hbmartin/tesla-iphone-holder/revisions/v3-draft/output/reference/console_bare.jpg

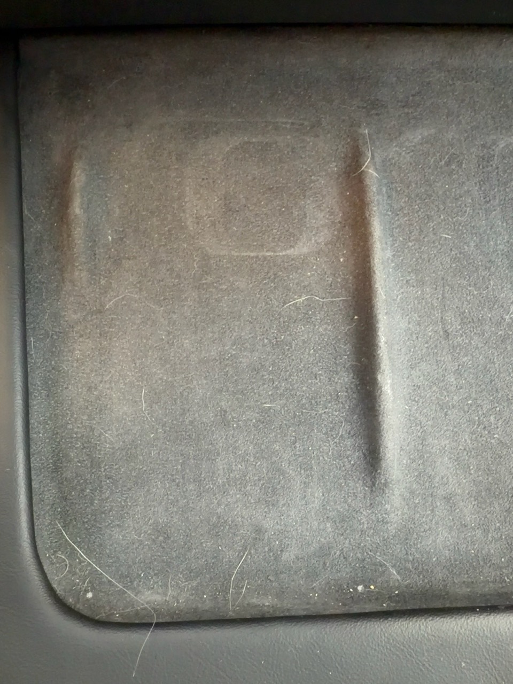
revisions/v3-draft/output/reference/console_bare.jpg
