hbmartin/tesla-iphone-holder/revisions/v3-draft/output/reference/fit_v2.jpg

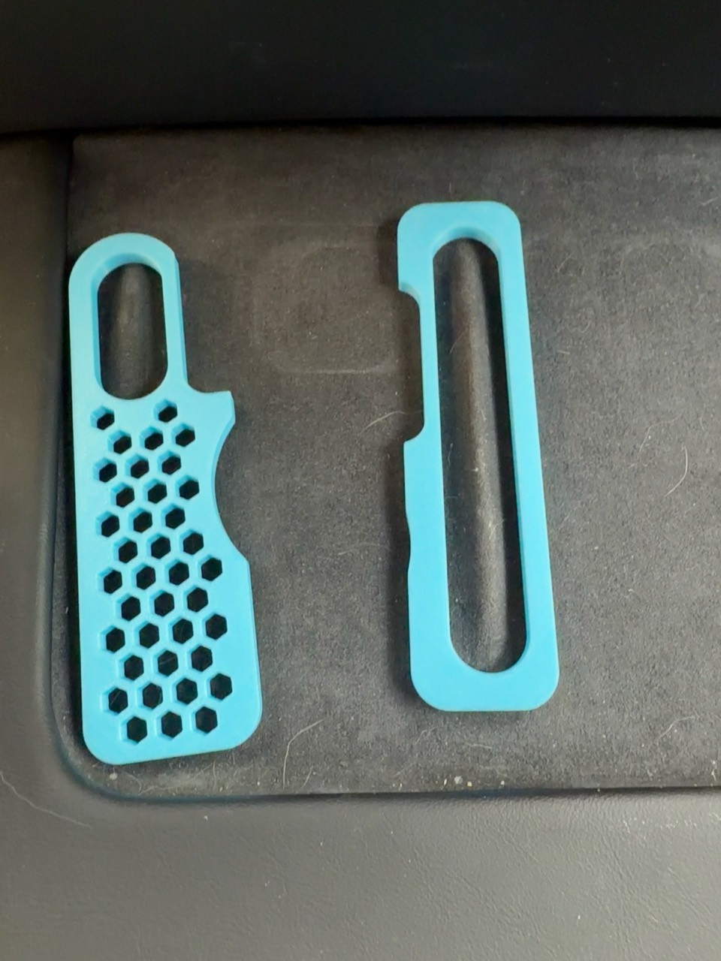
revisions/v3-draft/output/reference/fit_v2.jpg
