hbmartin/tesla-iphone-holder/output/pdf/contour_trace_grid_letter.pdf

# CONTOUR TRACING GRID

Profile ID: __________ Actual station / height: __________________________ Direction: __________ Repeat: ______ Date: __________ Pin spacing: _____

US Letter | Print at Actual size / 100% | 1 mm squares; heavier lines every 5 and 10 mm

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
0 | 0
10 | 10
20 | 20
30 | 30
40 | 40
50 | 50
60 | 60
70 | 70
80 | 80
90 | 90
100 | 100
110 | 110
120 | 120
130 | 130
140 | 140
150 | 150
160 | 160
170 | 170
180 | 180
190 | 190
200 | 200
210 | 210
100 mm - measure between the end ticks | Check this bar with a ruler.
| Also check 100 mm vertically.
Draw the console pad baseline and direction on your trace. Grid numbers are paper coordinates.
