hbmartin/tesla-iphone-holder/output/v9/outward_face_down/README.txt

V9 — OUTWARD FACE DOWN
Prepared at the user's request on 2026-11-05.

Both inserts are rigidly rotated so the face pointing outward from the console
faces the build plate. Its main tapered plane is leveled onto the plate.
The X rotation is 178.8285409 degrees: a flip plus compensation for the 1.1714591
degree taper. This is a rotation, not a mirror or geometry modification.
The console-facing underside and wider nub openings face upward during printing.

Use Holder_V9_A1_PLA_OUTWARD_FACE_DOWN.gcode.3mf for the sliced plate, or
Holder_V9_A1_PLA_OUTWARD_FACE_DOWN_SLICED.3mf for the Studio-saved project.
The STLs in THIS directory are already oriented for printing. The original V9
installed-coordinate CAD/STLs and previous plate remain in the parent directory.

Bambu A1 / 0.4 mm nozzle / Generic PLA / textured PEI / 0.20 mm layers /
three walls / 20% gyroid / no brim / automatic normal snug supports from bed.
Support threshold 45 degrees, top separation 0.20 mm, XY separation 0.35 mm.
The nub walls widen upward in this orientation. Automatic supports remain for
recessed phone-contact regions and console edge transitions as required.
The small recessed contact regions cannot all lie on the same plane; the main
outward taper plane rests directly on the bed, with over 3000 square mm of
contact area per part. Original part dimensions remain unchanged.

Validation checks the rigid transform, source hashes, downward outward-plane
normal, bed contact, volume, actual sliced layers, supports, thin original lower
edges, embedded settings and the Studio-saved geometry/G-code.
Verified Studio estimate: 54 min 33 sec; 19.63 g PLA.
Geometry, orientation, model layers, supports and Studio export checks passed.
Disable timelapse when sending to the printer. No job has been dispatched.
Physical fit and the retained lens-contact diagnostic remain unverified.
