hbmartin/tesla-iphone-holder/curve gauge photos/IMG_0162.jpeg

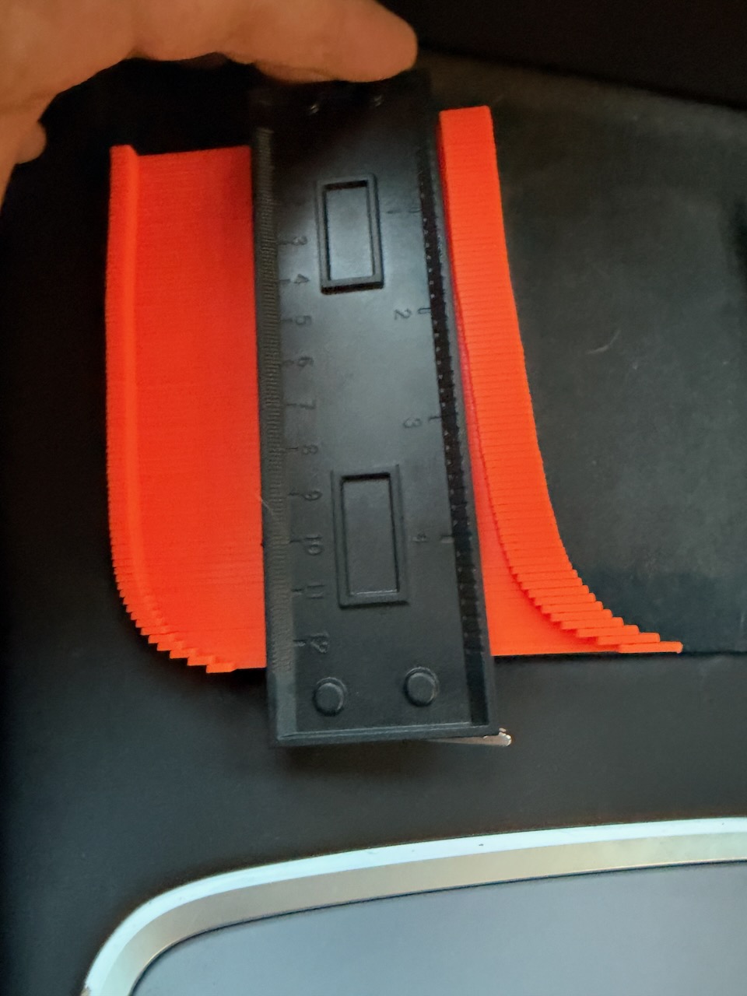
curve gauge photos/IMG_0162.jpeg
