hbmartin/tesla-iphone-holder/curve gauge photos/IMG_0163.jpeg

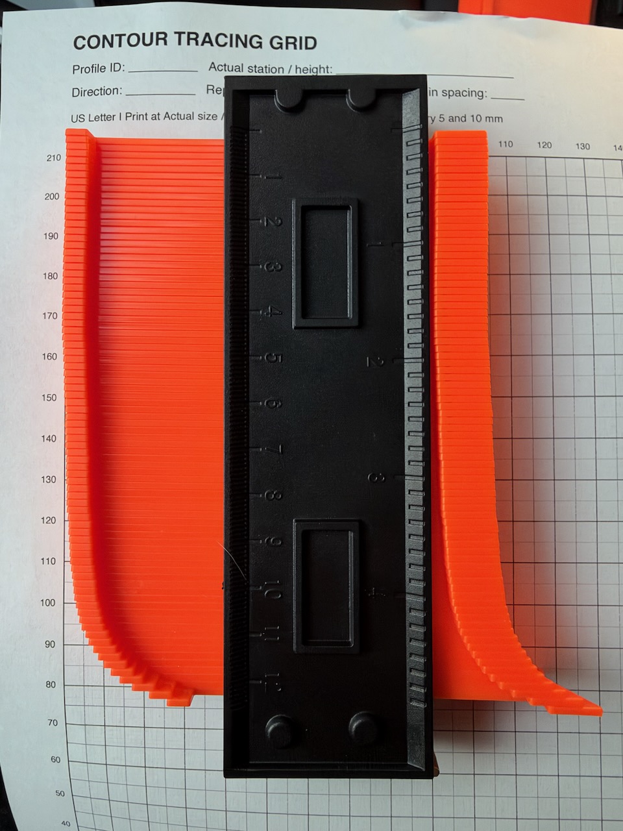
curve gauge photos/IMG_0163.jpeg
