hbmartin/tesla-iphone-holder/curve gauge photos/IMG_0164.jpeg

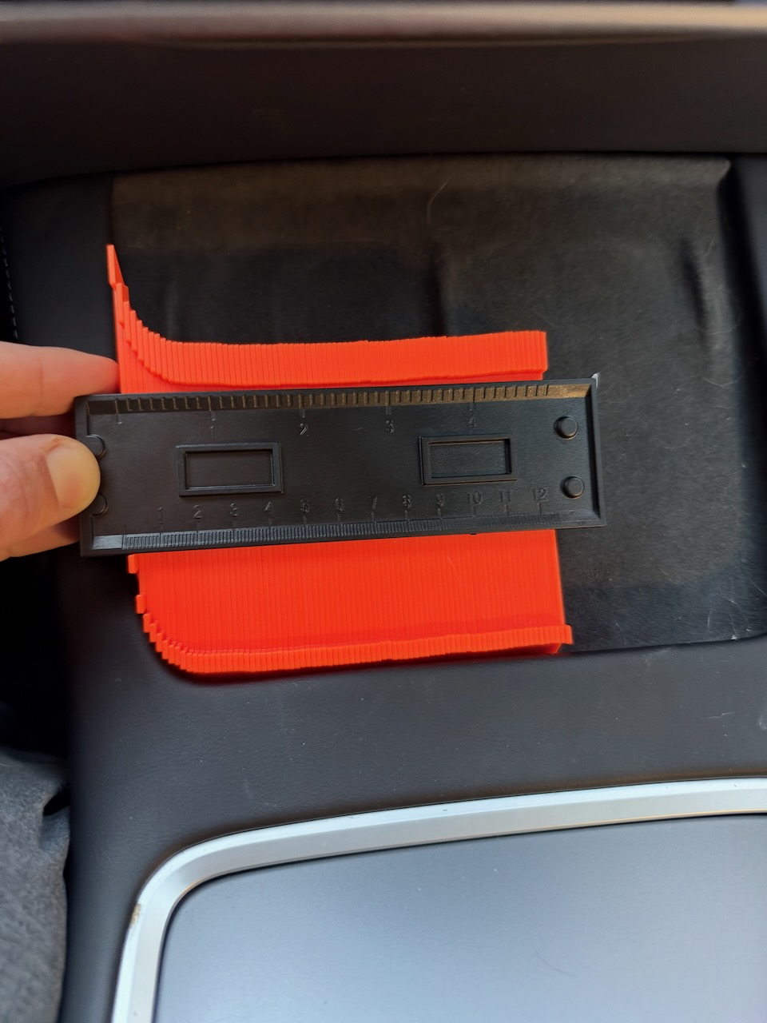
curve gauge photos/IMG_0164.jpeg
