hbmartin/tesla-iphone-holder/curve gauge photos/IMG_0165.jpeg

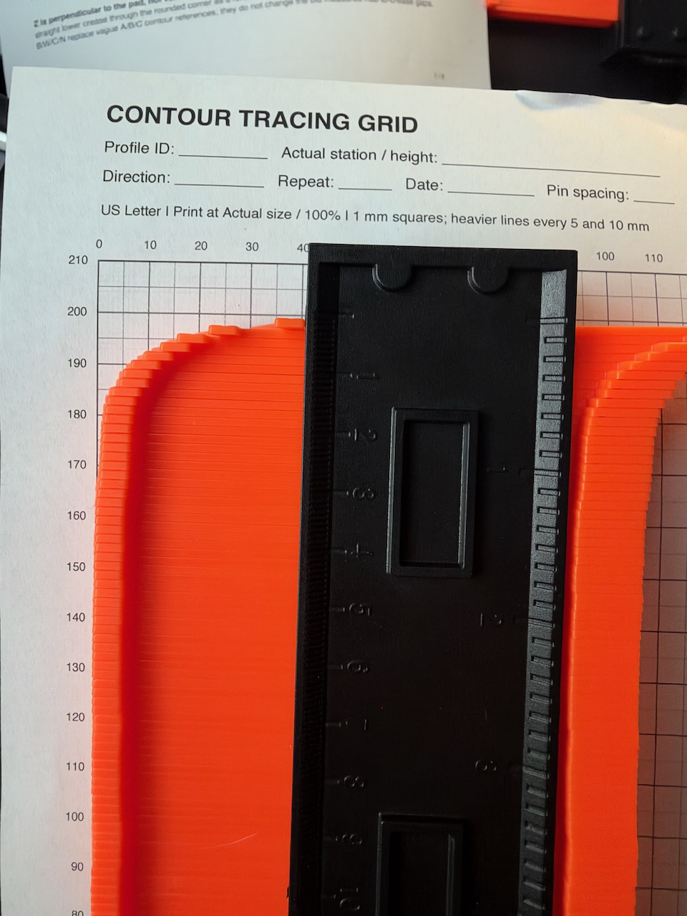
curve gauge photos/IMG_0165.jpeg
