hbmartin/tesla-iphone-holder/curve gauge photos/IMG_0167.jpeg

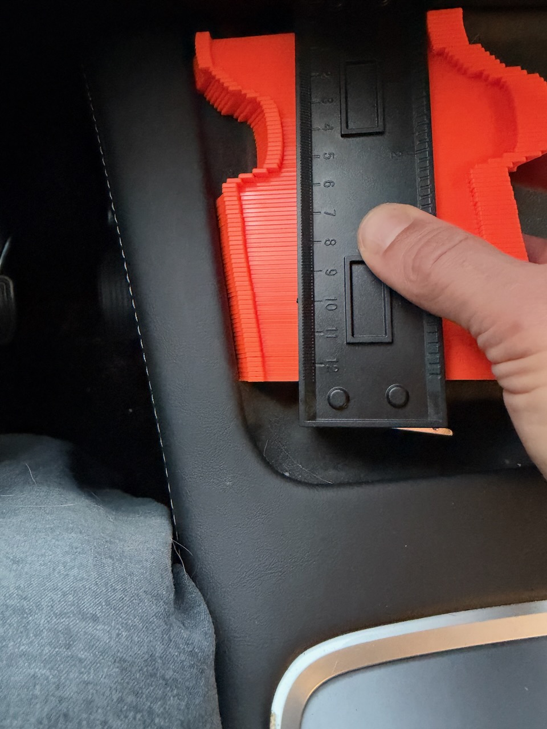
curve gauge photos/IMG_0167.jpeg
