hbmartin/tesla-iphone-holder/curve gauge photos/IMG_0168.jpeg

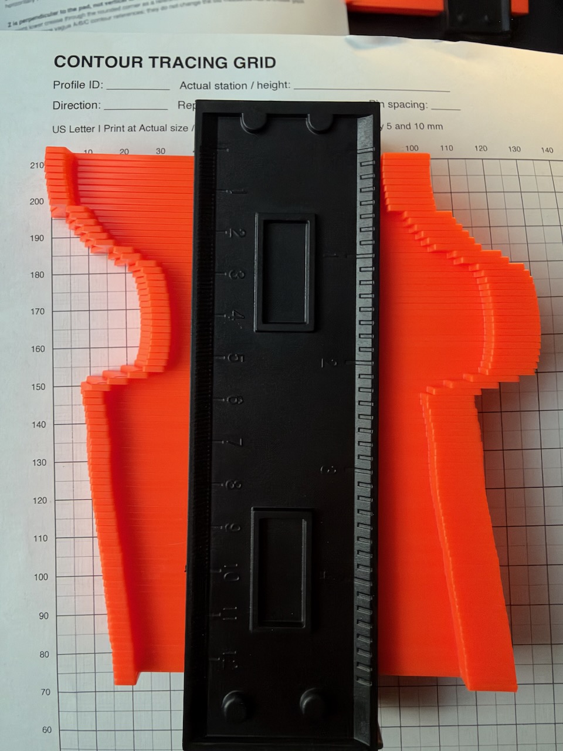
curve gauge photos/IMG_0168.jpeg
