hbmartin/tesla-iphone-holder/curve gauge photos/IMG_0169.jpeg

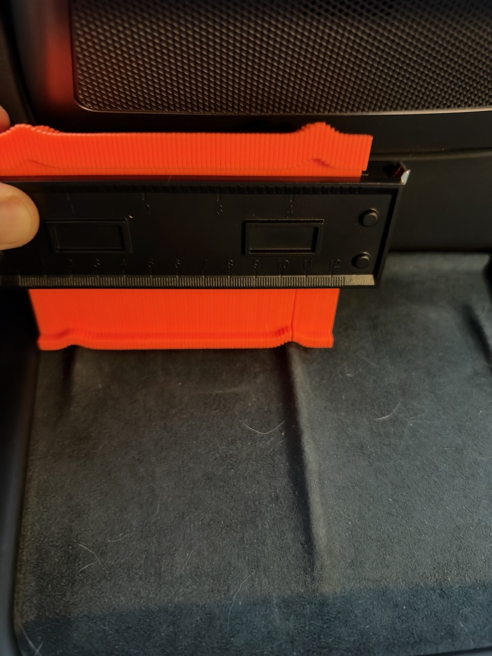
curve gauge photos/IMG_0169.jpeg
