hbmartin/tesla-iphone-holder/curve gauge photos/IMG_0170.jpeg

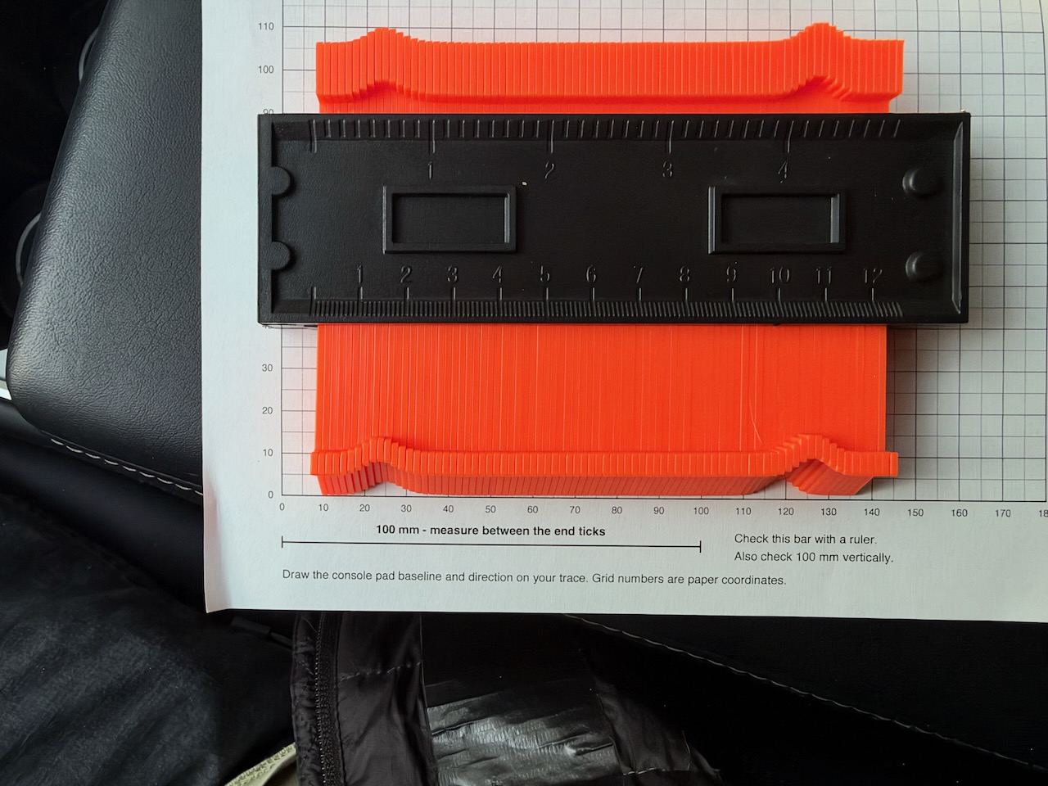
curve gauge photos/IMG_0170.jpeg
