hbmartin/tesla-iphone-holder/curve gauge photos/IMG_0171.jpeg

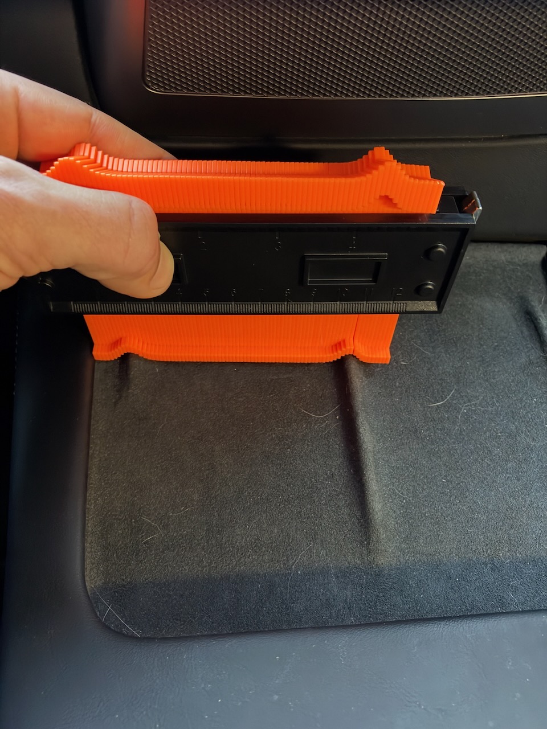
curve gauge photos/IMG_0171.jpeg
