hbmartin/tesla-iphone-holder/curve gauge photos/IMG_0172.jpeg

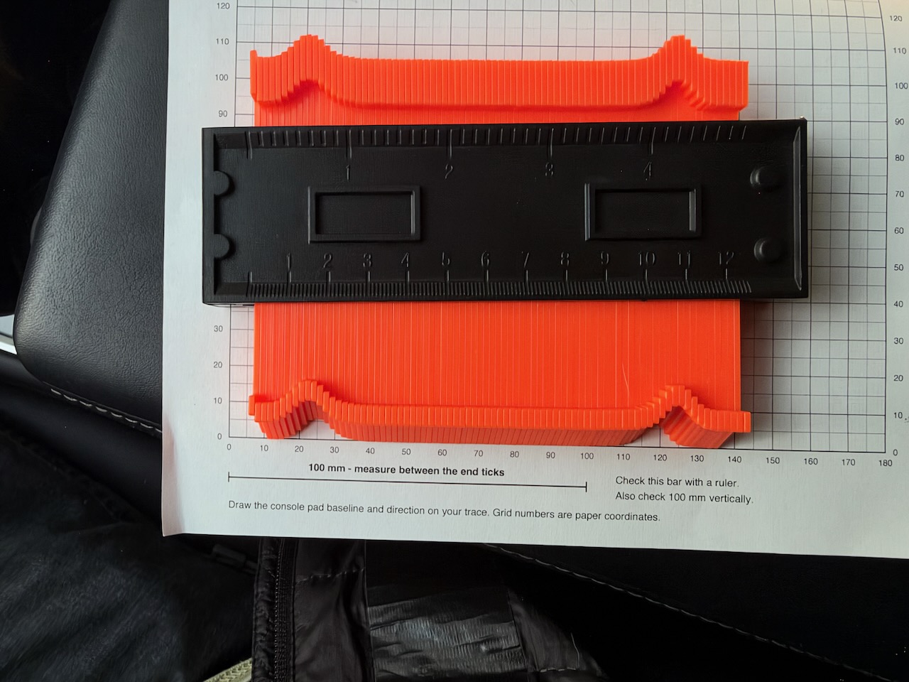
curve gauge photos/IMG_0172.jpeg
