hbmartin/tesla-iphone-holder/curve gauge photos/IMG_0173.jpeg

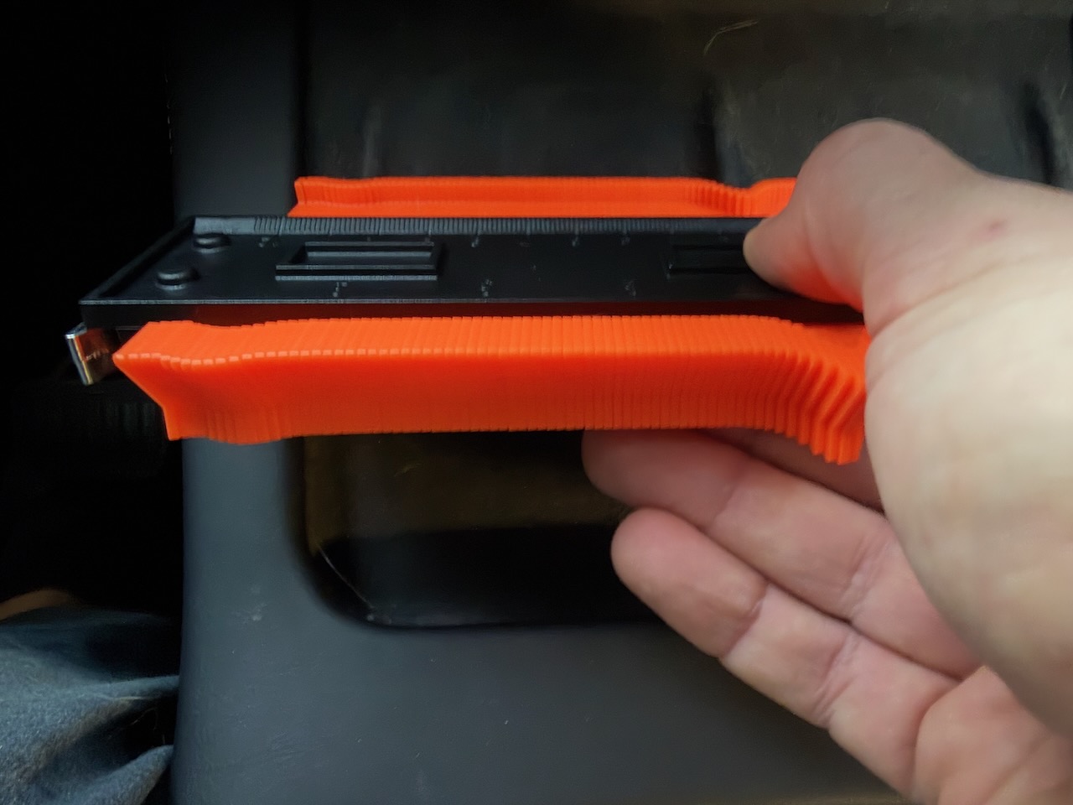
curve gauge photos/IMG_0173.jpeg
