hbmartin/tesla-iphone-holder/curve gauge photos/IMG_0174.jpeg

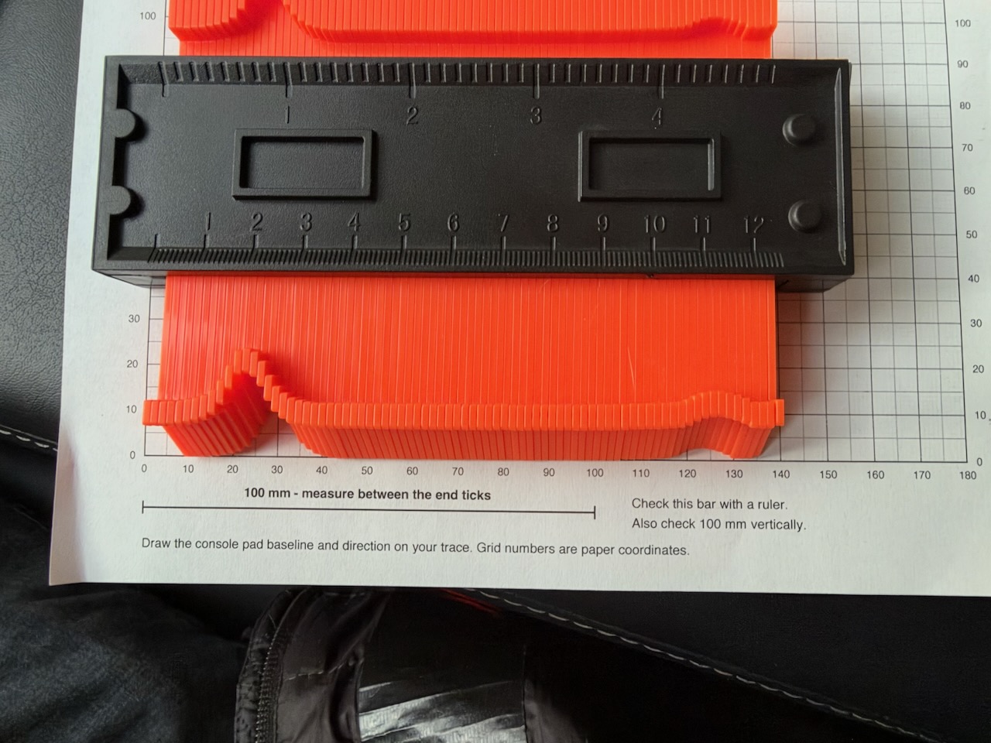
curve gauge photos/IMG_0174.jpeg
