hbmartin/tesla-iphone-holder/curve gauge photos/IMG_0175.jpeg

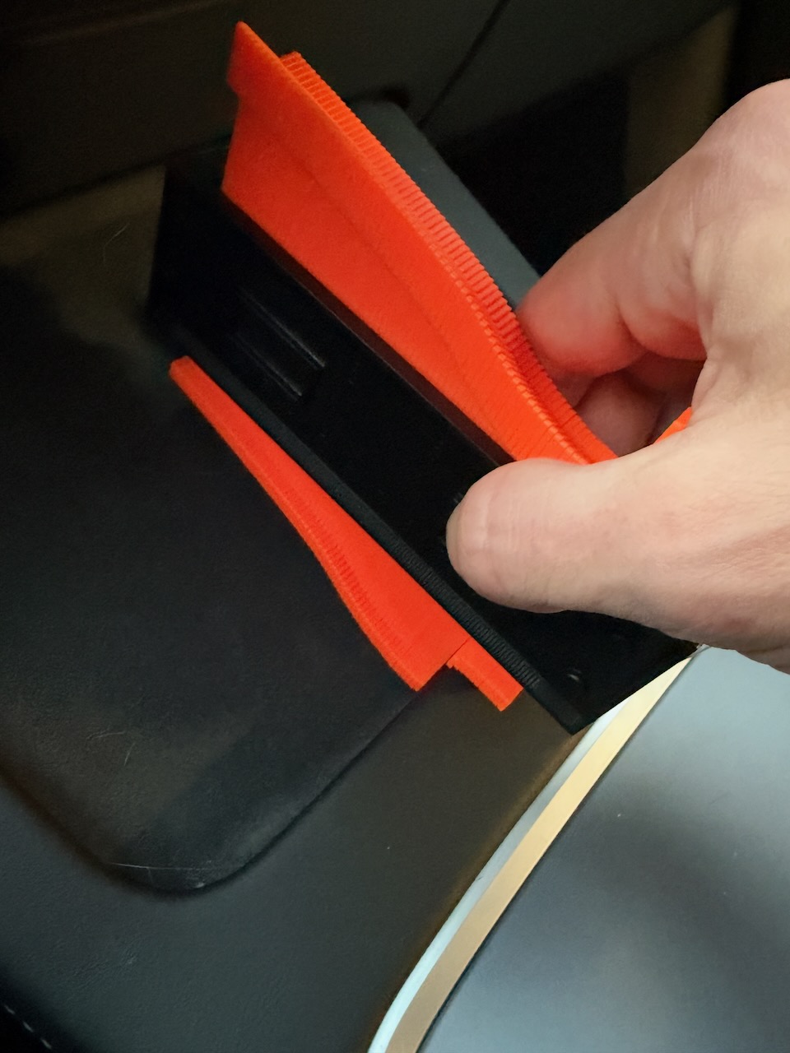
curve gauge photos/IMG_0175.jpeg
