hbmartin/tesla-iphone-holder/curve gauge photos/IMG_0176.jpeg

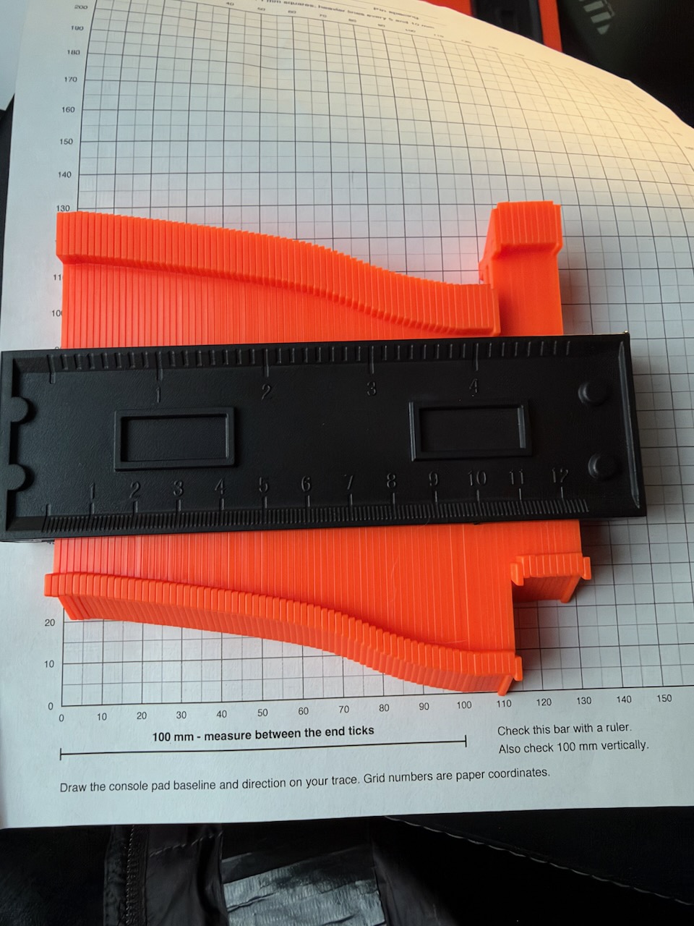
curve gauge photos/IMG_0176.jpeg
