hbmartin/tesla-iphone-holder/curve gauge photos/IMG_0177.jpeg

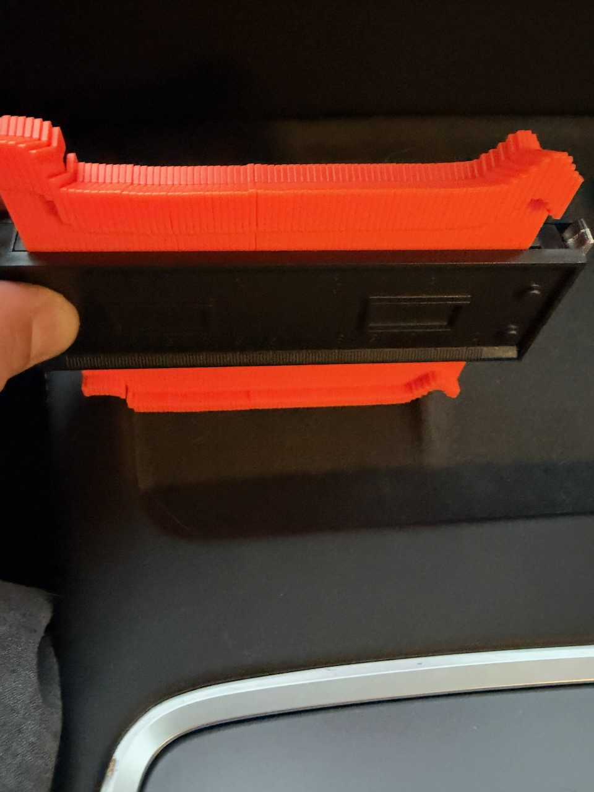
curve gauge photos/IMG_0177.jpeg
