hbmartin/tesla-iphone-holder/curve gauge photos/IMG_0178.jpeg

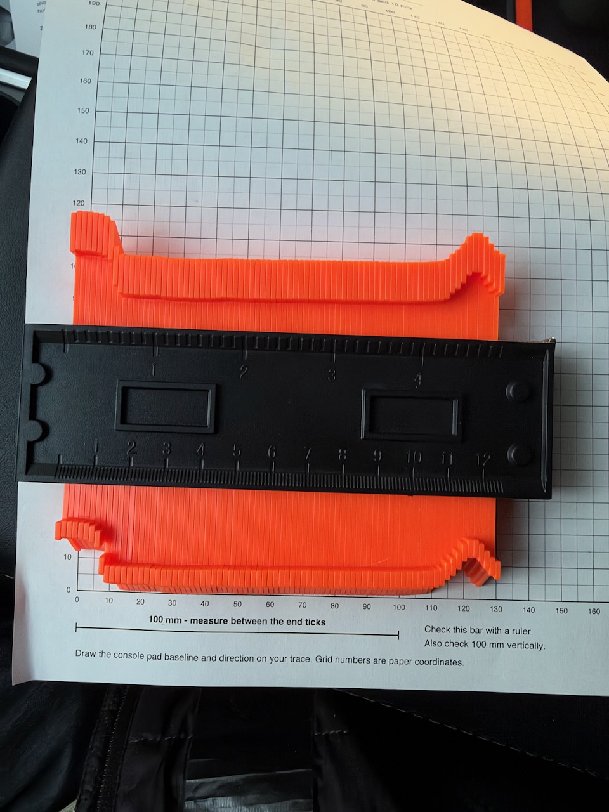
curve gauge photos/IMG_0178.jpeg
