hbmartin/tesla-iphone-holder/curve gauge photos/IMG_0179.jpeg

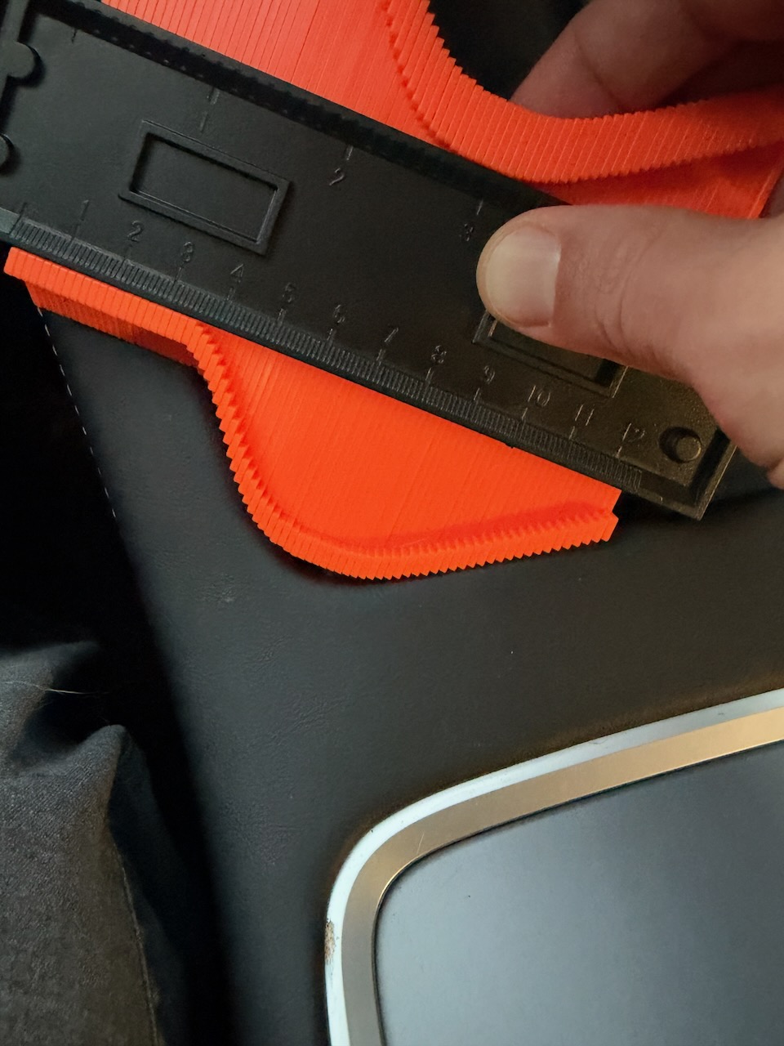
curve gauge photos/IMG_0179.jpeg
