hbmartin/tesla-iphone-holder/curve gauge photos/IMG_0180.jpeg

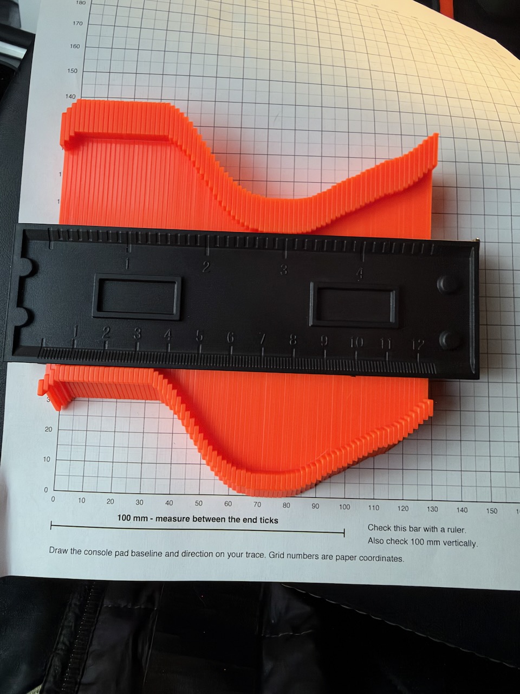
curve gauge photos/IMG_0180.jpeg
