hbmartin/tesla-iphone-holder/IMG_0084.jpeg

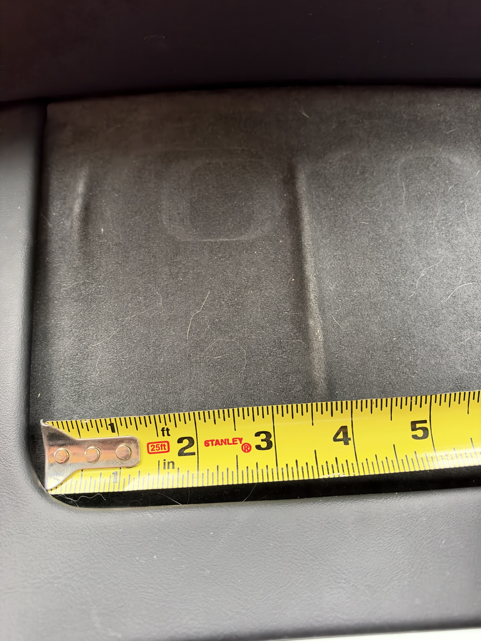
IMG_0084.jpeg
