hbmartin/tesla-iphone-holder/IMG_0085.jpeg

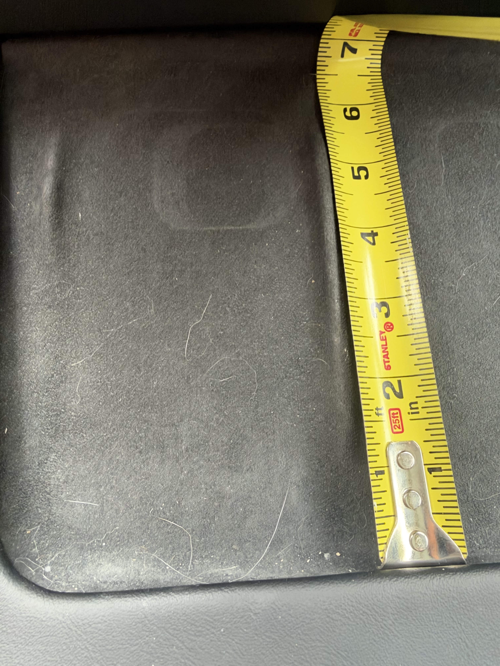
IMG_0085.jpeg
