hbmartin/tesla-iphone-holder/IMG_0086.jpeg

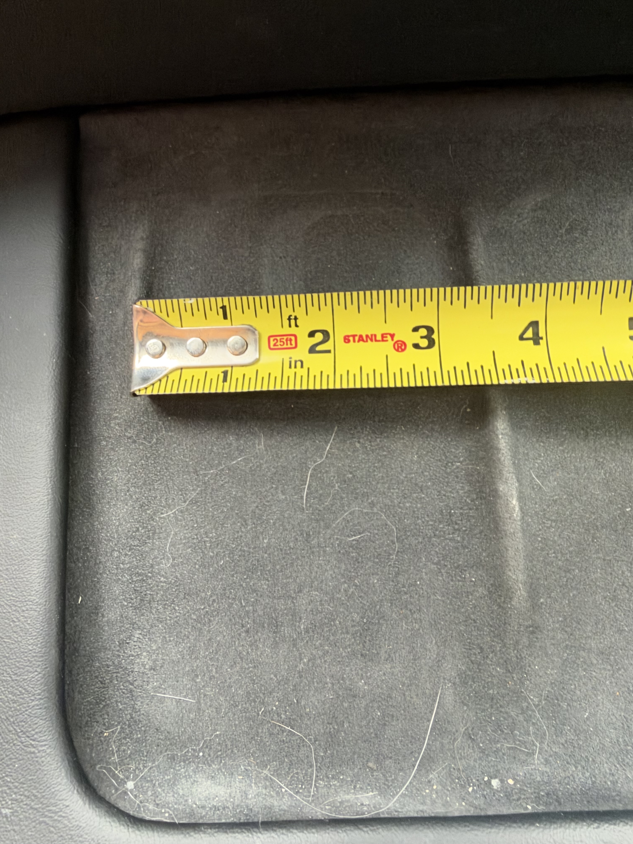
IMG_0086.jpeg
