hbmartin/tesla-iphone-holder/IMG_0196.jpeg

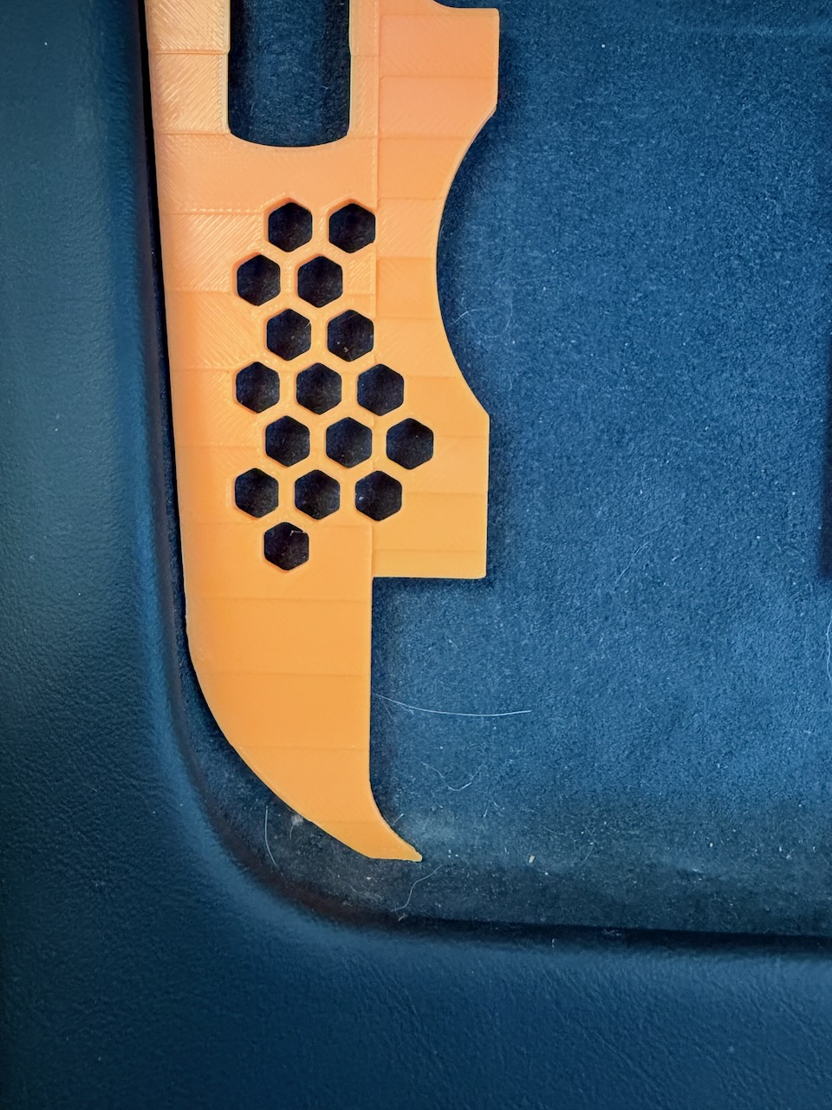
IMG_0196.jpeg
