hbmartin/tesla-iphone-holder/IMG_0197.jpeg

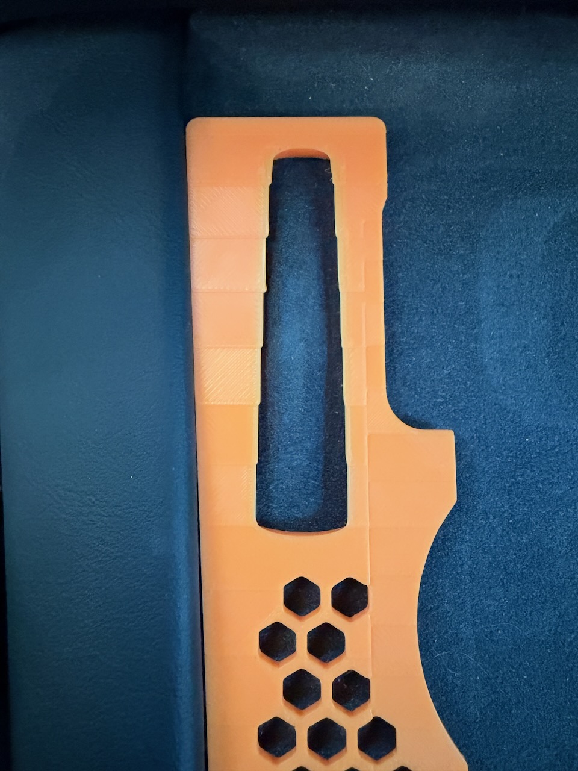
IMG_0197.jpeg
