hbmartin/tesla-iphone-holder/IMG_0198.jpeg

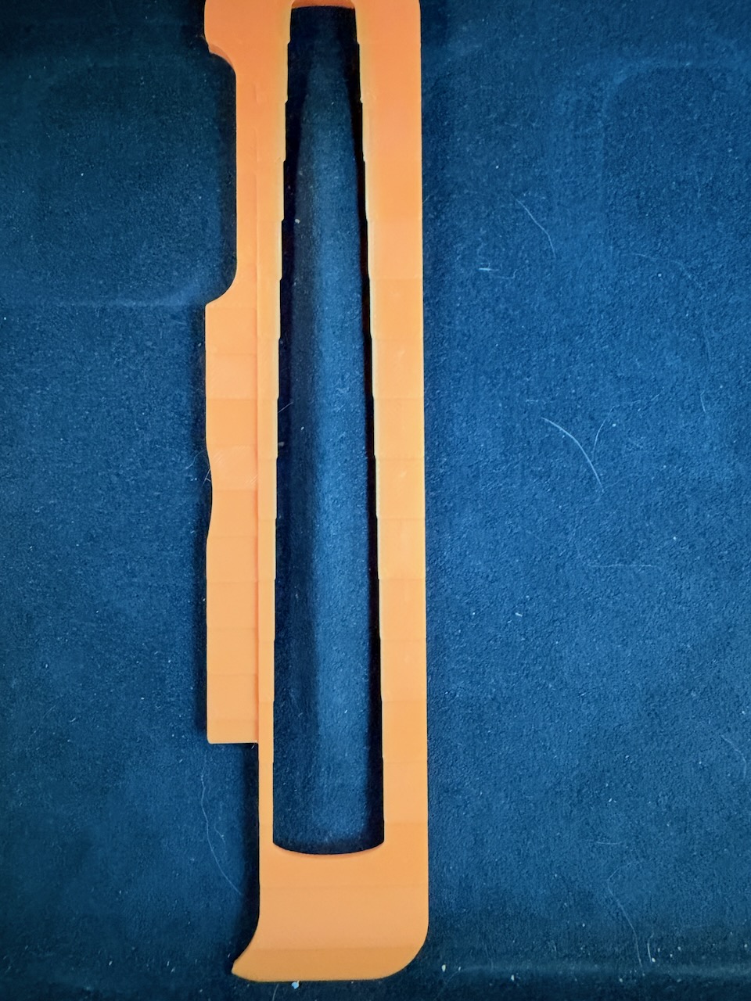
IMG_0198.jpeg
