hbmartin/tesla-iphone-holder/IMG_0201.jpeg

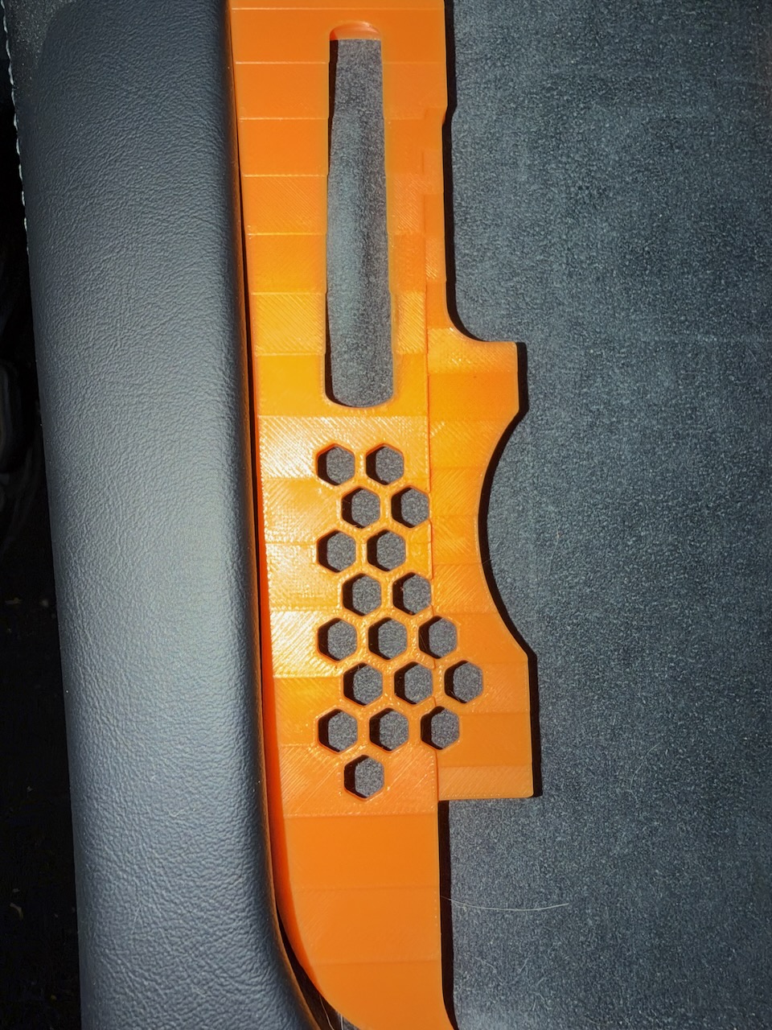
IMG_0201.jpeg
