hbmartin/tesla-iphone-holder/IMG_0202.jpeg

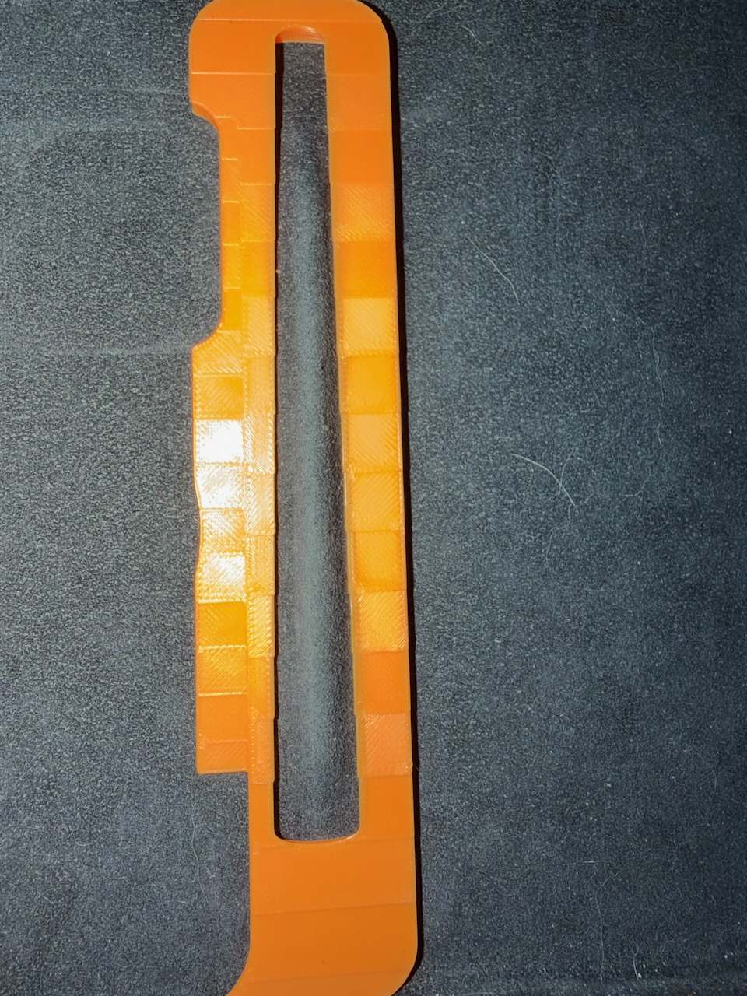
IMG_0202.jpeg
