hbmartin/tesla-iphone-holder/IMG_0203.jpeg

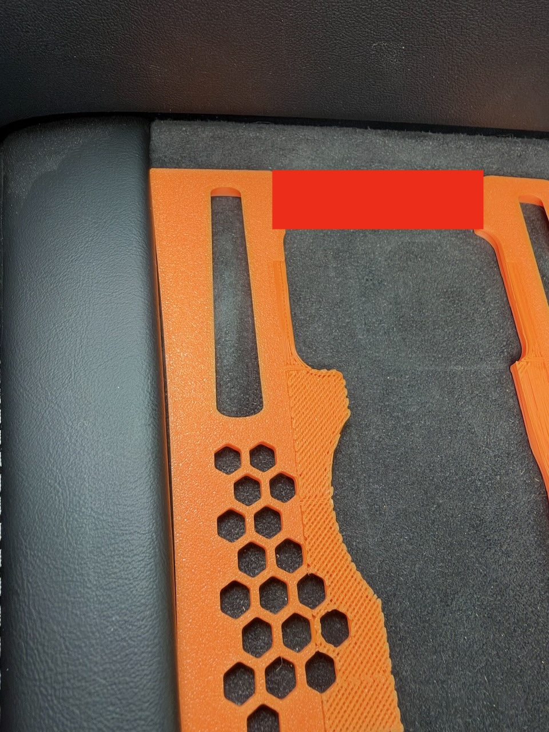
IMG_0203.jpeg
