hbmartin/tesla-iphone-holder/IMG_0204.jpeg

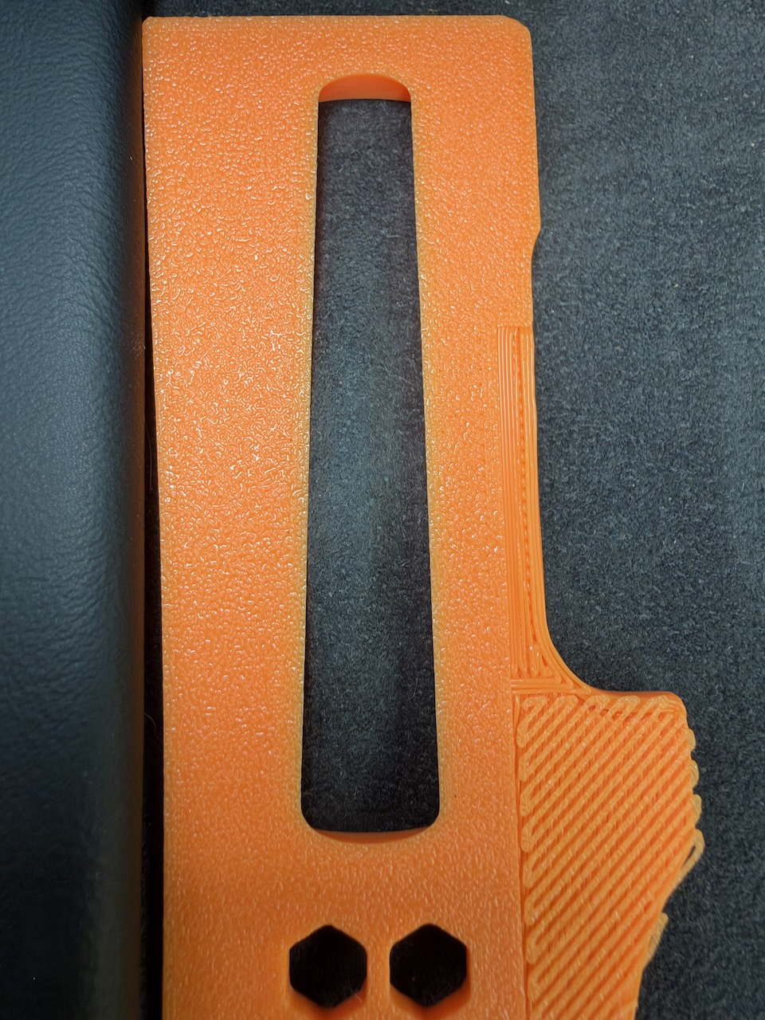
IMG_0204.jpeg
