hbmartin/tesla-iphone-holder/new gauge photos/IMG_0182.jpeg

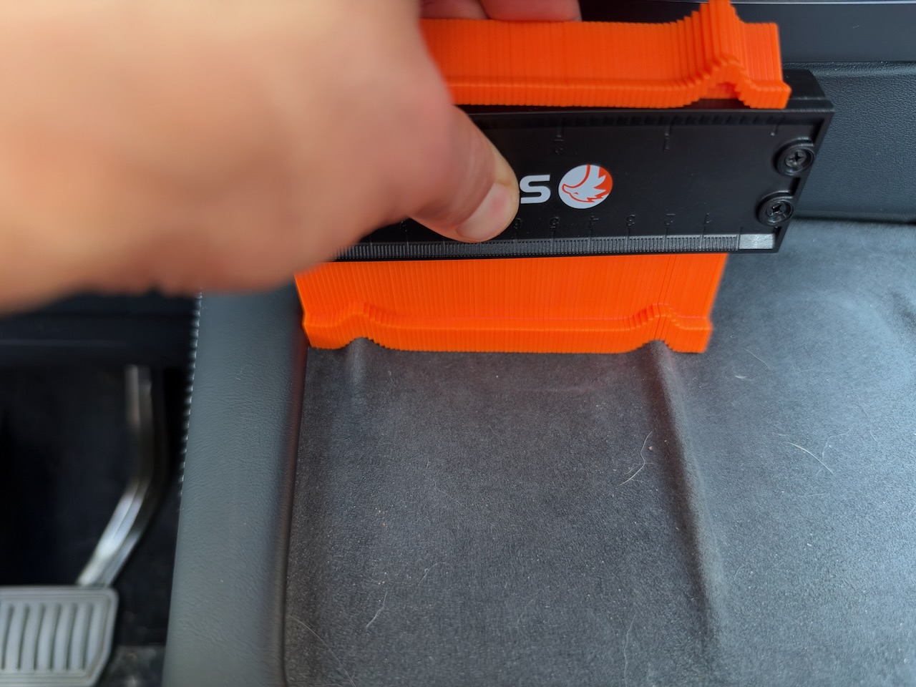
new gauge photos/IMG_0182.jpeg
