hbmartin/tesla-iphone-holder/new gauge photos/IMG_0183.jpeg

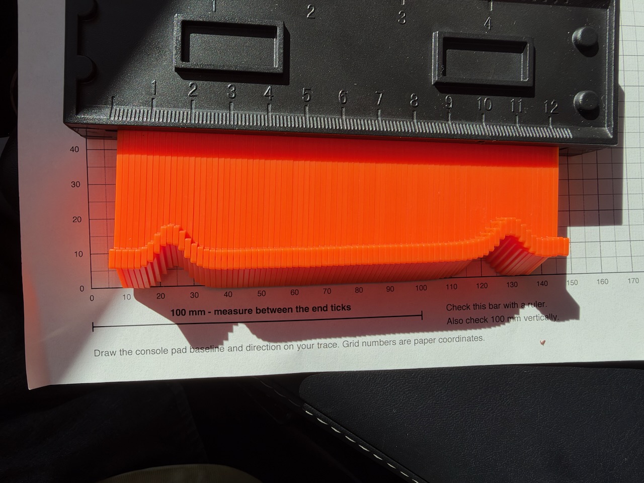
new gauge photos/IMG_0183.jpeg
