hbmartin/tesla-iphone-holder/new gauge photos/IMG_0184.jpeg

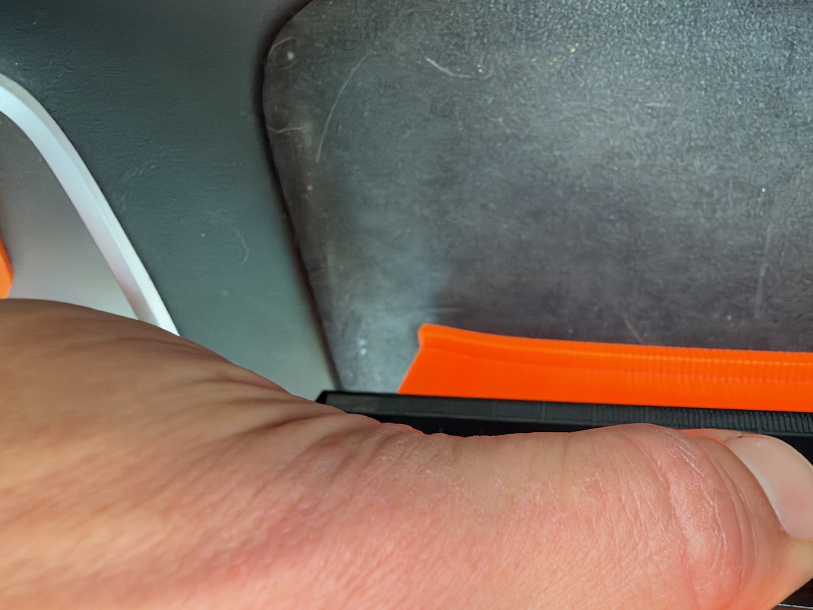
new gauge photos/IMG_0184.jpeg
