hbmartin/tesla-iphone-holder/new gauge photos/IMG_0185.jpeg

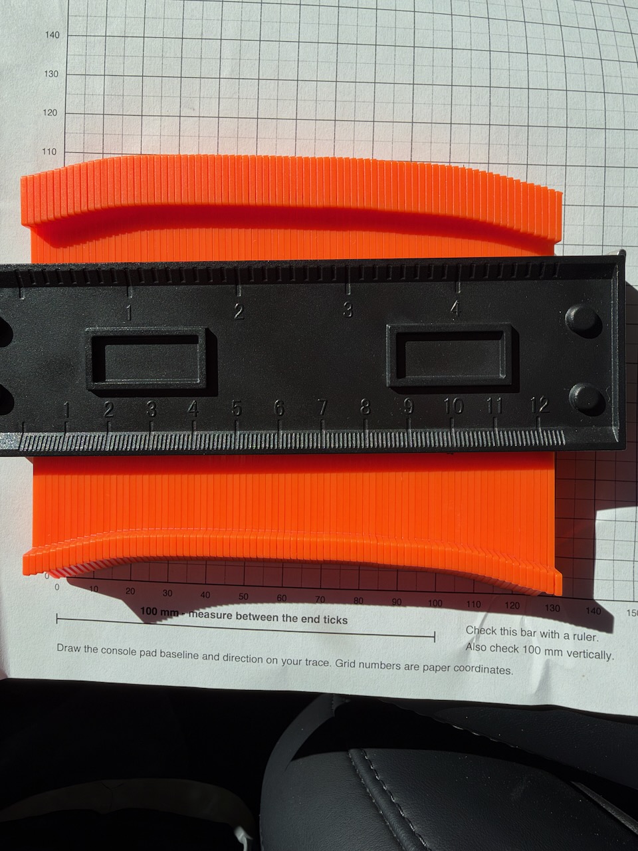
new gauge photos/IMG_0185.jpeg
