hbmartin/tesla-iphone-holder/new gauge photos/IMG_0186.jpeg

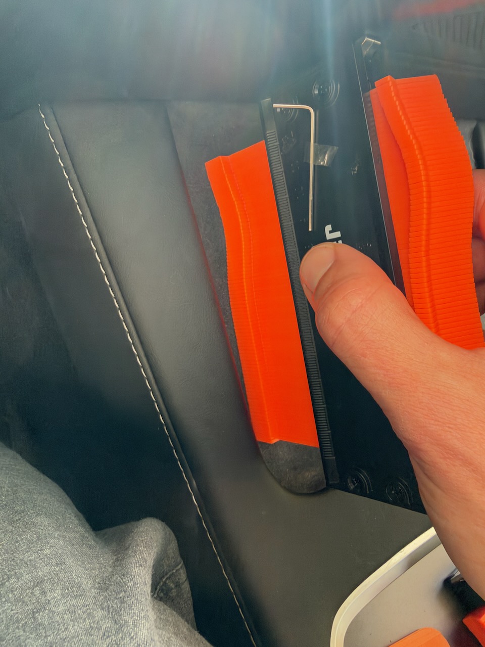
new gauge photos/IMG_0186.jpeg
