hbmartin/tesla-iphone-holder/new gauge photos/IMG_0187.jpeg

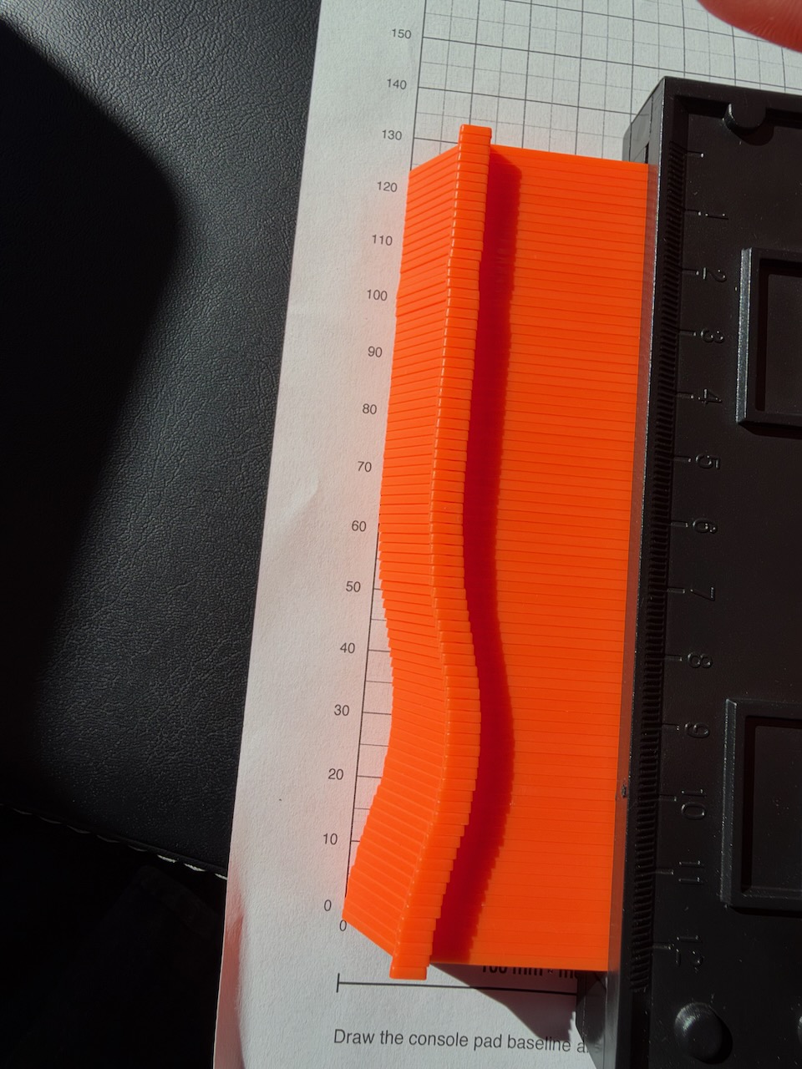
new gauge photos/IMG_0187.jpeg
