hbmartin/tesla-iphone-holder/new gauge photos/IMG_0188.jpeg

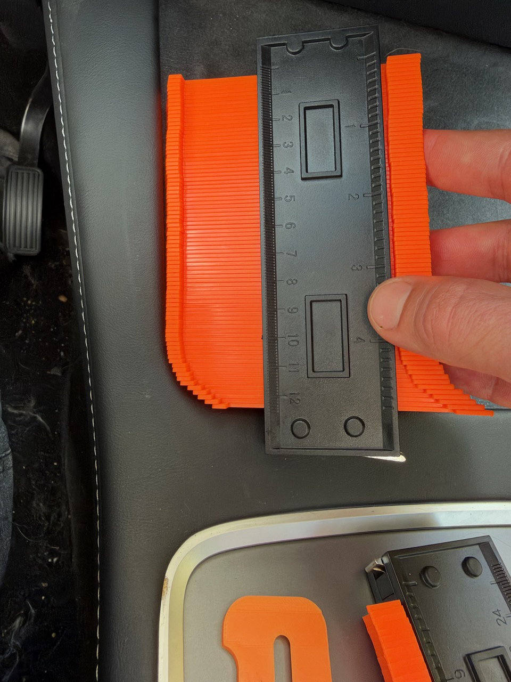
new gauge photos/IMG_0188.jpeg
