hbmartin/tesla-iphone-holder/new gauge photos/IMG_0189.jpeg

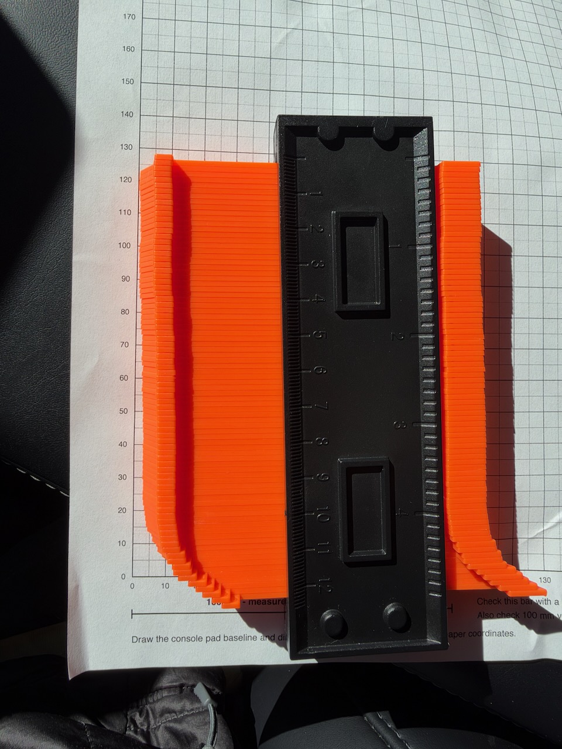
new gauge photos/IMG_0189.jpeg
