hbmartin/tesla-iphone-holder/new gauge photos/IMG_0190.jpeg

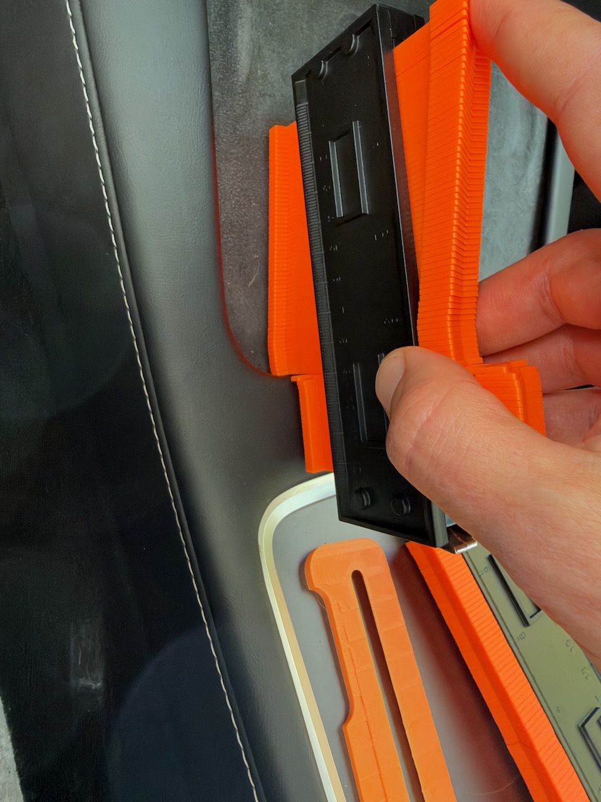
new gauge photos/IMG_0190.jpeg
