hbmartin/tesla-iphone-holder/new gauge photos/IMG_0191.jpeg

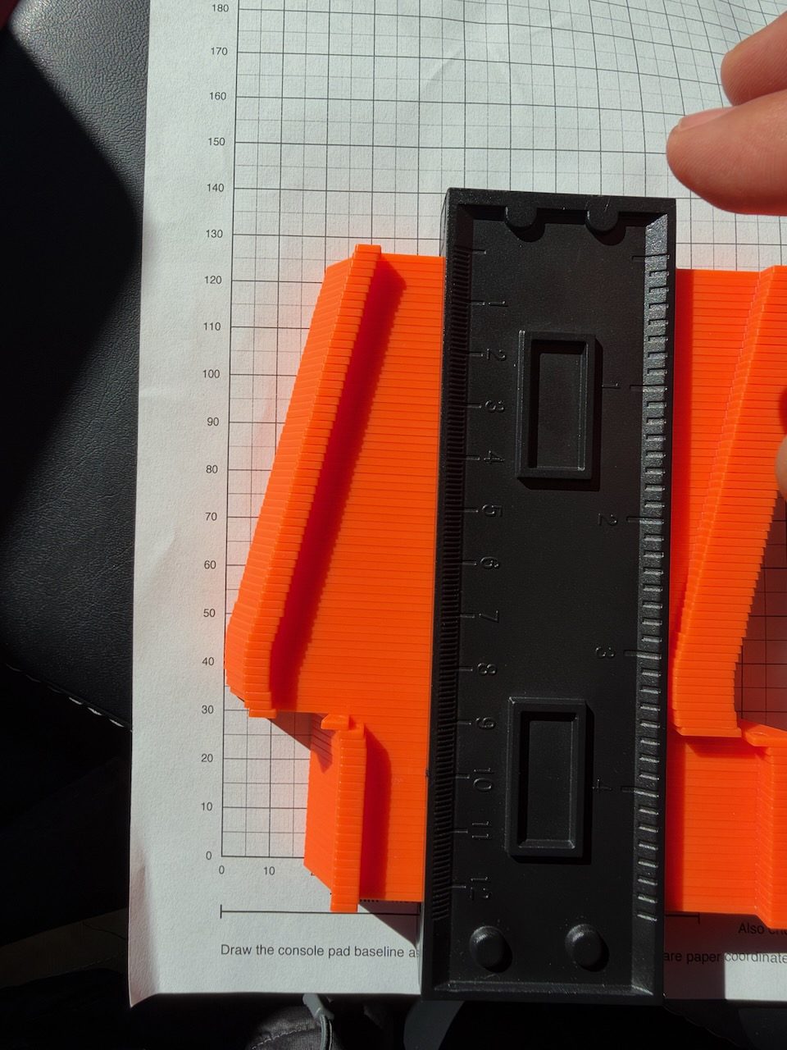
new gauge photos/IMG_0191.jpeg
