hbmartin/tesla-iphone-holder/new gauge photos/IMG_0192.jpeg

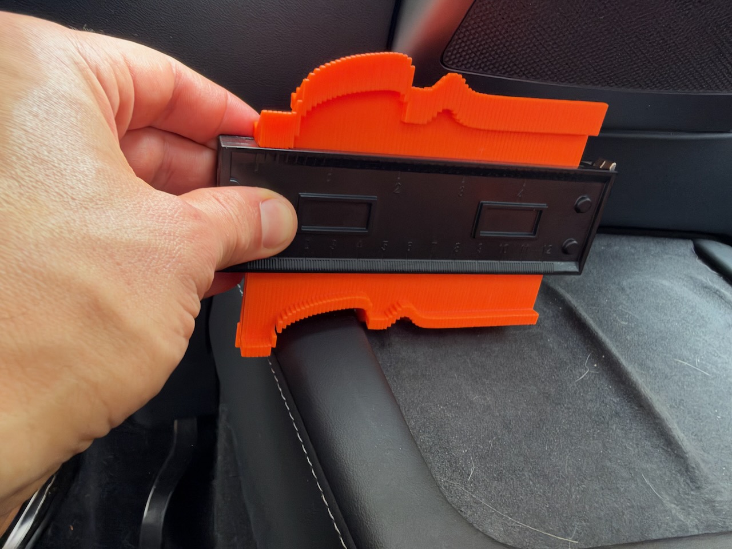
new gauge photos/IMG_0192.jpeg
