hbmartin/tesla-iphone-holder/new gauge photos/IMG_0193.jpeg

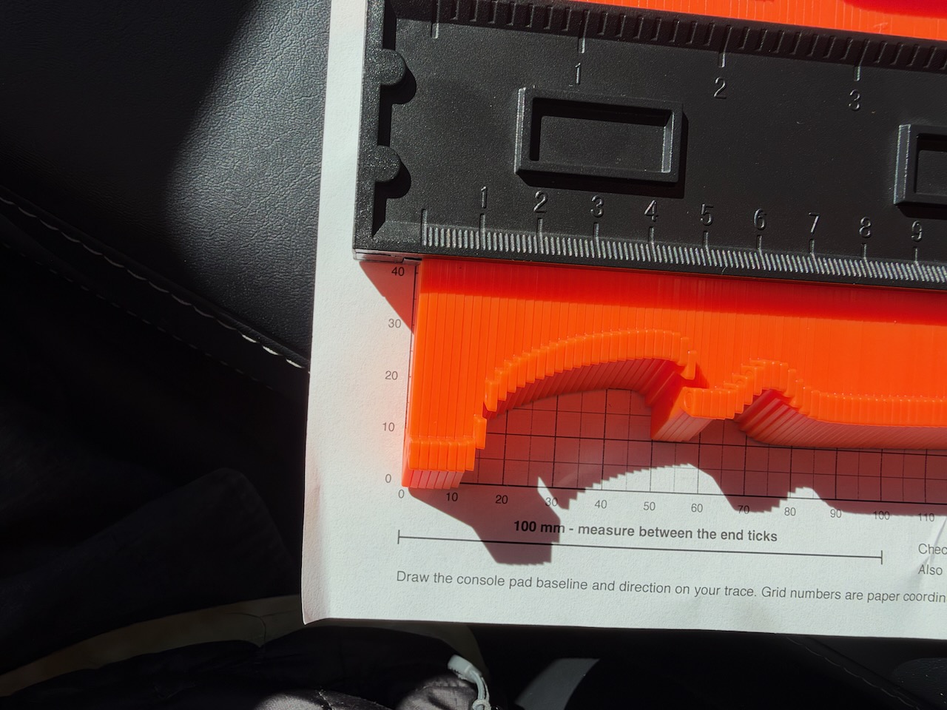
new gauge photos/IMG_0193.jpeg
