hbmartin/tesla-iphone-holder/new gauge photos/IMG_0194.jpeg

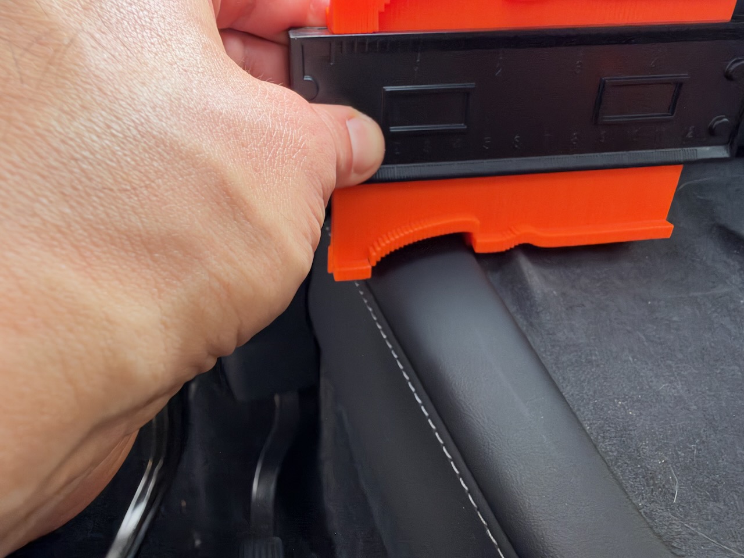
new gauge photos/IMG_0194.jpeg
