hbmartin/tesla-iphone-holder/new gauge photos/IMG_0195.jpeg

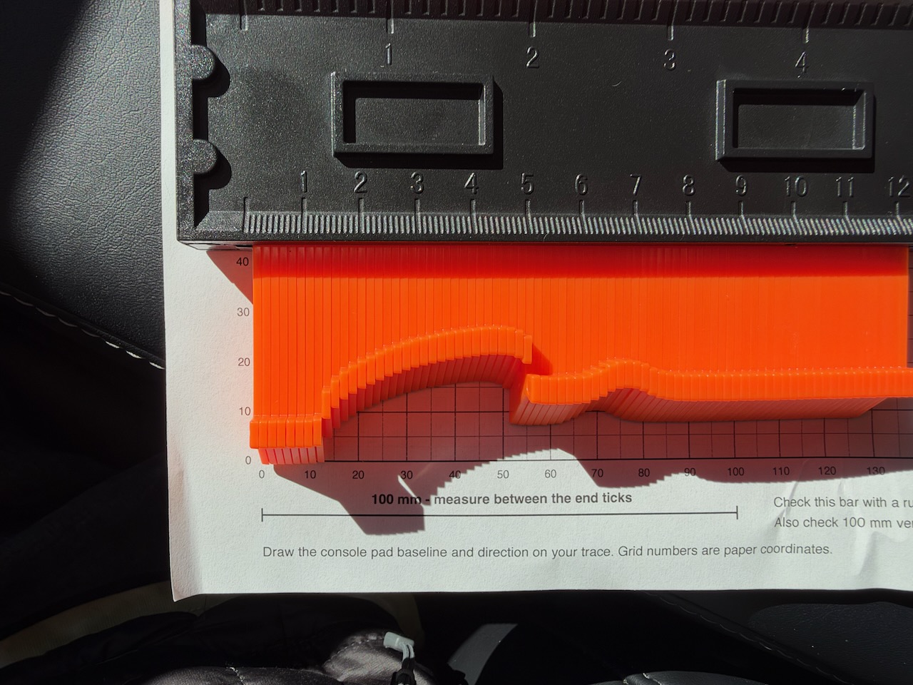
new gauge photos/IMG_0195.jpeg
