hbmartin/tesla-iphone-holder/output/curve-review/P1_profile.png

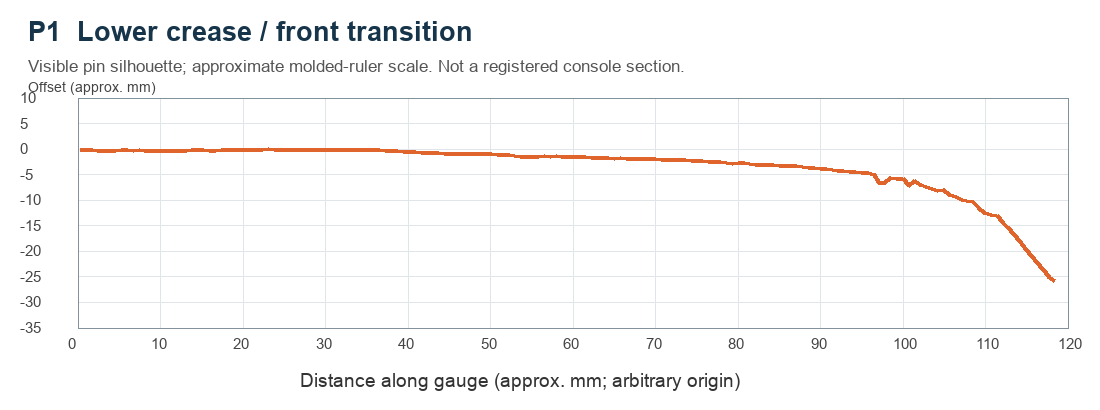
output/curve-review/P1_profile.png
