hbmartin/tesla-iphone-holder/output/curve-review/P2_profile.png

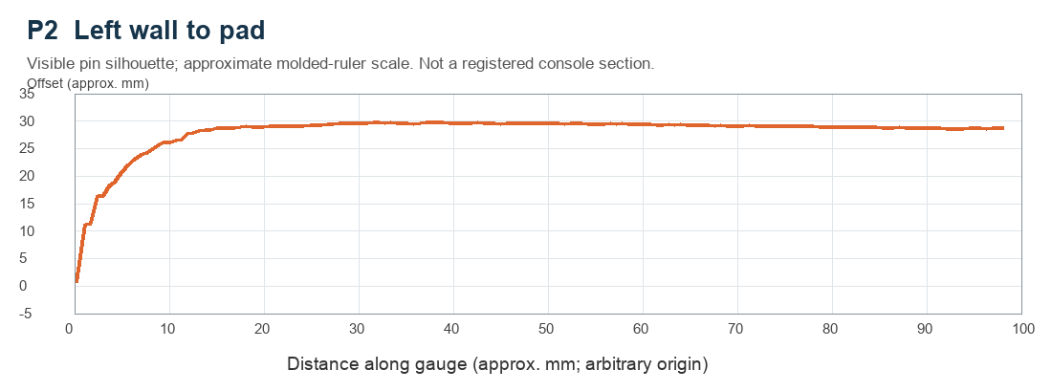
output/curve-review/P2_profile.png
