hbmartin/tesla-iphone-holder/output/curve-review/P3_profile.png

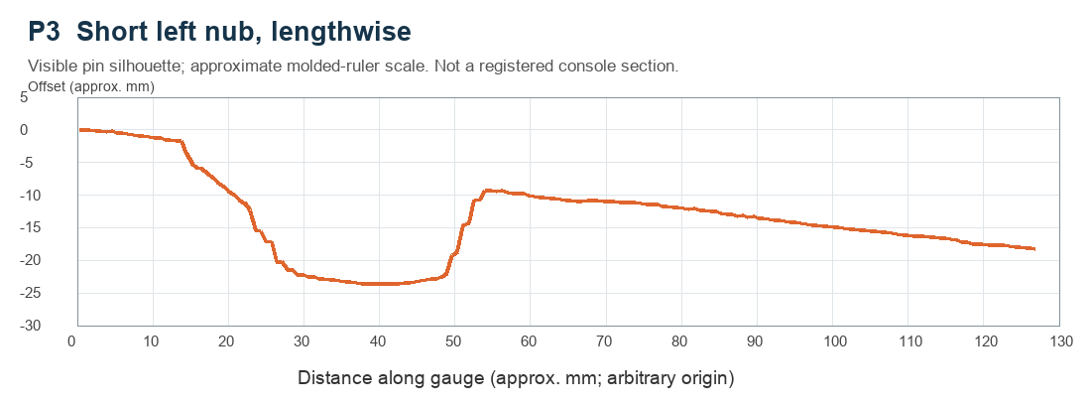
output/curve-review/P3_profile.png
