hbmartin/tesla-iphone-holder/output/curve-review/P4_profile.png

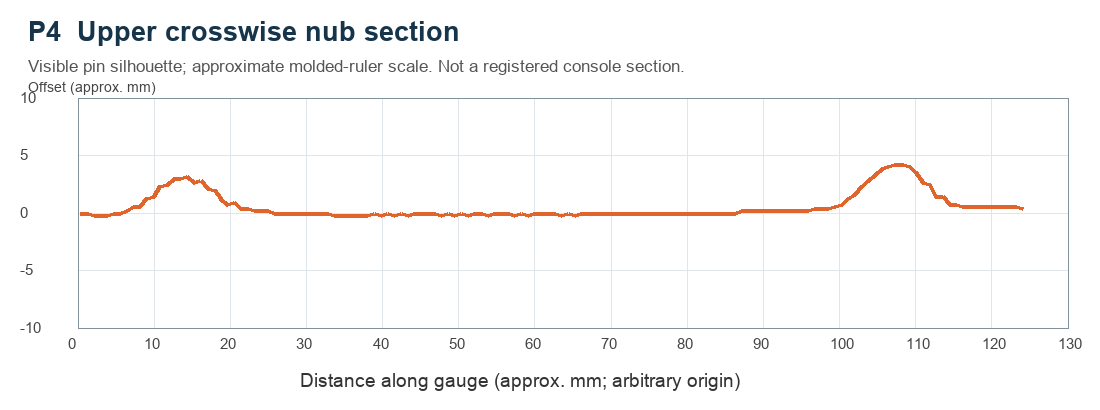
output/curve-review/P4_profile.png
