hbmartin/tesla-iphone-holder/output/curve-review/P5_profile.png

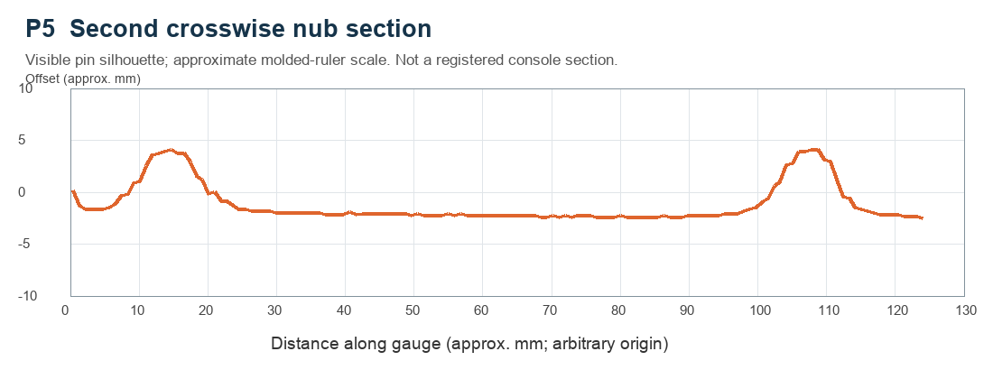
output/curve-review/P5_profile.png
