hbmartin/tesla-iphone-holder/output/curve-review/P6_profile.png

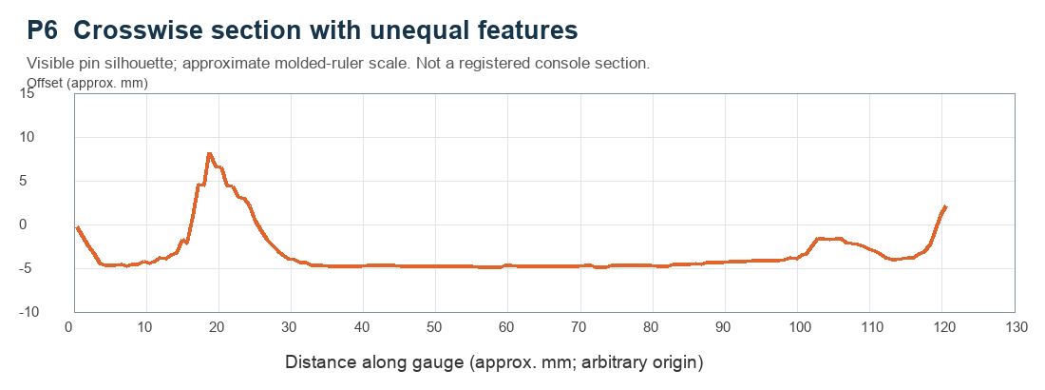
output/curve-review/P6_profile.png
