hbmartin/tesla-iphone-holder/output/curve-review/P7_profile.png

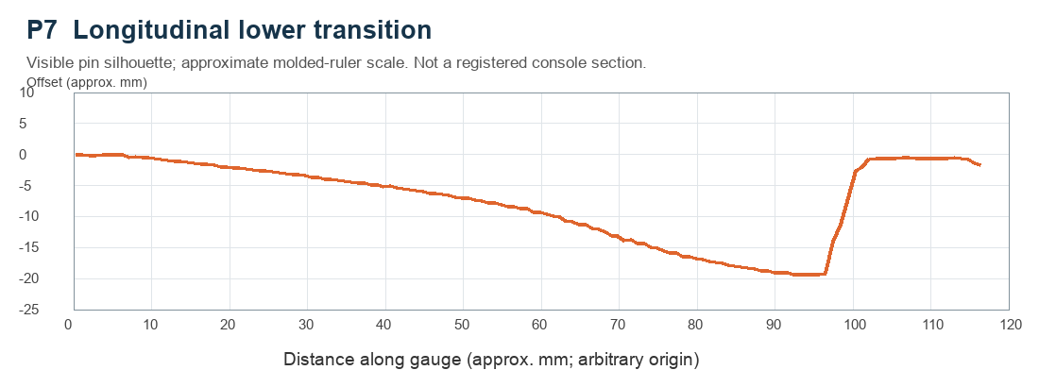
output/curve-review/P7_profile.png
