hbmartin/tesla-iphone-holder/output/curve-review/P8_profile.png

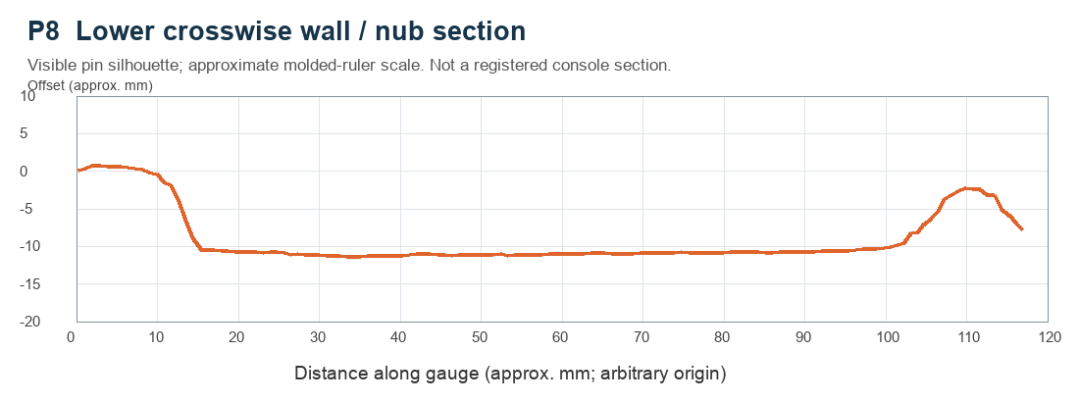
output/curve-review/P8_profile.png
