hbmartin/tesla-iphone-holder/output/curve-review/P9_profile.png

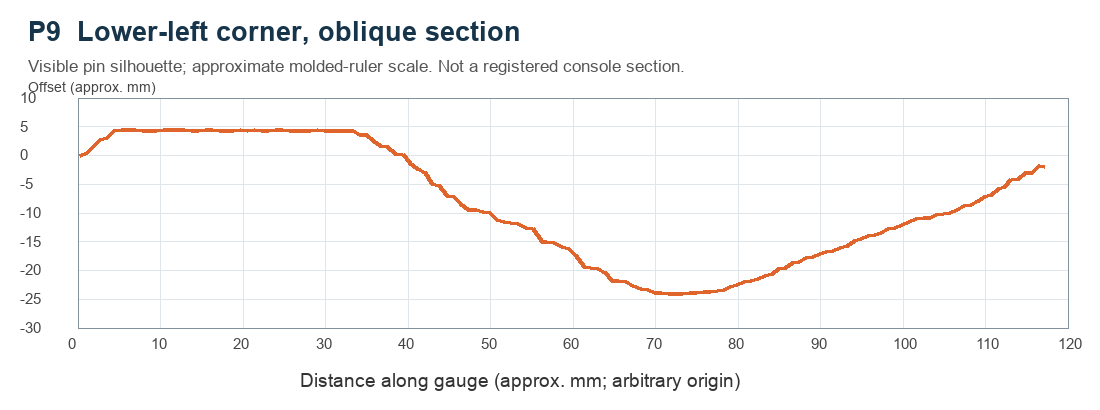
output/curve-review/P9_profile.png
