hbmartin/tesla-iphone-holder/output/curve-review/profile_overview.png

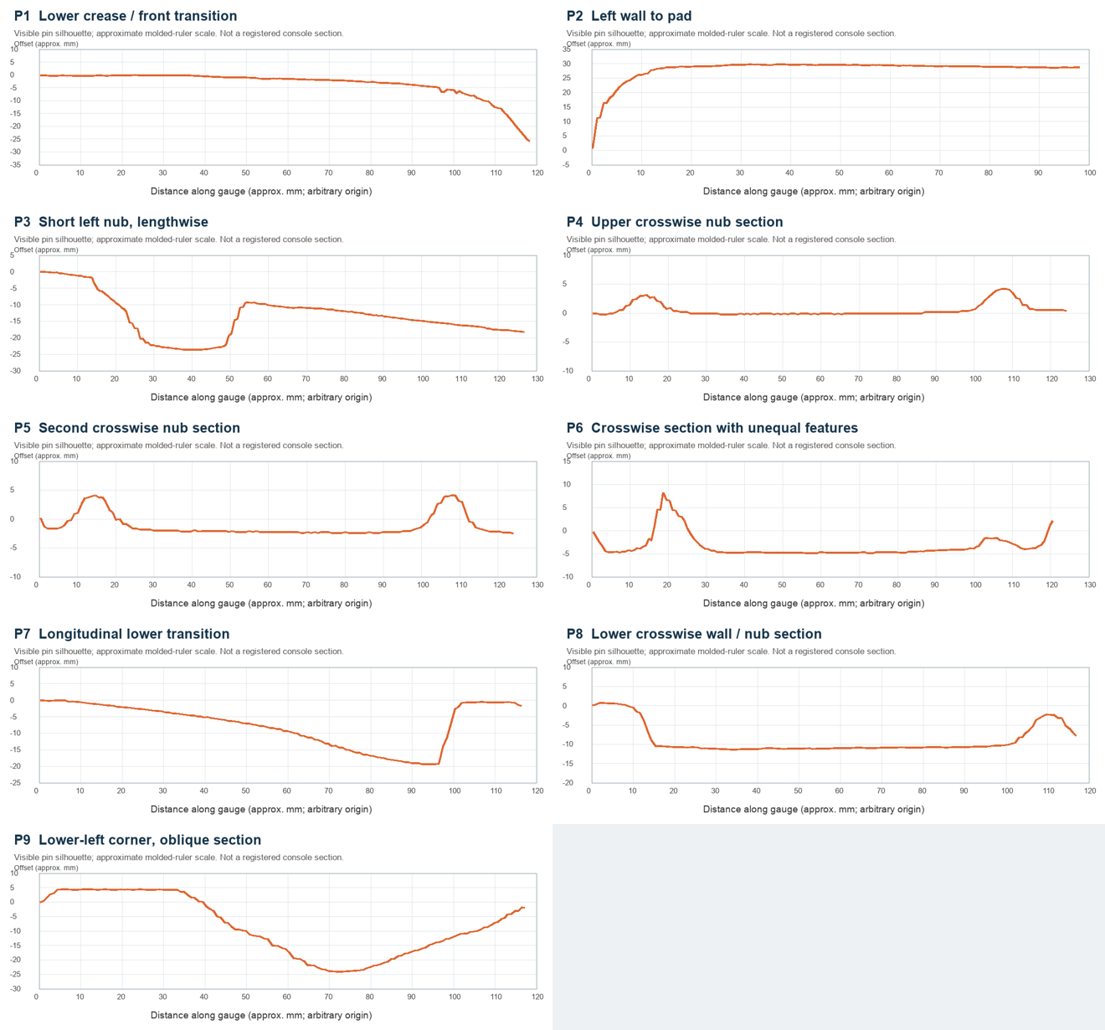
output/curve-review/profile_overview.png
