hbmartin/tesla-iphone-holder/output/new-curve-review/N1_profile.png

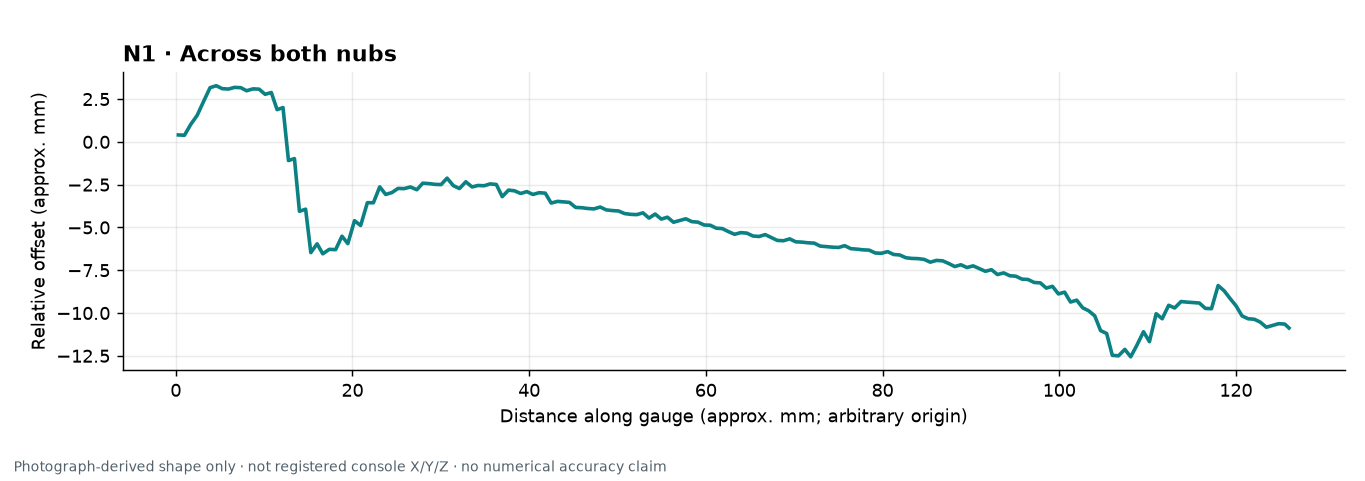
output/new-curve-review/N1_profile.png
