hbmartin/tesla-iphone-holder/output/new-curve-review/N2_profile.png

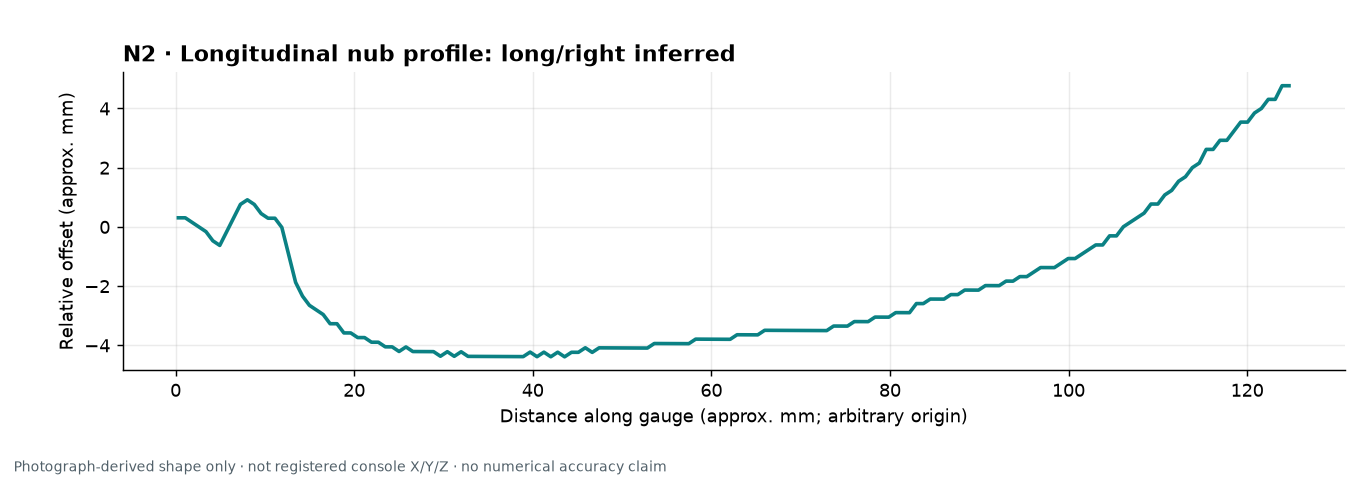
output/new-curve-review/N2_profile.png
