hbmartin/tesla-iphone-holder/output/new-curve-review/N3_profile.png

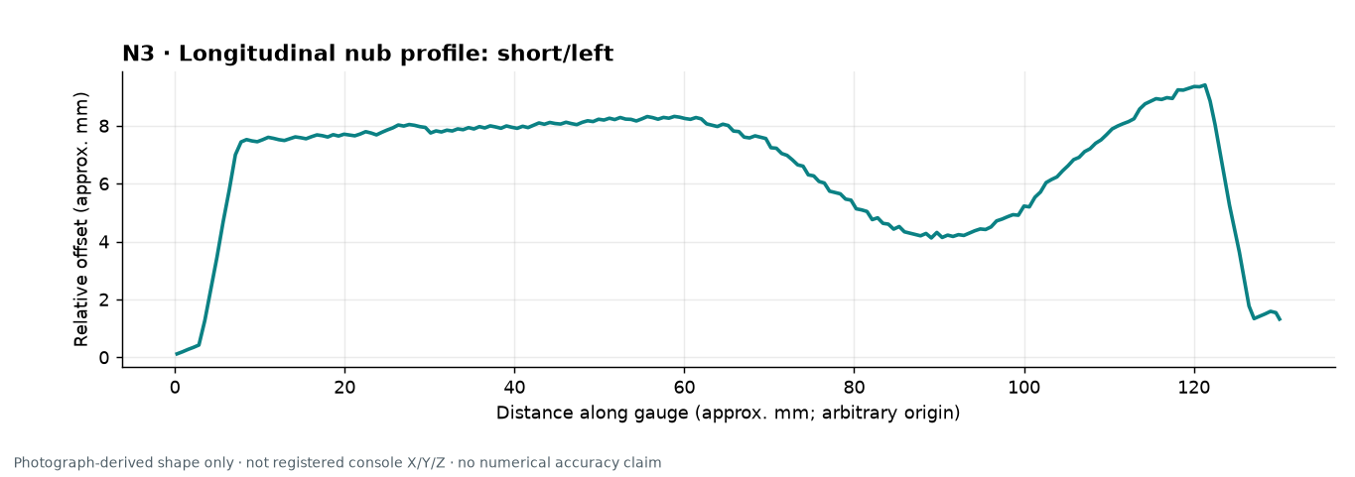
output/new-curve-review/N3_profile.png
