hbmartin/tesla-iphone-holder/output/new-curve-review/N4_profile.png

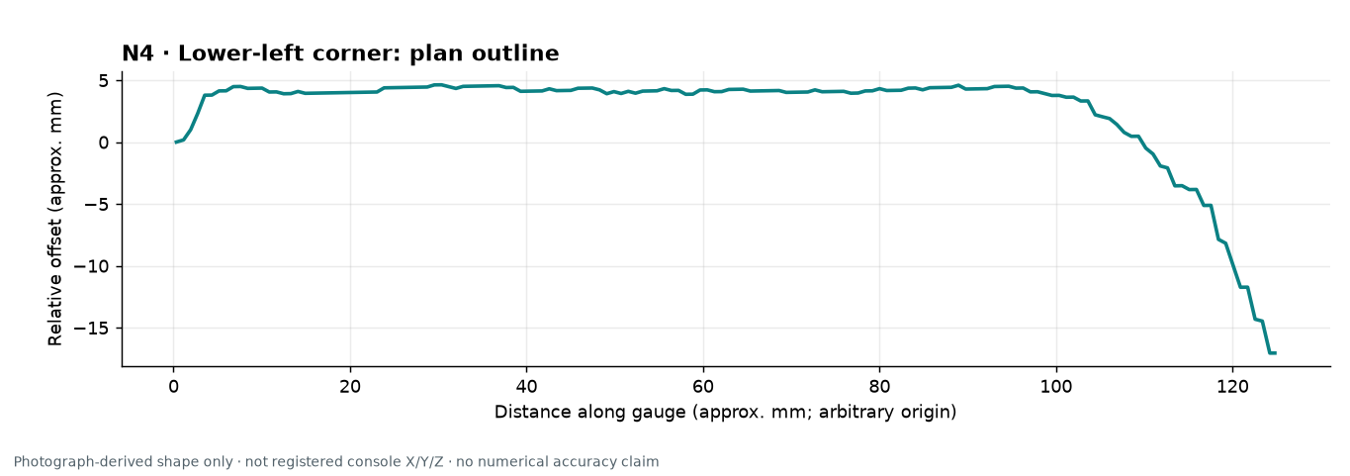
output/new-curve-review/N4_profile.png
