hbmartin/tesla-iphone-holder/output/new-curve-review/N5_profile.png

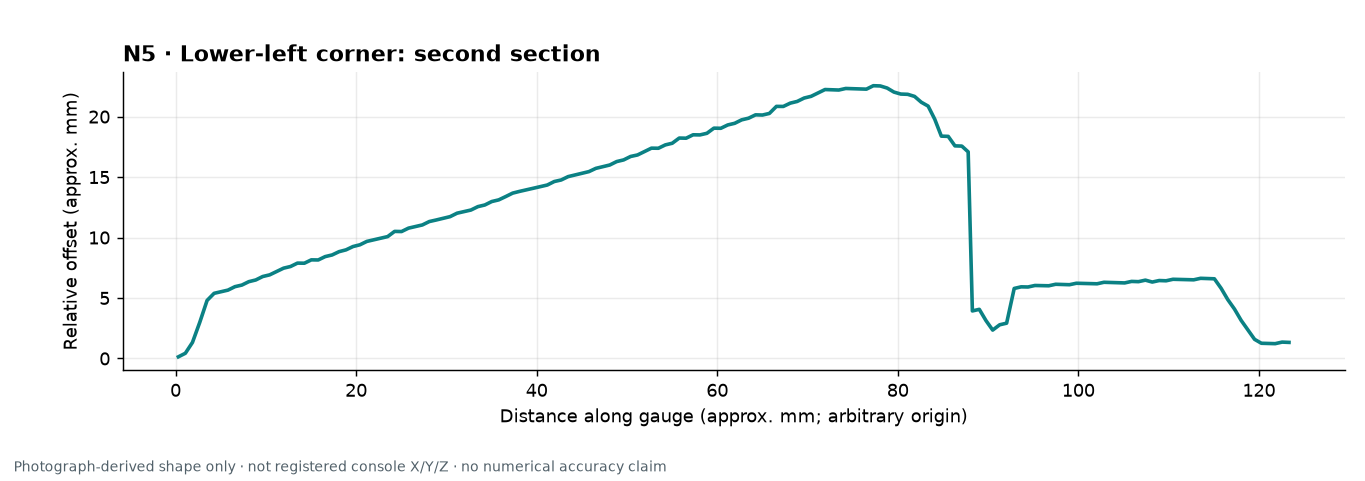
output/new-curve-review/N5_profile.png
