hbmartin/tesla-iphone-holder/output/new-curve-review/N6_profile.png

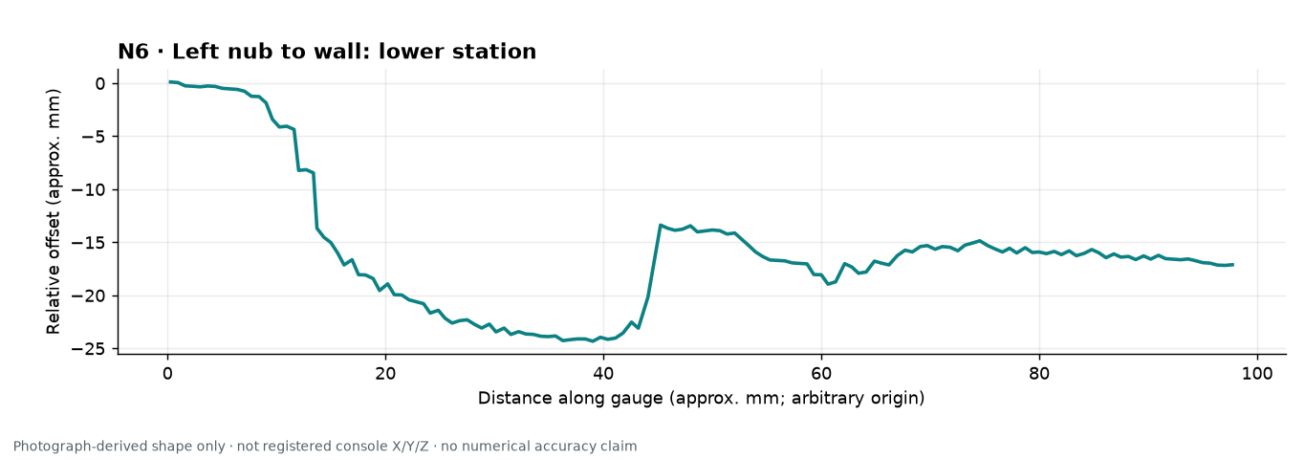
output/new-curve-review/N6_profile.png
