hbmartin/tesla-iphone-holder/output/new-curve-review/N7_profile.png

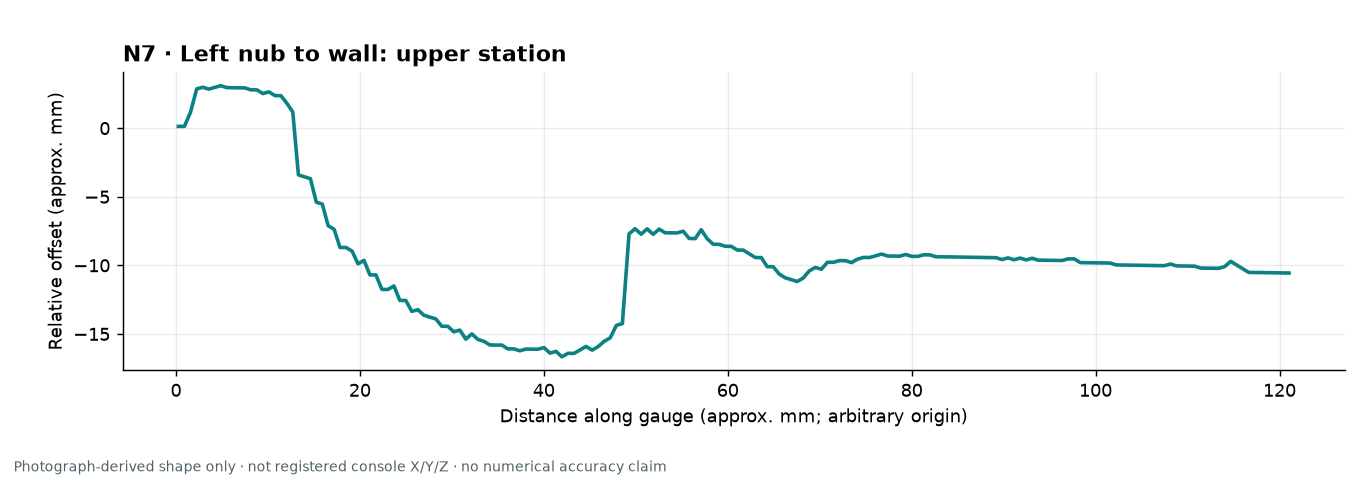
output/new-curve-review/N7_profile.png
