hbmartin/tesla-iphone-holder/output/new-curve-review/width_comparison.png

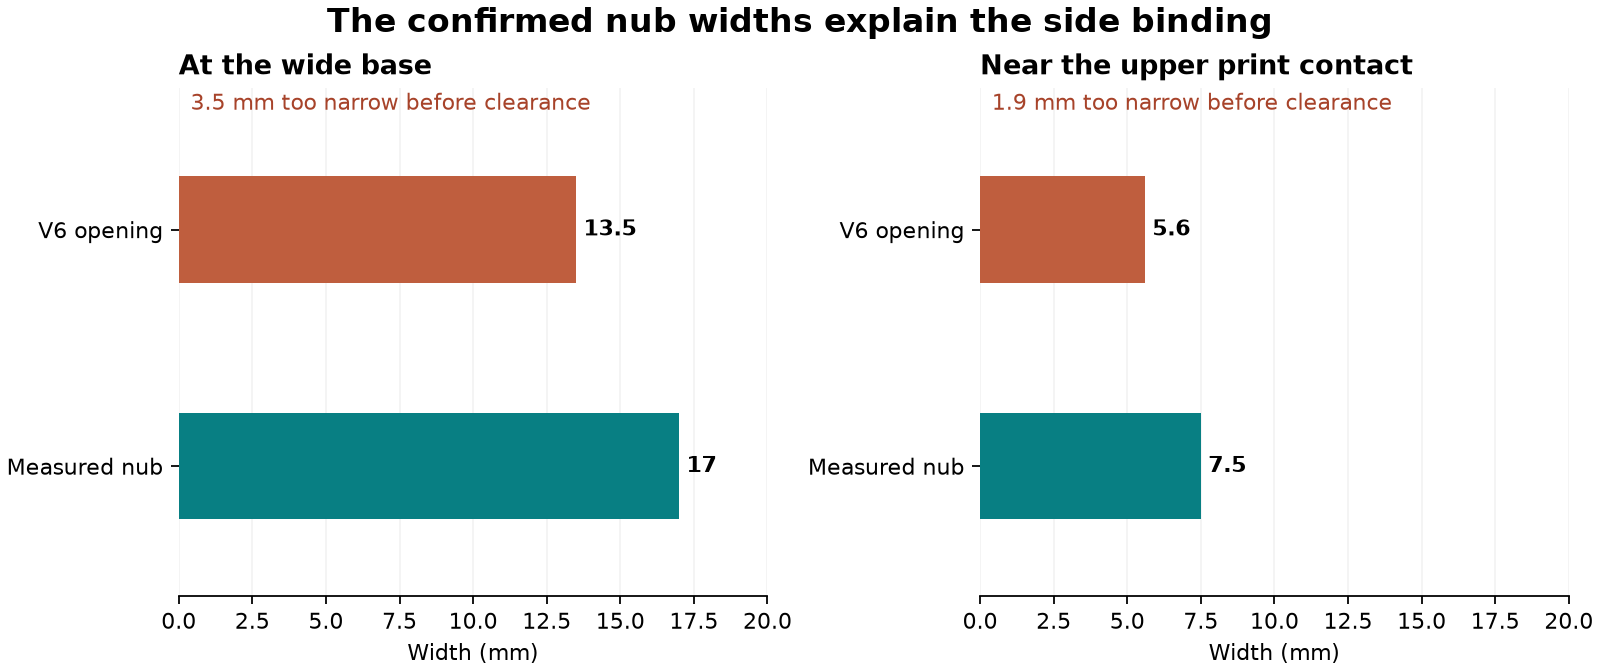
output/new-curve-review/width_comparison.png
