hbmartin/tesla-iphone-holder/output/previews/fit_gauges.png

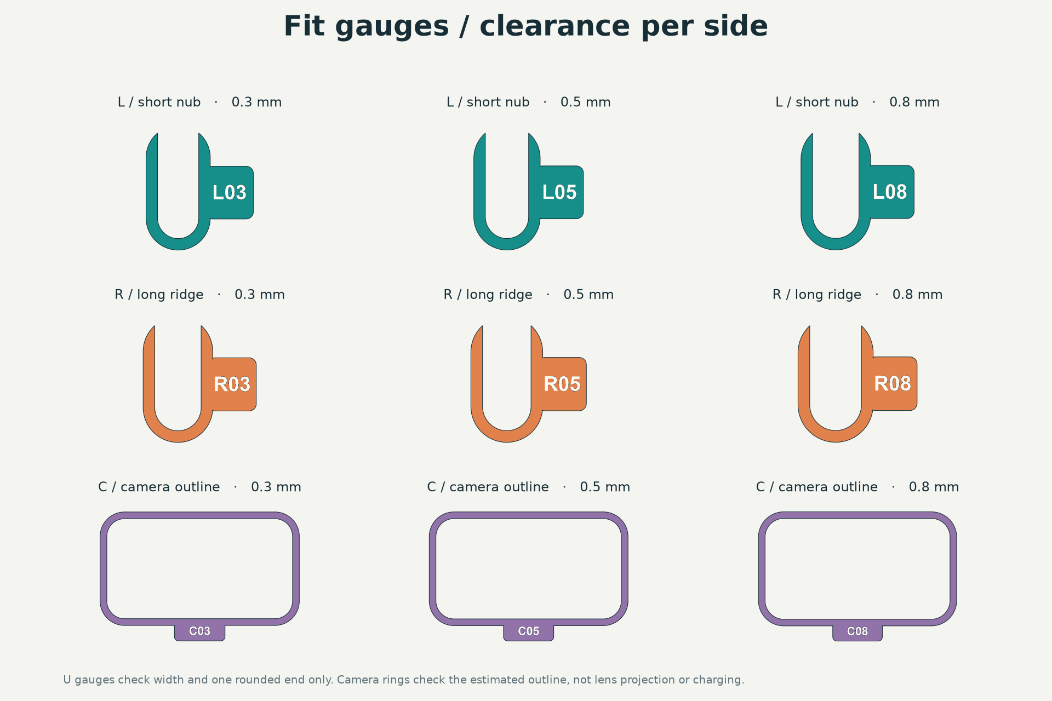
output/previews/fit_gauges.png
