hbmartin/tesla-iphone-holder/output/v7-fit-review/fit_diagnosis.png

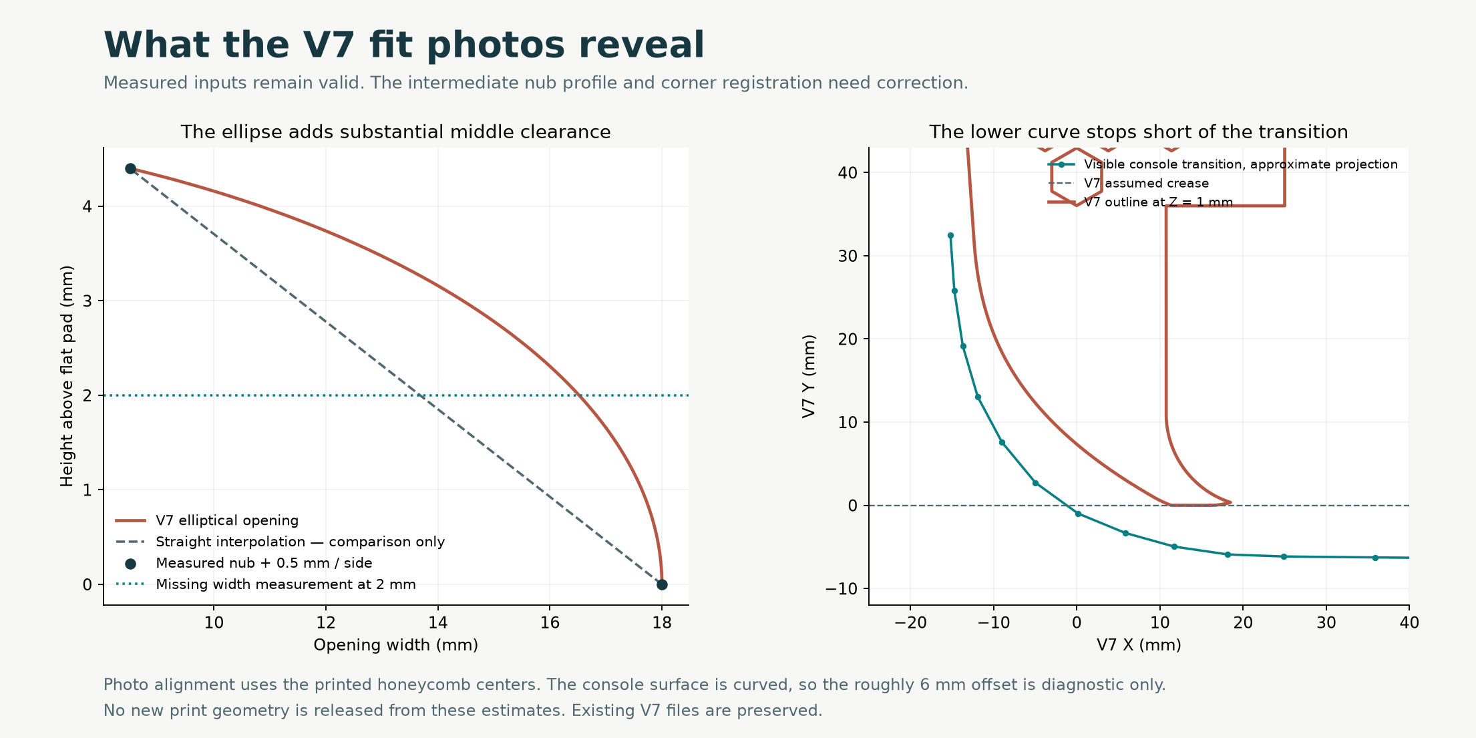
output/v7-fit-review/fit_diagnosis.png
