hbmartin/tesla-iphone-holder/output/v10/previews/bridge_and_left_shift.png

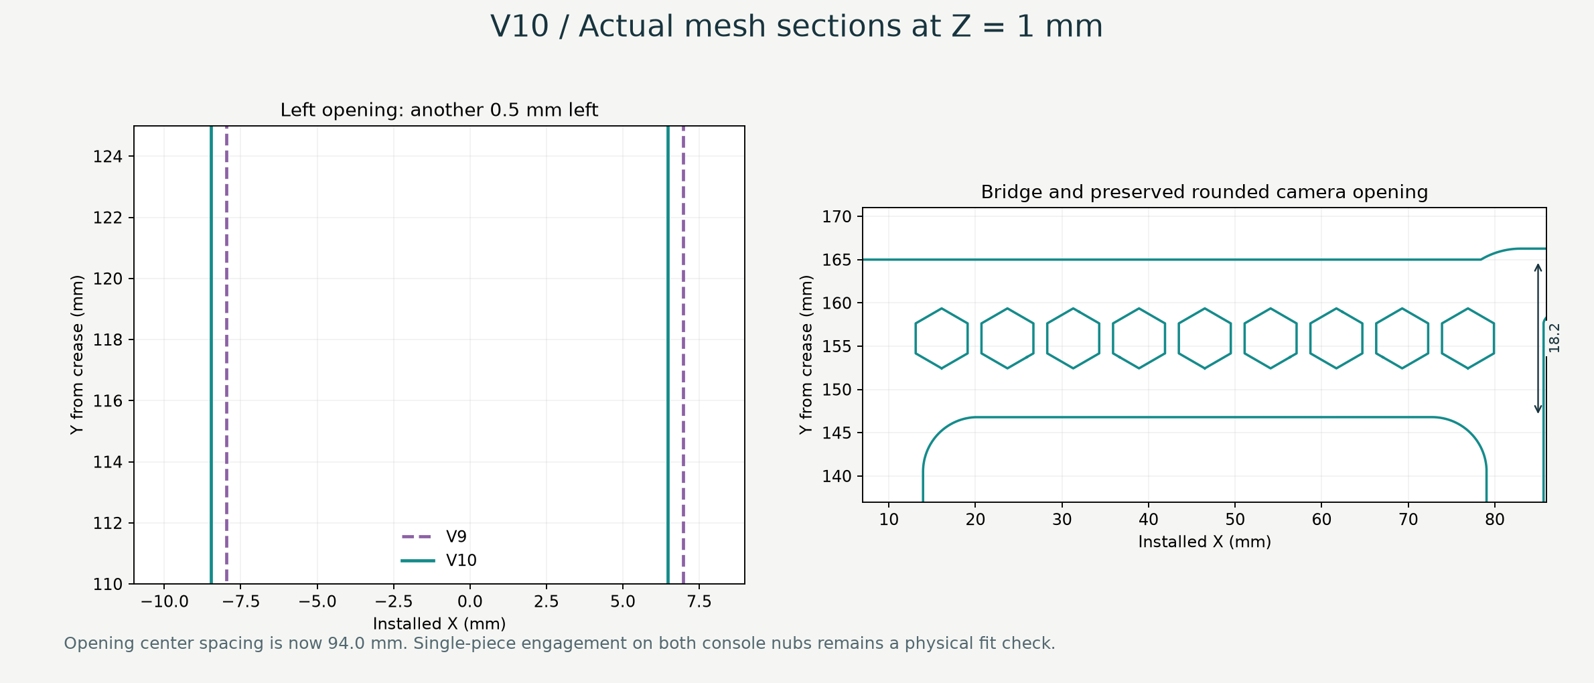
output/v10/previews/bridge_and_left_shift.png
