hbmartin/tesla-iphone-holder/output/v10/previews/ready_full_plate.png

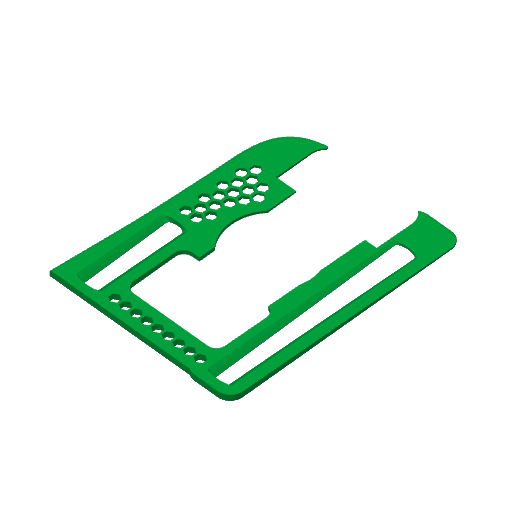
output/v10/previews/ready_full_plate.png
