hbmartin/tesla-iphone-holder/PLAN.jpg

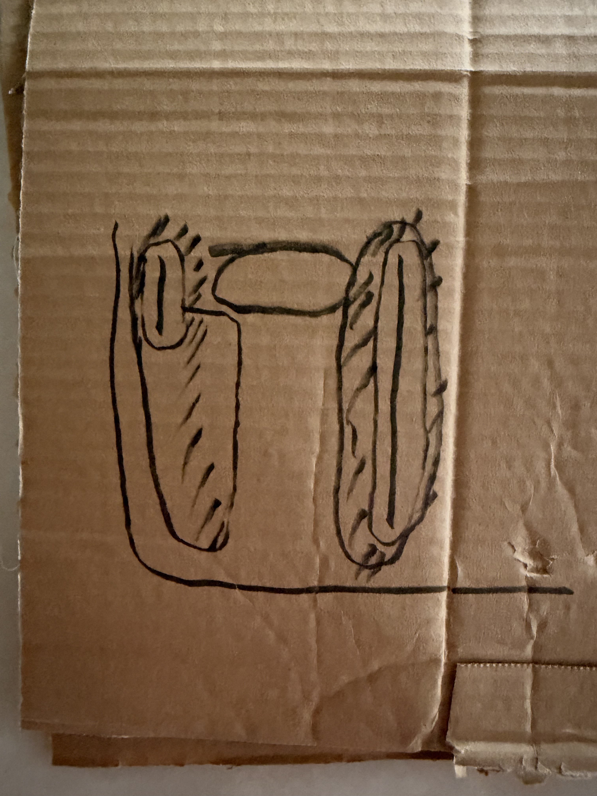
PLAN.jpg
