hbmartin/tesla-iphone-holder/output/v10/previews/sliced_full_parts.png

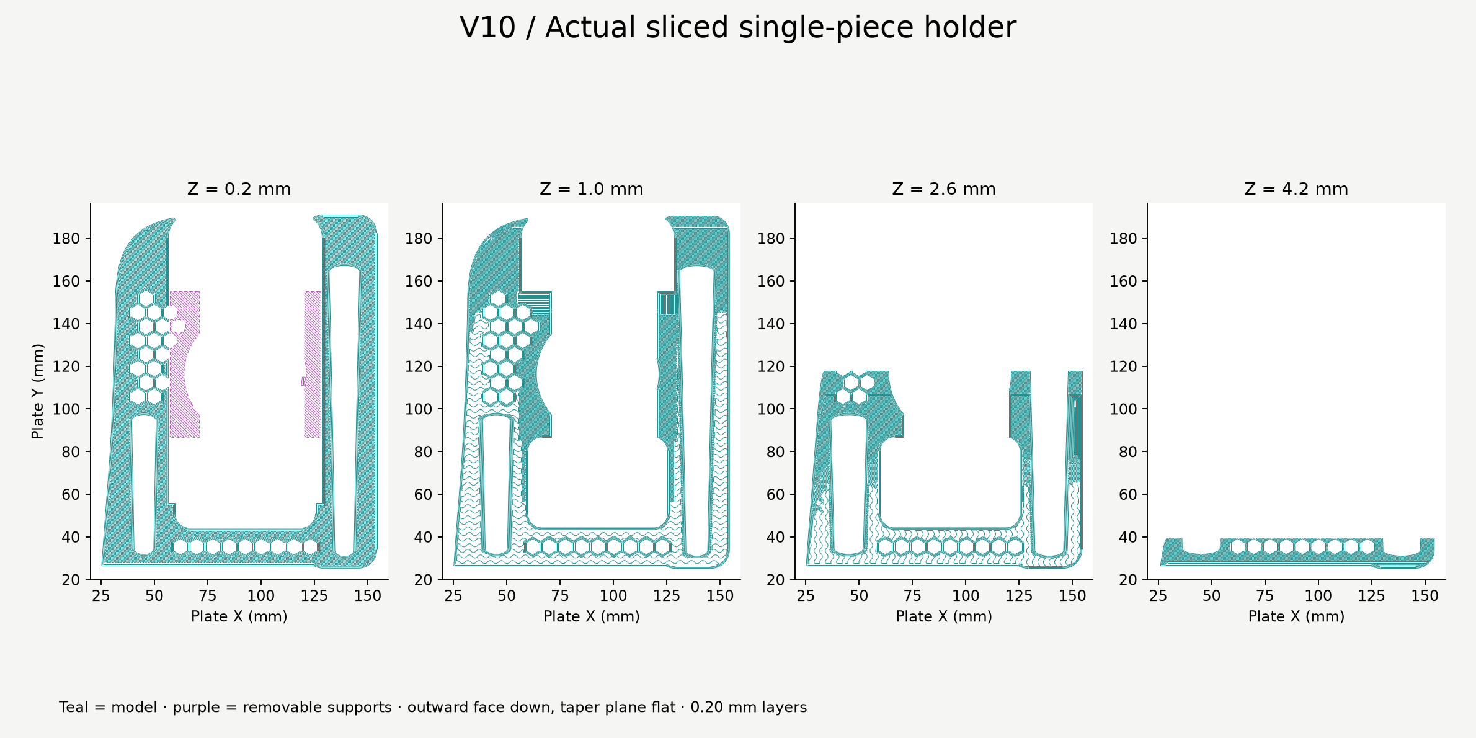
output/v10/previews/sliced_full_parts.png
