hbmartin/tesla-iphone-holder/iPhone+18+Pro+i2.5+back+glass.STL

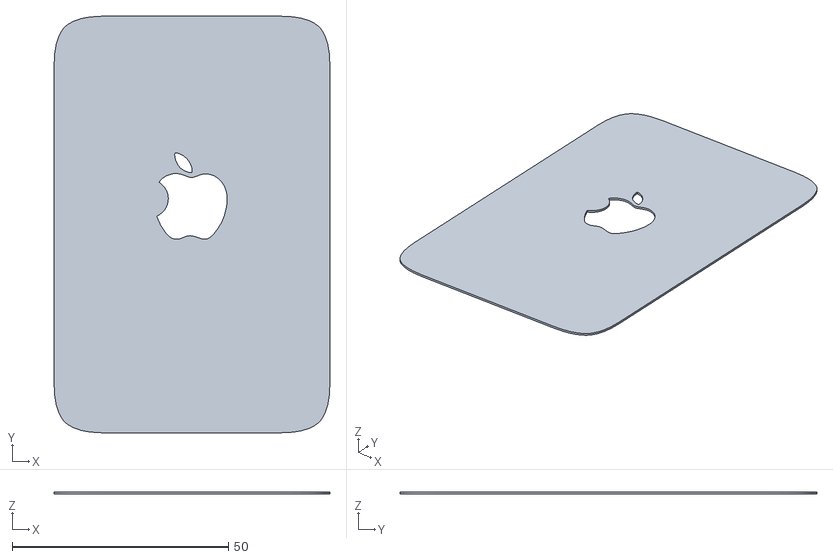
[picture p69: CAD file, 2026-11-08]
iPhone+18+Pro+i2.5+back+glass.STL
63.9 x 96.4 x 0.5
