hbmartin/tesla-iphone-holder/output/fit_tests/right_nub_U_gauge_05.stl

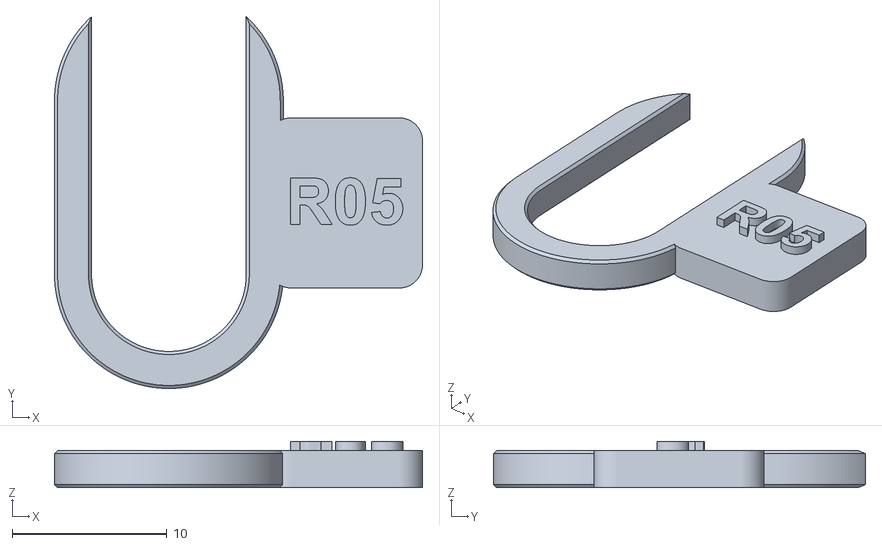
[picture p70: CAD file, 2026-10-20]
output/fit_tests/right_nub_U_gauge_05.stl
23.8 x 24.1 x 3.00
