hbmartin/tesla-iphone-holder/output/slicer/Fit_tests_A1_PLA_layout.3mf

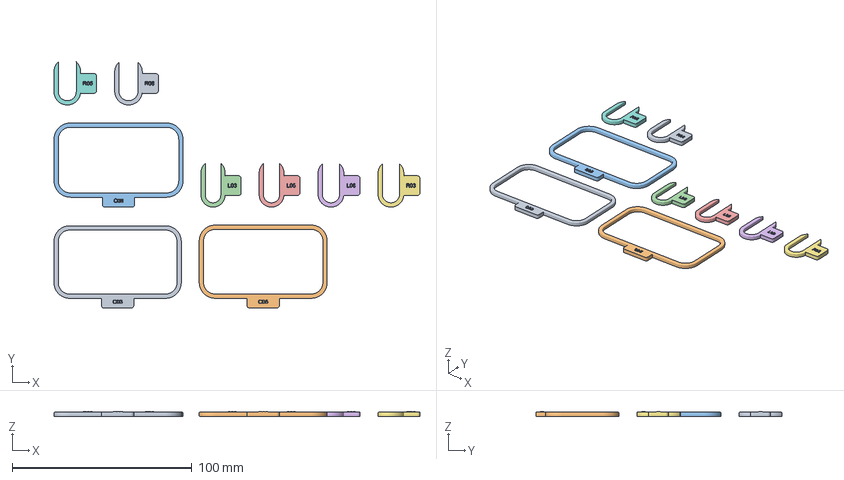
[picture p71: CAD file, 2026-10-20]
output/slicer/Fit_tests_A1_PLA_layout.3mf
203.9 x 137.3 x 2.80 mm
camera_ring_gauge_03
camera_ring_gauge_05
camera_ring_gauge_08
left_nub_U_gauge_03
left_nub_U_gauge_05
left_nub_U_gauge_08
right_nub_U_gauge_03
right_nub_U_gauge_05
right_nub_U_gauge_08
