hbmartin/tesla-iphone-holder/output/v10/validation/bridge_region.step

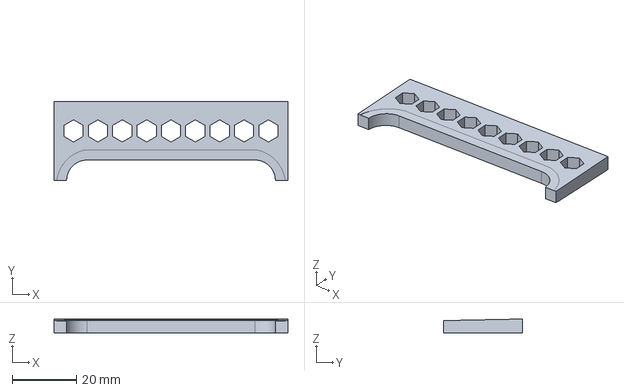
[picture p72: CAD file, 2026-11-08]
output/v10/validation/bridge_region.step
73.0 x 24.5 x 4.37 mm
