hbmartin/tesla-iphone-holder/revisions/v3-draft/output/fit_tests/right_nub_U_gauge_05.stl

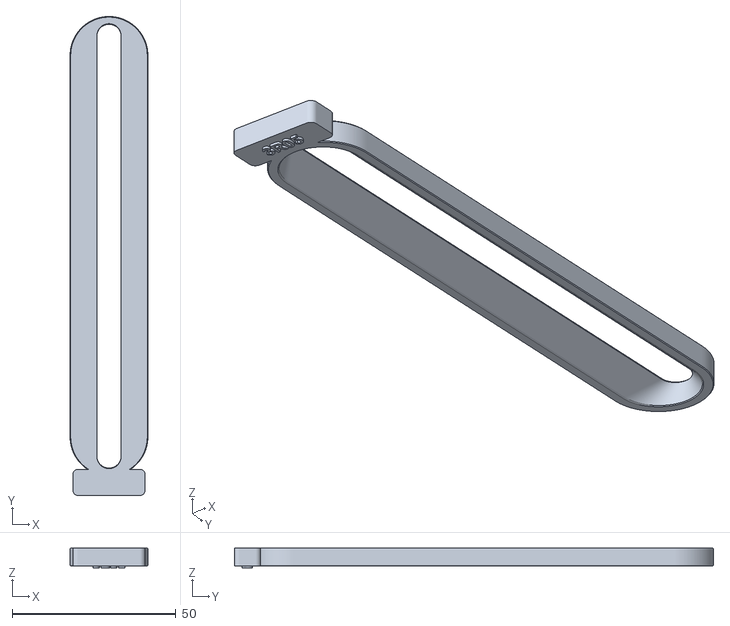
[picture p73: CAD file, 2026-10-20]
revisions/v3-draft/output/fit_tests/right_nub_U_gauge_05.stl
23.8 x 146.4 x 6.00
