hbmartin/tesla-iphone-holder/output/fit_tests/left_nub_U_gauge_03.stl

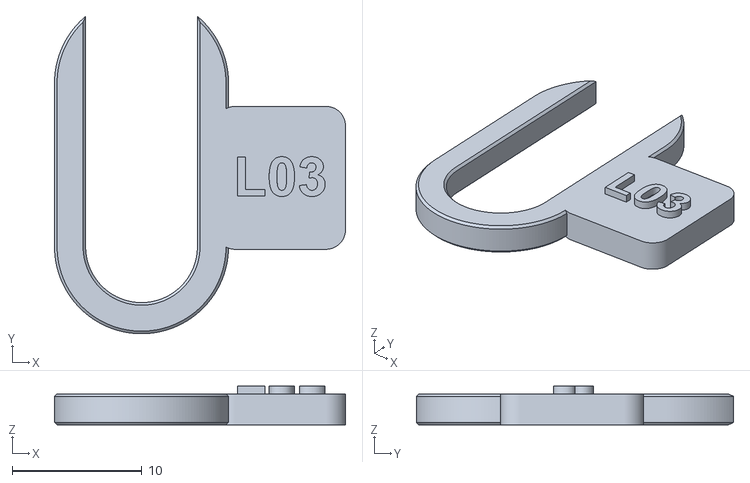
[picture p74: CAD file, 2026-10-20]
output/fit_tests/left_nub_U_gauge_03.stl
22.4 x 24.4 x 3.00
