hbmartin/tesla-iphone-holder/output/slicer/Holder_A1_PLA_PROTOTYPE_layout.3mf

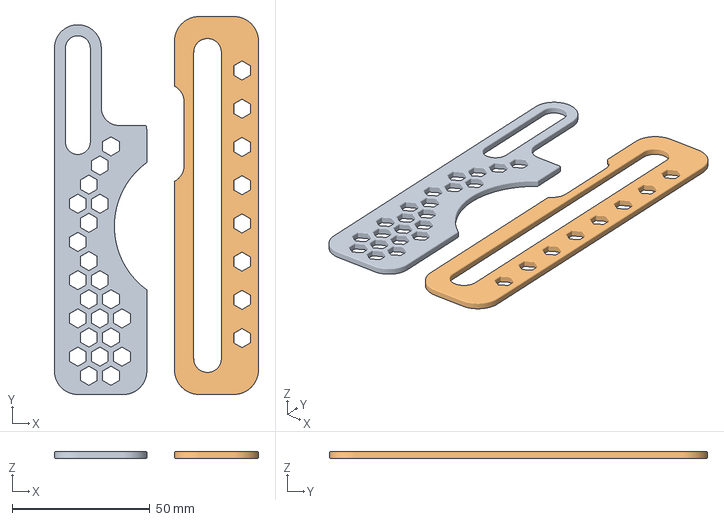
[picture p76: CAD file, 2026-10-20]
output/slicer/Holder_A1_PLA_PROTOTYPE_layout.3mf
74.0 x 137.0 x 2.40 mm
left_insert_PROTOTYPE
right_insert_PROTOTYPE
