hbmartin/tesla-iphone-holder/output/v10/holder_single_geometry.3mf

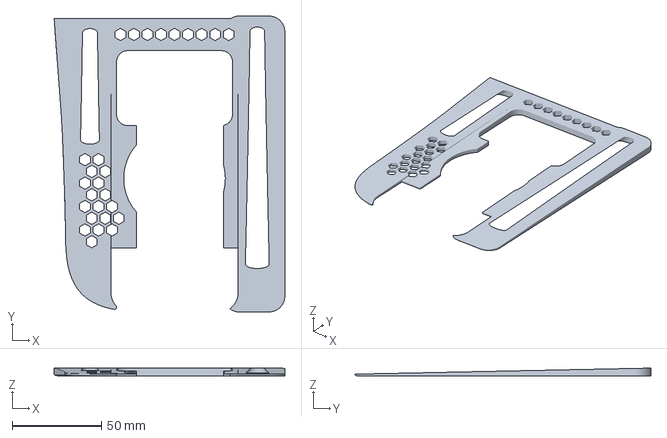
[picture p77: CAD file, 2026-11-08]
output/v10/holder_single_geometry.3mf
129.7 x 166.3 x 4.40 mm
