hbmartin/tesla-iphone-holder/output/fit_tests/left_nub_U_gauge_08.stl

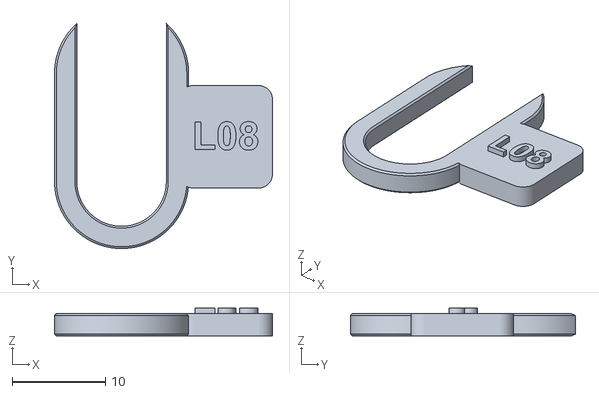
[picture p79: CAD file, 2026-10-20]
output/fit_tests/left_nub_U_gauge_08.stl
23.4 x 24.2 x 3.00
