hbmartin/tesla-iphone-holder/revisions/v3-draft/output/fit_tests/left_nub_U_gauge_08.stl

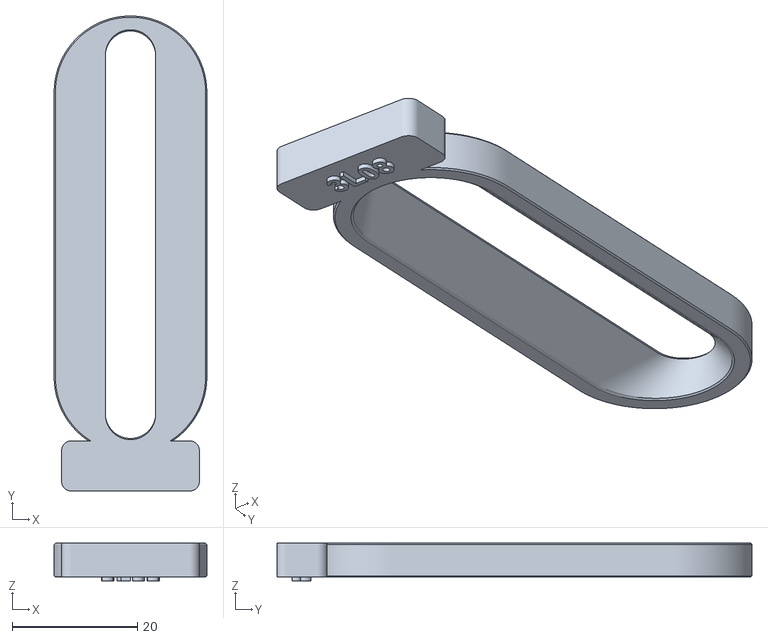
[picture p80: CAD file, 2026-10-20]
revisions/v3-draft/output/fit_tests/left_nub_U_gauge_08.stl
24.4 x 75.9 x 6.00
