hbmartin/tesla-iphone-holder/revisions/v3-draft/output/Fit_tests_V3_A1_PLA.3mf

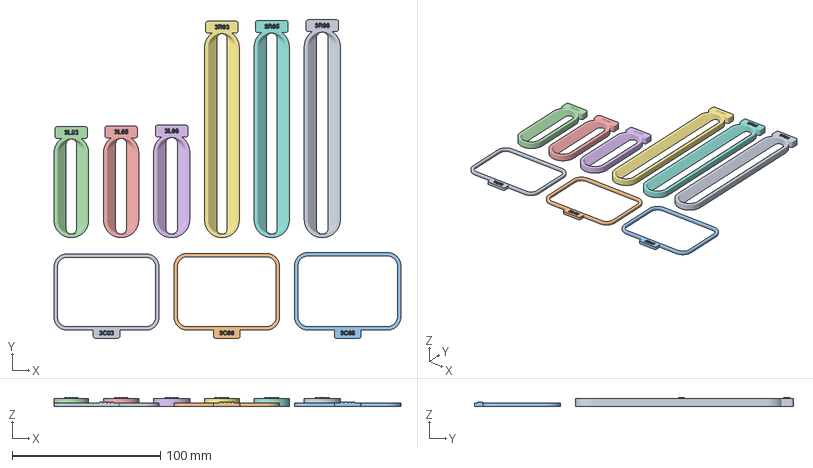
[picture p81: CAD file, 2026-10-20]
revisions/v3-draft/output/Fit_tests_V3_A1_PLA.3mf
234.1 x 214.9 x 6.00 mm
camera_ring_gauge_03
camera_ring_gauge_05
camera_ring_gauge_08
left_nub_U_gauge_03
left_nub_U_gauge_05
left_nub_U_gauge_08
right_nub_U_gauge_03
right_nub_U_gauge_05
right_nub_U_gauge_08
