hbmartin/tesla-iphone-holder/output/fit_tests/camera_ring_gauge_05.stl

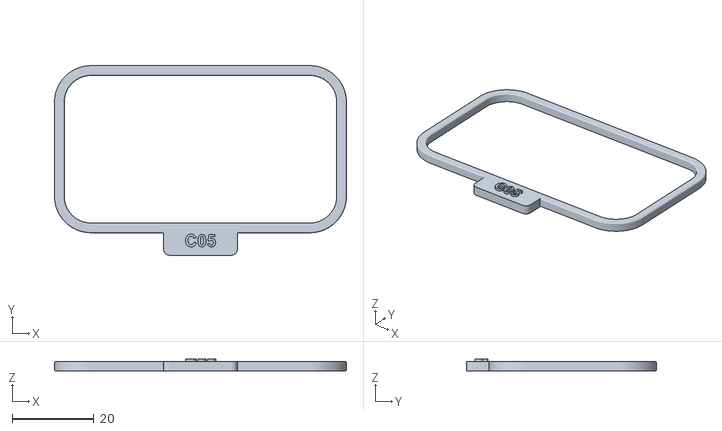
[picture p82: CAD file, 2026-10-20]
output/fit_tests/camera_ring_gauge_05.stl
71.3 x 46.3 x 3.00
