hbmartin/tesla-iphone-holder/revisions/v3-draft/output/fit_tests/camera_ring_gauge_05.stl

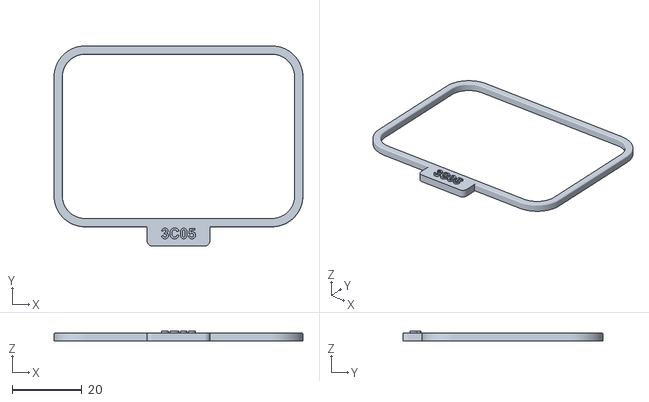
[picture p83: CAD file, 2026-10-20]
revisions/v3-draft/output/fit_tests/camera_ring_gauge_05.stl
71.3 x 57.3 x 3.00
