hbmartin/tesla-iphone-holder/revisions/v3-draft/output/fit_tests/right_nub_U_gauge_03.stl

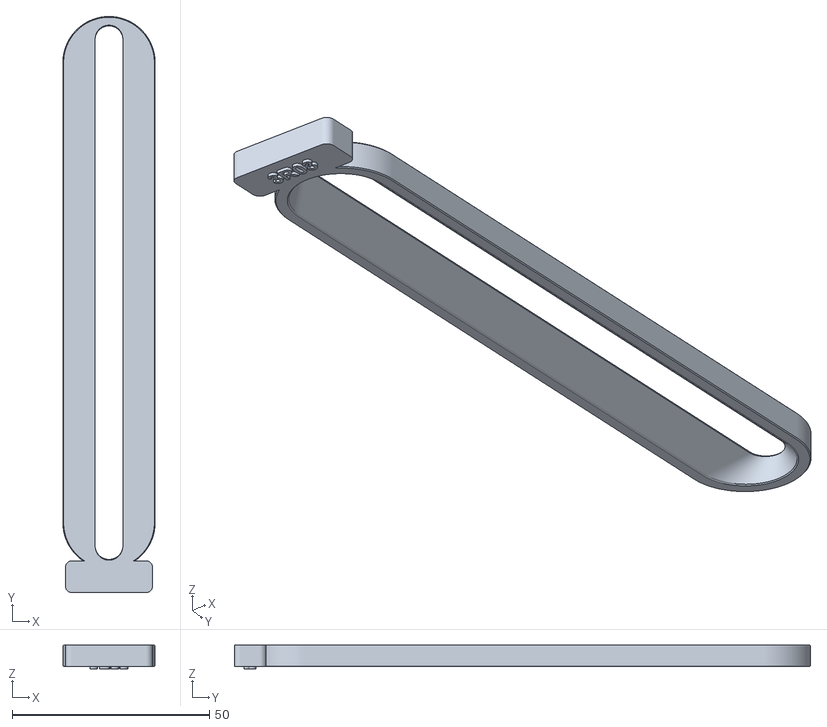
[picture p84: CAD file, 2026-10-20]
revisions/v3-draft/output/fit_tests/right_nub_U_gauge_03.stl
23.4 x 146.0 x 6.00
