hbmartin/tesla-iphone-holder/revisions/v3-draft/output/Holder_V3_DRAFT_A1_PLA.3mf

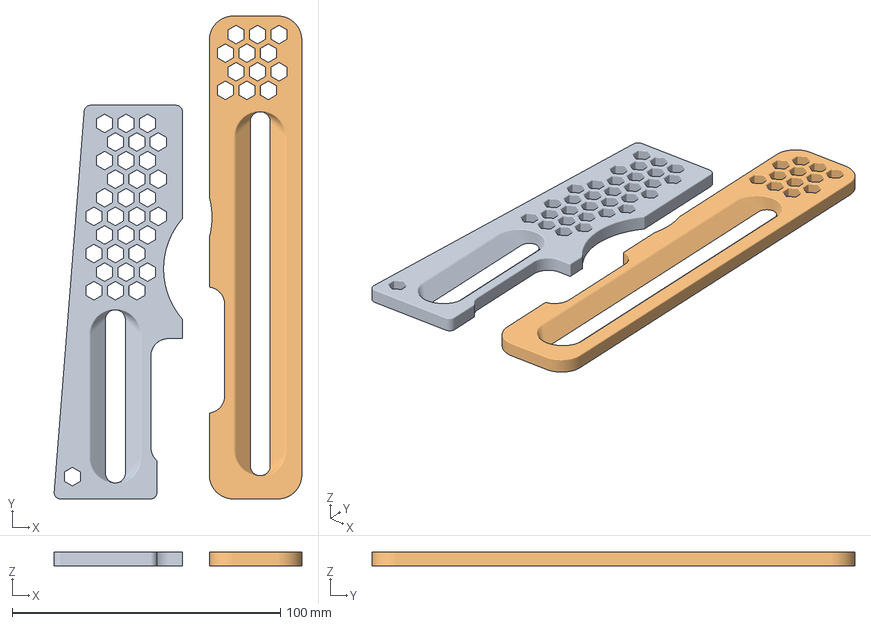
[picture p85: CAD file, 2026-10-20]
revisions/v3-draft/output/Holder_V3_DRAFT_A1_PLA.3mf
92.3 x 180.0 x 5.40 mm
left_insert_PROTOTYPE
right_insert_PROTOTYPE
