hbmartin/tesla-iphone-holder/revisions/v3-draft/output/fit_tests/left_nub_U_gauge_03.stl

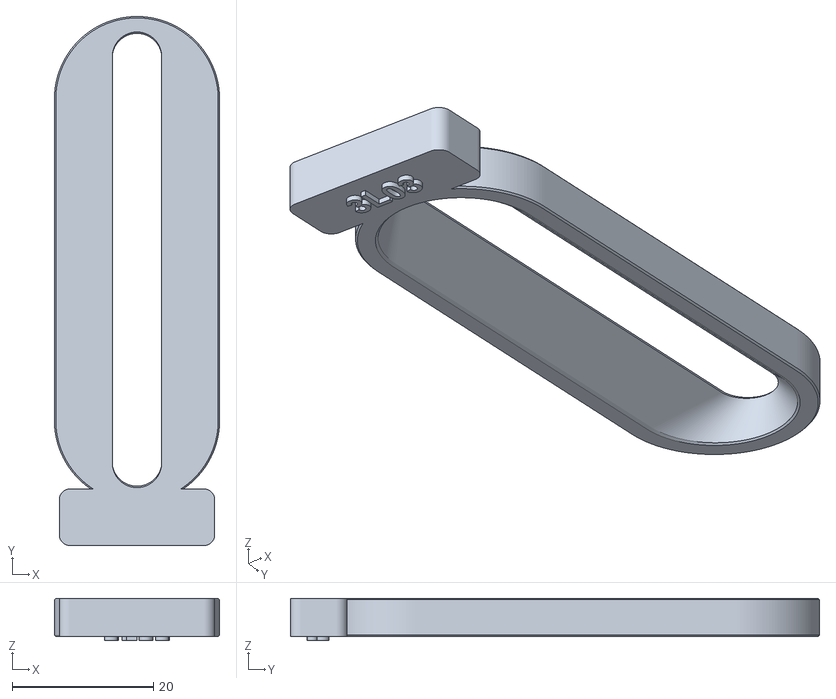
[picture p86: CAD file, 2026-10-20]
revisions/v3-draft/output/fit_tests/left_nub_U_gauge_03.stl
23.4 x 74.9 x 6.00
