hbmartin/tesla-iphone-holder/revisions/v3-draft/output/fit_tests/right_nub_U_gauge_08.stl

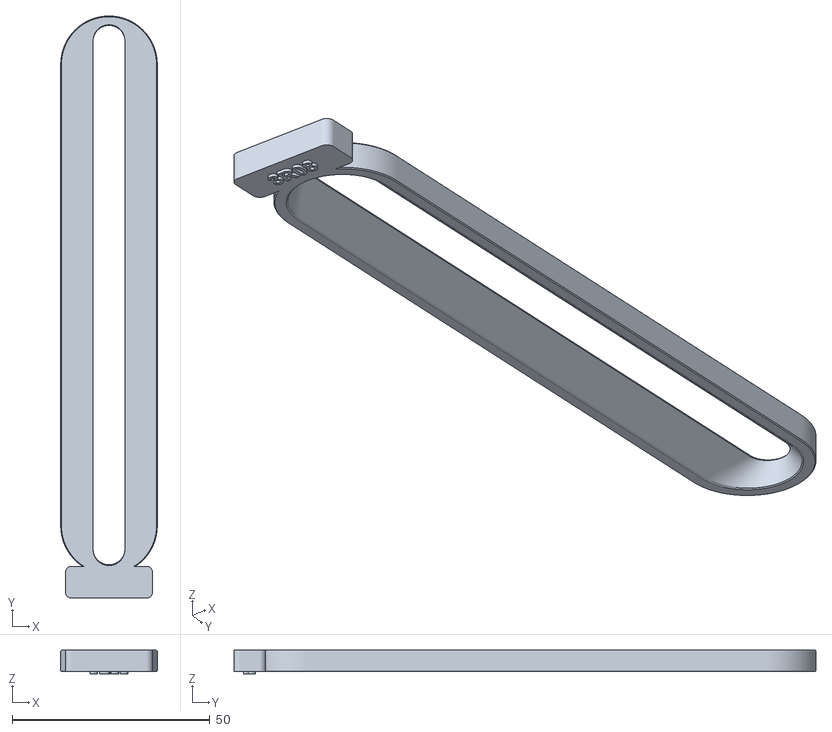
[picture p87: CAD file, 2026-10-20]
revisions/v3-draft/output/fit_tests/right_nub_U_gauge_08.stl
24.4 x 147.0 x 6.00
