hbmartin/tesla-iphone-holder/output/fit_tests/camera_ring_gauge_08.stl

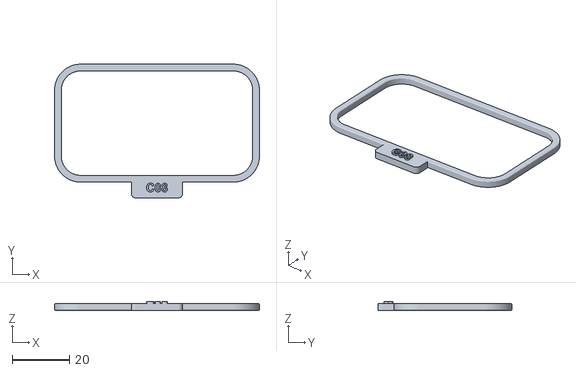
[picture p88: CAD file, 2026-10-20]
output/fit_tests/camera_ring_gauge_08.stl
71.9 x 46.9 x 3.00
