hbmartin/tesla-iphone-holder/revisions/v3-draft/output/fit_tests/camera_ring_gauge_08.stl

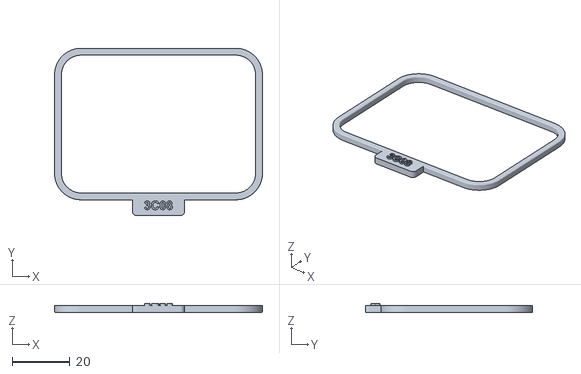
[picture p89: CAD file, 2026-10-20]
revisions/v3-draft/output/fit_tests/camera_ring_gauge_08.stl
71.9 x 57.9 x 3.00
