hbmartin/tesla-iphone-holder/(list of files, cad)

Other CAD files:
output/v10/Holder_V10_A1_PLA_OUTWARD_FACE_DOWN.gcode.3mf
output/v10/Holder_V10_A1_PLA_OUTWARD_FACE_DOWN.3mf
output/v10/Holder_V10_A1_PLA_OUTWARD_FACE_DOWN_SLICED.3mf
output/fit_tests/right_nub_U_gauge_08.stl
output/v10/holder_single_PROTOTYPE.step
output/fit_tests/camera_ring_gauge_03.stl
output/Holder_A1_PLA_PROTOTYPE.3mf
output/fit_tests/left_nub_U_gauge_05.stl
revisions/v3-draft/output/fit_tests/camera_ring_gauge_03.stl
output/fit_tests/right_nub_U_gauge_03.stl
output/holder_assembled_PROTOTYPE.step
output/holder_assembled_geometry.3mf
output/left_insert_PROTOTYPE.step
output/left_insert_PROTOTYPE.stl
output/right_insert_PROTOTYPE.step
output/right_insert_PROTOTYPE.stl
output/v10/holder_single_PROTOTYPE.stl
output/v10/print/holder_single_PROTOTYPE.stl
output/v2/Fit_tests_V2_A1_PLA.3mf
output/v2/Holder_V2_A1_PLA_PROTOTYPE.3mf
output/v2/fit_tests/camera_ring_gauge_03.stl
output/v2/fit_tests/camera_ring_gauge_05.stl
output/v2/fit_tests/camera_ring_gauge_08.stl
output/v2/fit_tests/left_nub_U_gauge_03.stl
output/v2/fit_tests/left_nub_U_gauge_05.stl
output/v2/fit_tests/left_nub_U_gauge_08.stl
output/v2/fit_tests/right_nub_U_gauge_03.stl
output/v2/fit_tests/right_nub_U_gauge_05.stl
output/v2/fit_tests/right_nub_U_gauge_08.stl
output/v2/holder_assembled_PROTOTYPE.step
output/v2/holder_assembled_geometry.3mf
output/v2/left_insert_PROTOTYPE.step
output/v2/left_insert_PROTOTYPE.stl
output/v2/right_insert_PROTOTYPE.step
output/v2/right_insert_PROTOTYPE.stl
output/v3/Fit_tests_V3_A1_PLA.3mf
output/v3/Holder_V3_A1_PLA_PROTOTYPE.3mf
output/v3/fit_tests/camera_ring_gauge_03.stl
output/v3/holder_assembled_PROTOTYPE.step
output/v3/holder_assembled_geometry.3mf
output/v3/left_insert_PROTOTYPE.step
output/v3/left_insert_PROTOTYPE.stl
output/v3/right_insert_PROTOTYPE.step
output/v3/right_insert_PROTOTYPE.stl
output/v4/Holder_V4_A1_PLA_PROTOTYPE.3mf
output/v4/Holder_V4_A1_PLA_PROTOTYPE.gcode.3mf
output/v4/Holder_V4_A1_PLA_PROTOTYPE_SLICED.3mf
output/v4/holder_assembled_PROTOTYPE.step
output/v4/holder_assembled_geometry.3mf
output/v4/left_insert_PROTOTYPE.step
output/v4/left_insert_PROTOTYPE.stl
output/v4/right_insert_PROTOTYPE.step
output/v4/right_insert_PROTOTYPE.stl
output/v5/Holder_V5_A1_PLA_PROTOTYPE.3mf
output/v5/Holder_V5_A1_PLA_PROTOTYPE.gcode.3mf
output/v5/Holder_V5_A1_PLA_PROTOTYPE_SLICED.3mf
output/v5/holder_assembled_PROTOTYPE.step
output/v5/holder_assembled_geometry.3mf
output/v5/left_insert_PROTOTYPE.step
output/v5/left_insert_PROTOTYPE.stl
output/v5/right_insert_PROTOTYPE.step
output/v5/right_insert_PROTOTYPE.stl
output/v6/Holder_V6_A1_PLA_PROTOTYPE.3mf
output/v6/Holder_V6_A1_PLA_PROTOTYPE.gcode.3mf
output/v6/Holder_V6_A1_PLA_PROTOTYPE_SLICED.3mf
output/v6/holder_assembled_PROTOTYPE.step
output/v6/holder_assembled_geometry.3mf
output/v6/left_insert_PROTOTYPE.step
output/v6/left_insert_PROTOTYPE.stl
output/v6/right_insert_PROTOTYPE.step
output/v6/right_insert_PROTOTYPE.stl
output/v7/Fit_tests_V7_A1_PLA.3mf
output/v7/Fit_tests_V7_A1_PLA.gcode.3mf
output/v7/Fit_tests_V7_A1_PLA_SLICED.3mf
output/v7/Holder_V7_A1_PLA_PROTOTYPE.3mf
output/v7/Holder_V7_A1_PLA_PROTOTYPE.gcode.3mf
output/v7/Holder_V7_A1_PLA_PROTOTYPE_SLICED.3mf
output/v7/fit_tests/left_nub_clearance_03.step
output/v7/fit_tests/left_nub_clearance_03.stl
output/v7/fit_tests/left_nub_clearance_05.step
output/v7/fit_tests/left_nub_clearance_05.stl
output/v7/fit_tests/left_nub_clearance_07.step
output/v7/fit_tests/left_nub_clearance_07.stl
output/v7/fit_tests/lower_left_corner_C7.step
output/v7/fit_tests/lower_left_corner_C7.stl
output/v7/fit_tests/right_nub_clearance_03.step
output/v7/fit_tests/right_nub_clearance_03.stl
output/v7/fit_tests/right_nub_clearance_05.step
output/v7/fit_tests/right_nub_clearance_05.stl
output/v7/fit_tests/right_nub_clearance_07.step
output/v7/fit_tests/right_nub_clearance_07.stl
output/v7/holder_assembled_PROTOTYPE.step
output/v7/holder_assembled_geometry.3mf
output/v7/left_insert_PROTOTYPE.step
output/v7/left_insert_PROTOTYPE.stl
output/v7/right_insert_PROTOTYPE.step
output/v7/right_insert_PROTOTYPE.stl
output/v8/Fit_tests_V8_A1_PLA.3mf
output/v8/Fit_tests_V8_A1_PLA.gcode.3mf
output/v8/Fit_tests_V8_A1_PLA_SLICED.3mf
output/v8/Holder_V8_A1_PLA_PROTOTYPE.3mf
output/v8/Holder_V8_A1_PLA_PROTOTYPE.gcode.3mf
output/v8/Holder_V8_A1_PLA_PROTOTYPE_SLICED.3mf
output/v8/fit_tests/left_nub_fit_V8.step
output/v8/fit_tests/left_nub_fit_V8.stl
output/v8/fit_tests/lower_left_corner_C8.step
output/v8/fit_tests/lower_left_corner_C8.stl
output/v8/fit_tests/right_nub_fit_V8.step
output/v8/fit_tests/right_nub_fit_V8.stl
output/v8/holder_assembled_PROTOTYPE.step
output/v8/holder_assembled_geometry.3mf
output/v8/left_insert_PROTOTYPE.step
output/v8/left_insert_PROTOTYPE.stl
output/v8/right_insert_PROTOTYPE.step
output/v8/right_insert_PROTOTYPE.stl
output/v9/Holder_V9_A1_PLA_PROTOTYPE.3mf
output/v9/Holder_V9_A1_PLA_PROTOTYPE.gcode.3mf
output/v9/Holder_V9_A1_PLA_PROTOTYPE_SLICED.3mf
output/v9/holder_assembled_PROTOTYPE.step
output/v9/holder_assembled_geometry.3mf
output/v9/left_insert_PROTOTYPE.step
output/v9/left_insert_PROTOTYPE.stl
output/v9/outward_face_down/Holder_V9_A1_PLA_OUTWARD_FACE_DOWN.3mf
output/v9/outward_face_down/Holder_V9_A1_PLA_OUTWARD_FACE_DOWN.gcode.3mf
output/v9/outward_face_down/Holder_V9_A1_PLA_OUTWARD_FACE_DOWN_SLICED.3mf
output/v9/outward_face_down/left_insert_PROTOTYPE.stl
output/v9/outward_face_down/right_insert_PROTOTYPE.stl
output/v9/right_insert_PROTOTYPE.step
output/v9/right_insert_PROTOTYPE.stl
revisions/v3-draft/output/holder_assembled_PROTOTYPE.step
revisions/v3-draft/output/holder_assembled_geometry.3mf
revisions/v3-draft/output/left_insert_PROTOTYPE.step
revisions/v3-draft/output/left_insert_PROTOTYPE.stl
revisions/v3-draft/output/right_insert_PROTOTYPE.step
revisions/v3-draft/output/right_insert_PROTOTYPE.stl
