hbmartin/tesla-iphone-holder/output/pdf/console_contour_measurement_guide.pdf

CONSOLE CONTOUR MEASUREMENTS

# Map the bare console

32 record slots cover the crease, wall, corner and nubs; use accessible profiles or the noted alternatives. The drawing is a placement map, not a measured console contour.

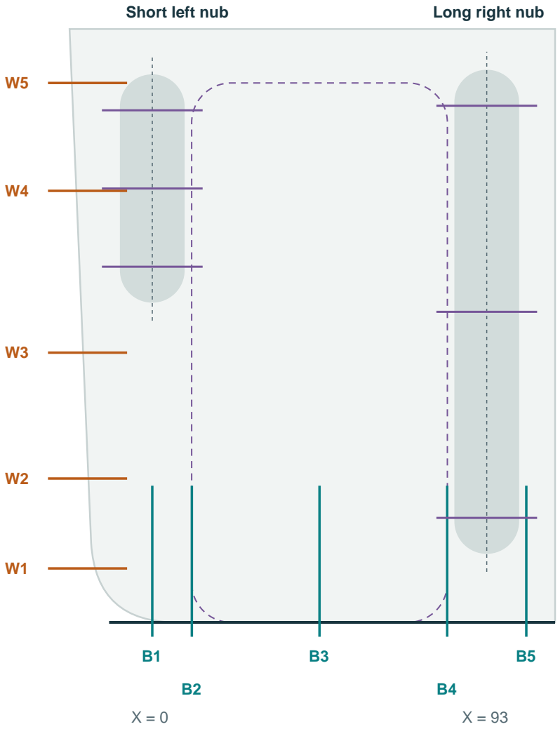
[picture p90: figure]
Short left nub; Long right nub

V5 follow-up | 20 October 2026 | All dimensions in mm | 1 / 8

Factory lower crease: Y = 0

+Y
camera end

B: bottom / crease

5 profiles
Page 3

W: left wall

5 profiles
Page 3

C: lower-left corner

3 sections + 3 outlines
Page 4

N: both nubs

6 cross + 2 length
+ 8 end outlines
Pages 5-6

Set the references first. Remove the phone and both inserts. Work on the bare factory surface. X = 0 follows the short left nub centerline; X increases rightward. Y is measured along the pad from the inside lower crease, not horizontally through the air.

Z is perpendicular to the pad, not vertical to the ground. Use a clear, flat region of the pad as Z = 0. Extend the straight lower crease through the rounded corner as a reference line; record the actual corner separately. New IDs B/W/C/N replace vague A/B/C contour references; they do not change the old measured nub-to-crease gaps.

# How to capture a usable profile

A shape without its location, plane and scale cannot be placed reliably into CAD.

### 1 Keep the gauge in the section plane

Across a nub: X-Z plane
pins

Flat pad baseline: Z = 0

Along a nub: Y-Z plane
pins

Flat pad baseline: Z = 0

Hold the gauge face in a plane perpendicular to the pad for B, W, C-S and N-X/N-L profiles. Keep its long axis along the marked section line. Advance pins toward the surface with only enough pressure for contact; do not squash the fabric. Keep the pin tips in one plane, without twisting.

### 2 Lock, label and preserve the baseline

Capture at least 10 mm of flat pad beside a nub or wall blend where accessible; for the crease include about 30 mm of pad plus the full ledge. Mark the pad baseline and a known station on the gauge or trace. Mark which direction is +X or +Y. Lock the gauge before lifting it; use the same face for every photograph.

### 3 Photograph the shape and its placement

For each ID, take one placement photo showing the gauge on the labeled console station. Then place the locked gauge on paper and photograph square-on to its face, with a millimeter ruler in that same plane. Include a second ruler perpendicular to the first if possible. Keep the whole contact edge, label and scale visible; avoid perspective and mirroring.

### 4 Record repeatability and tool limits

Capture each profile twice; take a third if they differ. Record pin spacing, out-of-plane tip thickness and repeat spread. Aim for agreement within about 0.5 mm if feasible; report worse results. Thick pins sample a band, not a perfect plane. Coarse pins may not resolve an R0.9 edge. Mark blocked or undercut areas as missing; never infer hidden shape.

### What to send for every ID

ID + actual station/height + placement photo + square-on profile photo + baseline + direction + repeat spread. A scan of a paper tracing with a measured 50 mm reference line is also useful. Do not smooth the curve into an assumed circle; the transition may not have a single radius.

# B: lower crease / W: left wall

These are perpendicular sections through the pad. They determine underside relief and where each piece may extend.

B: gauge runs up/down the pad

Y = 0 reference

+Y toward camera

W: gauge runs across the pad

+X toward phone

Include wall, blend and adjacent flat pad

ID | Station | Capture and record
B1 | X = 0 | Short left nub centerline projected down to the crease.
B2 | X = 11 | Near the phone left edge.
B3 | X = 46.5 | Phone centerline; important for bottom seating.
B4 | X = 82 | Near the phone right edge.
B5 | X = 104 | Outside the long nub, beneath the right structural edge.

For B1-B5, span from the ledge side of the crease to at least Y = 30-40. Include the full lip. Record lip height above the pad, where the curve begins/ends, and the true contact boundary. At a rounded corner, do not pretend the surface reaches the extended Y = 0 line.

ID | Station | Capture and record
W1 / W2 | Y = 15 / 40 | Lower wall and transition out of the lower-left corner.
W3 | Y = 75 | Middle left edge.
W4 / W5 | Y = 120 / 150 | Alongside the left nub and near the camera end.

At each W station, capture the left wall through its inward blend onto flat pad; stop before a nub blocks the pins. Measure from the X = 0 centerline to a marked point on the trace so its lateral position is known. The trace lets us read wall clearance at Z = 0, 1, 2, 3 and 4.4. Do not apply the design clearance to the measurement.

# C: the lower-left corner in 3D

The outline seen from above and the rounding through thickness are different measurements. We need both.

### C-S: three upright sections through the corner

C-S1: 15 deg

C-S2: 45 deg

C-S3: 75 deg

Virtual corner | Along lower crease

Extend the straight wall and straight crease to their virtual intersection. Take upright gauge sections along rays approximately 15, 45 and 75 degrees into the pad from the lower-crease direction. Record the actual angle and offset if exact placement is impractical.

Each section must include the curved boundary plus flat pad. These three curves describe the compound blend. Do not replace them with one guessed fillet radius.

### C-P: three outlines parallel to the pad

ID | Height / plane | Method
C-P0 | At the pad surface | Trace the visible floor-to-wall boundary on thin paper, without pressing into the upholstery; mark any fuzzy transition band.
C-P1 | Z = 1.0 | Hold the gauge face parallel to the pad on checked spacers. Push pins into the corner from the open bay; capture the plan outline.
C-P4 | Z = 4.4 | Repeat at 4.4 above the same pad reference, or the nearest feasible height and report the actual value.

Include about 30 mm of each straight edge beyond the corner, using overlapping captures if needed. Keep X/Y reference lines, the virtual intersection and scale on the tracing. Thick pins sample a height band: record its lower and upper heights. If the gauge cannot fit at the requested height, use a thin paper/card template or record the closest accessible band.

Why: C-P records the actual plan shape replacing the provisional R15 corner; C-S and W record the console-facing rounding replacing the provisional R0.9 edge. A full profile is more useful than a radius value.

# N: cross-sections and length profiles

Measure the physical nubs themselves. Current cutout widths of 13.5 and 5.6 are design targets, not measured nub widths.

N-LX1

N-LX2

N-LX3

L: X = 0

N-LL

N-RX1

N-RX2

N-RX3

R: X = 93

N-RL

Lower crease: Y = 0

Purple: three upright
cross-sections, perpendicular to each nub.

Teal: one upright length profile through each nub centerline.

Record the full shape, including the crown and flat pad on both sides/ends.

IDs | Station along each nub | Approximate model Y (L / R)
N-LX1 / N-RX1 | 10 above the physical lower end | 98.9 / 29.1
N-LX2 / N-RX2 | Halfway between physical ends | 120.7 / 86.4
N-LX3 / N-RX3 | 10 below the physical upper end | 142.4 / 143.7
N-LL / N-RL | Along centerline, entire length | X = 0 / X = 93

Find the actual end positions first; the Y numbers above are locating estimates from the model. If they differ, use the physical ends and write down the actual station. For length profiles include 10 mm of flat pad beyond both ends; a long right profile may need two captures with at least 25 mm of shared, labeled overlap.

What we extract: maximum nub height, width versus height, asymmetric sides, how each end rises from the pad, and end positions versus height. Capture full curves; you do not need to calculate radii or manually extract every width.

# N: the rounded nub ends in plan

These horizontal profiles resolve end shapes that a straight centerline section misses. Take four outlines per nub.

### Gauge face parallel to the pad

Z = 0 pad reference

Low plane: 1 mm

Second plane

Each end viewed from above

lower

upper

Capture end + straight sides

End | Low profile ID / Z | Near-rim profile ID / Z
Left lower | N-LB1 / 1.0 | N-LBT / about 2.9
Left upper | N-LT1 / 1.0 | N-LTT / about 4.2
Right lower | N-RB1 / 1.0 | N-RBT / about 1.5
Right upper | N-RT1 / 1.0 | N-RTT / about 4.2

Support the gauge on measured spacers on adjacent flat pad so the pin contact line lies at the stated Z. Account for the gauge body thickness; spacer thickness alone may not equal the measurement height. Approach a lower end from below (-Y) and an upper end from above (+Y). Keep the gauge face parallel to the pad; include both side transitions and some straight flank.

Record actual Z, centerline and Y. Thick pins sample a height band: record both lower and upper tip-edge heights. If they cannot fit at 1 mm, use the nearest accessible band or a thin card template and label it. The second heights approximate V5 rim heights, not nub heights. Above the nub, record "above crown - no intersection".

Sloped print: the V5 upper surface is Z = 1 + 0.02123 x Y, so it cuts each nub at a different height along its length. Full length and cross profiles let us reconstruct that intersection. A single constant-height outline cannot verify the entire sloped opening.

If horizontal capture is impossible, mark that ID inaccessible and send a scaled end view plus the upright length profile. This is partial evidence; unresolved fine curves remain provisional.

# Dimensions the gauge cannot settle alone

Use a ruler, calipers or a straightedge for these checks. Keep raw console measurements separate from desired print clearance.

Check | What to record | Why it matters
Nub locations | Both lower/upper Y endpoints; centerline spacing at lower, middle and upper accessible stations. Measure common-height centers, not unlike tapered edges. | Confirms datums and detects nonparallel nubs. Current model: X spacing 93; L Y 88.9-152.4; R Y 19.05-153.67.
Nub width and height | At all six N-X stations: crown height, base/contact width, and any clearly accessible width at a known Z. Include fabric; do not squeeze it. | Checks the requested 13.5 underside / 5.6 upper apertures against the real surface.
Pad flatness | Straightedge along clear lanes near X = -10, 46.5 and 104; record any gaps and their Y locations. Avoid nubs and the lower blend. Also check across the phone bay at Y = 40, 75, 105 and 150. | Distinguishes console bow or high spots from wrong perimeter curvature.
Left edge fit | At W stations, note interference or gap with V5 resting freely; measure accessible gaps. Mark contact points on a photo.

Tests the 2 mm inward change without adding clearance twice.

Phone seating With the phone naturally seated, record bottom-to-crease gap, lateral position, rocking and visible contact points, first bare and then with the inserts.

Checks the lower 36 mm keepout and whether the phone actually reaches the crease.

Lens contact, if present | Use a scaled photo of the phone back for each ring center (X from phone left, Y from bottom), outer diameter and any safely measurable projection.

The recorded 5 mm projection predicts possible contact; no contour gauge can establish optical clearance.

Use only light contact. Keep hard gauge pins and caliper jaws off lens glass. Record "not measurable" for inaccessible gaps; do not force the phone down to make a measurement. The phone body 71.1 x 150 and housing 64.5 x 41.5 at Y = 105 are already supplied, so remeasure only if you find a discrepancy.

### Return package

Send the labeled profile photos/traces, the completed log, and one overall console photo showing the marked stations. Include gauge pin spacing, actual profile heights, any missing/inaccessible captures and observations from the bare-phone/V5 comparison. We will derive CAD curves and apply fit clearance afterward.

# Capture log

Use the same ID on the console placement photo, the profile photograph and the paper trace. Log actual positions, not just target positions.

ID | Target station / plane | Actual + repeat spread | Photo / trace name
B1 | X = 0
B2 | X = 11
B3 | X = 46.5
B4 | X = 82
B5 | X = 104
W1 | Y = 15
W2 | Y = 40
W3 | Y = 75
W4 | Y = 120
W5 | Y = 150
C-S1 | 15 deg from lower crease
C-S2 | 45 deg from lower crease
C-S3 | 75 deg from lower crease
C-P0 | floor boundary
C-P1 | Z = 1.0
C-P4 | Z = 4.4
N-LX1 | Y approx. 98.9
N-LX2 | Y approx. 120.7
N-LX3 | Y approx. 142.4
N-RX1 | Y approx. 29.1
N-RX2 | Y approx. 86.4
N-RX3 | Y approx. 143.7
N-LL | X = 0; full length
N-RL | X = 93; full length
N-LB1 | Z = 1.0
N-LBT | Z approx. 2.9
N-LT1 | Z = 1.0
N-LTT | Z approx. 4.2
N-RB1 | Z = 1.0
N-RBT | Z approx. 1.5
N-RT1 | Z = 1.0
N-RTT | Z approx. 4.2

Pin spacing / tip thickness: ______ / ______ Ruler/caliper resolution: ______

Missing / inaccessible profiles: __________________________________________
