hbmartin/tesla-iphone-holder/output/measurement-guide/grid-preview.png

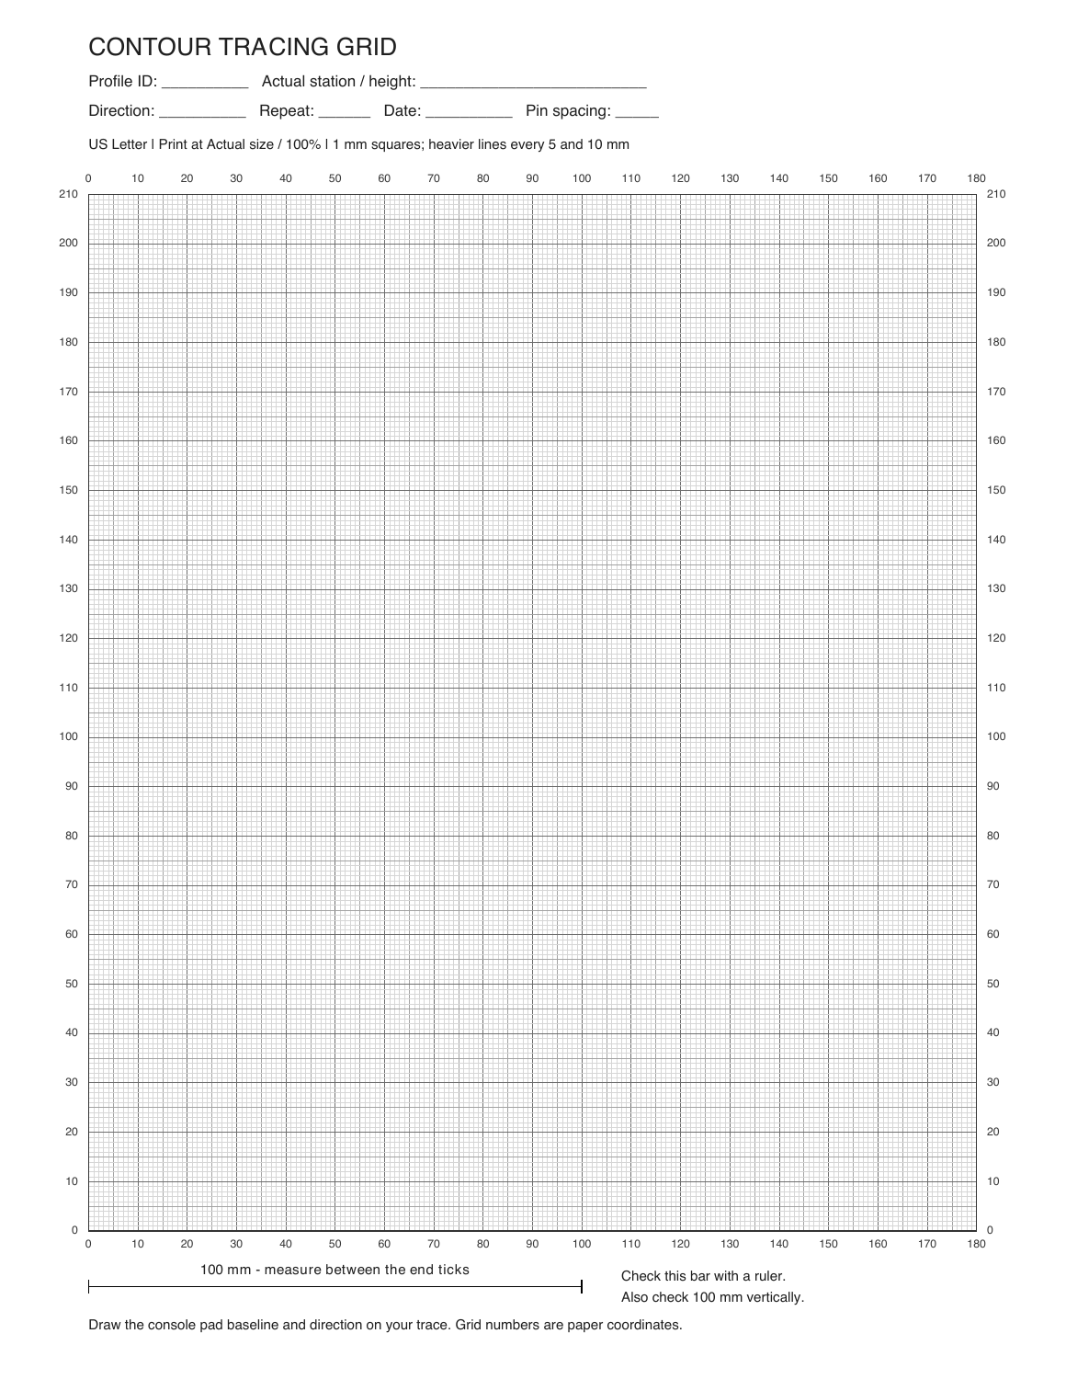
output/measurement-guide/grid-preview.png
