hbmartin/tesla-iphone-holder/output/measurement-guide/page-1.png

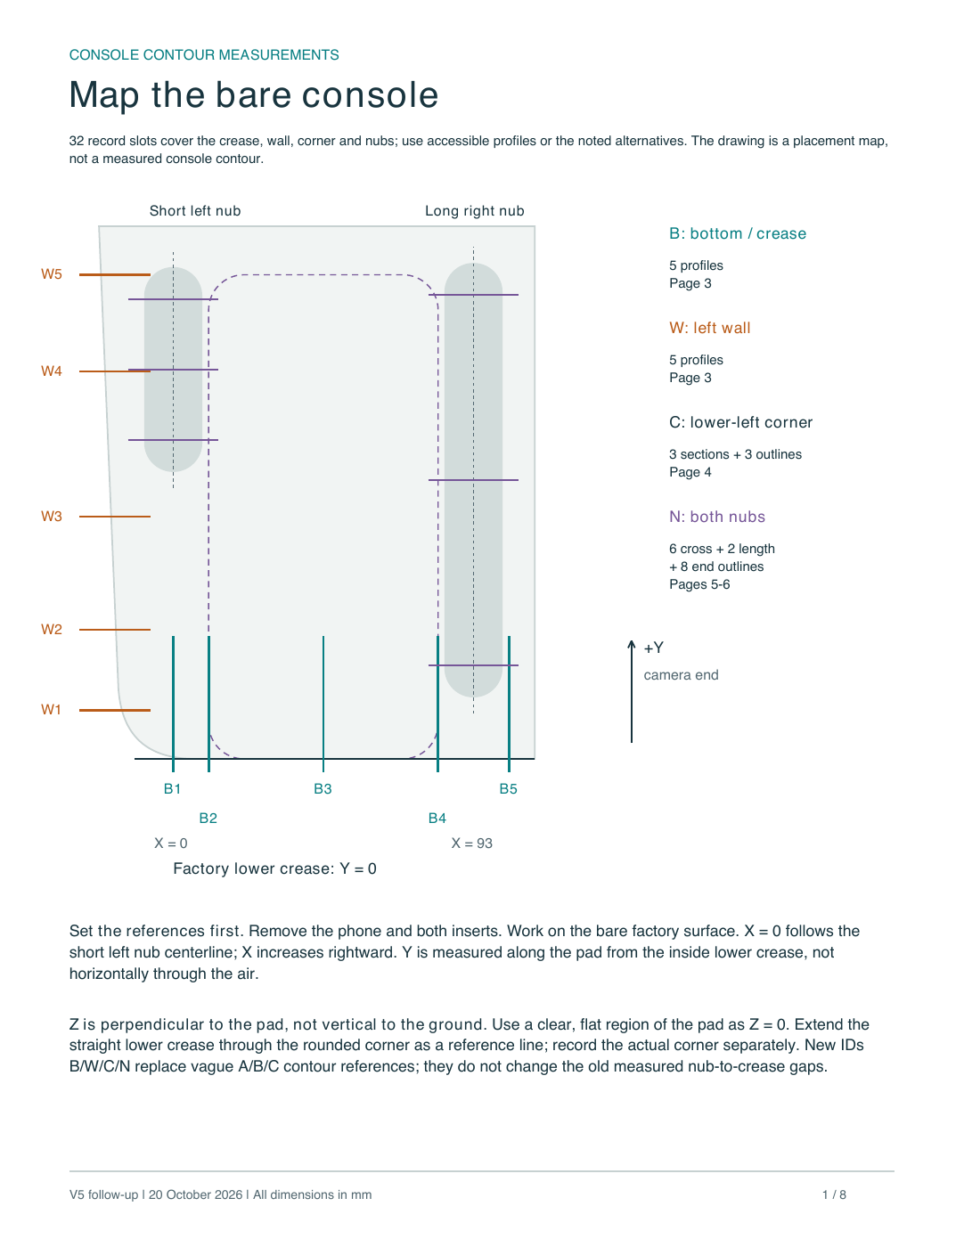
output/measurement-guide/page-1.png
