hbmartin/tesla-iphone-holder/output/measurement-guide/page-2.png

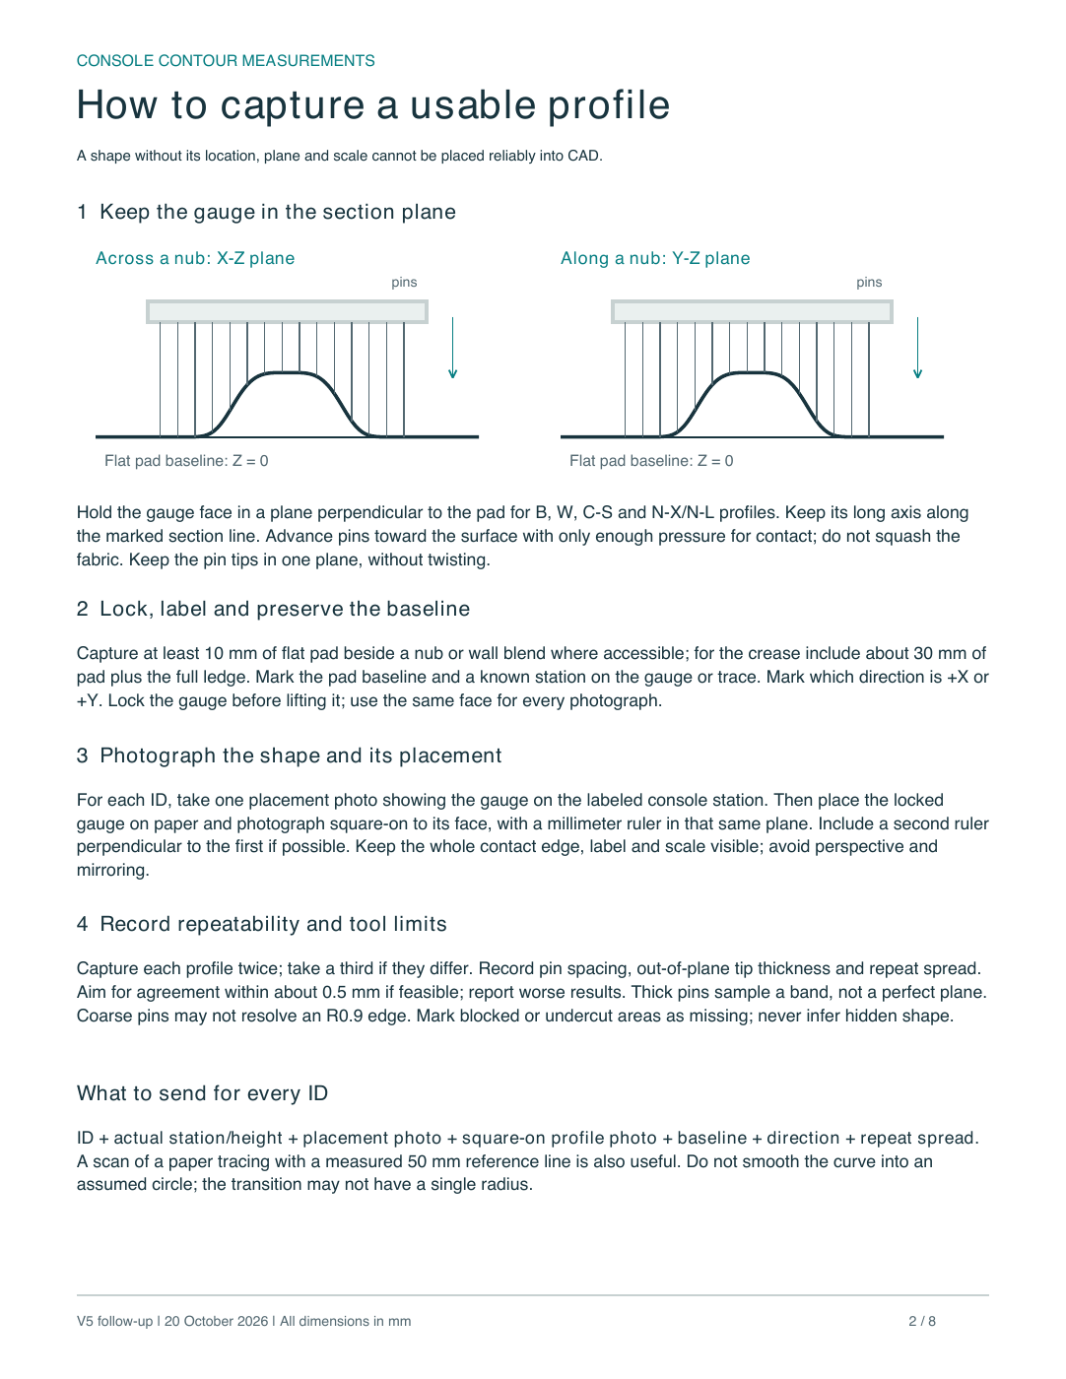
output/measurement-guide/page-2.png
