hbmartin/tesla-iphone-holder/output/measurement-guide/page-3.png

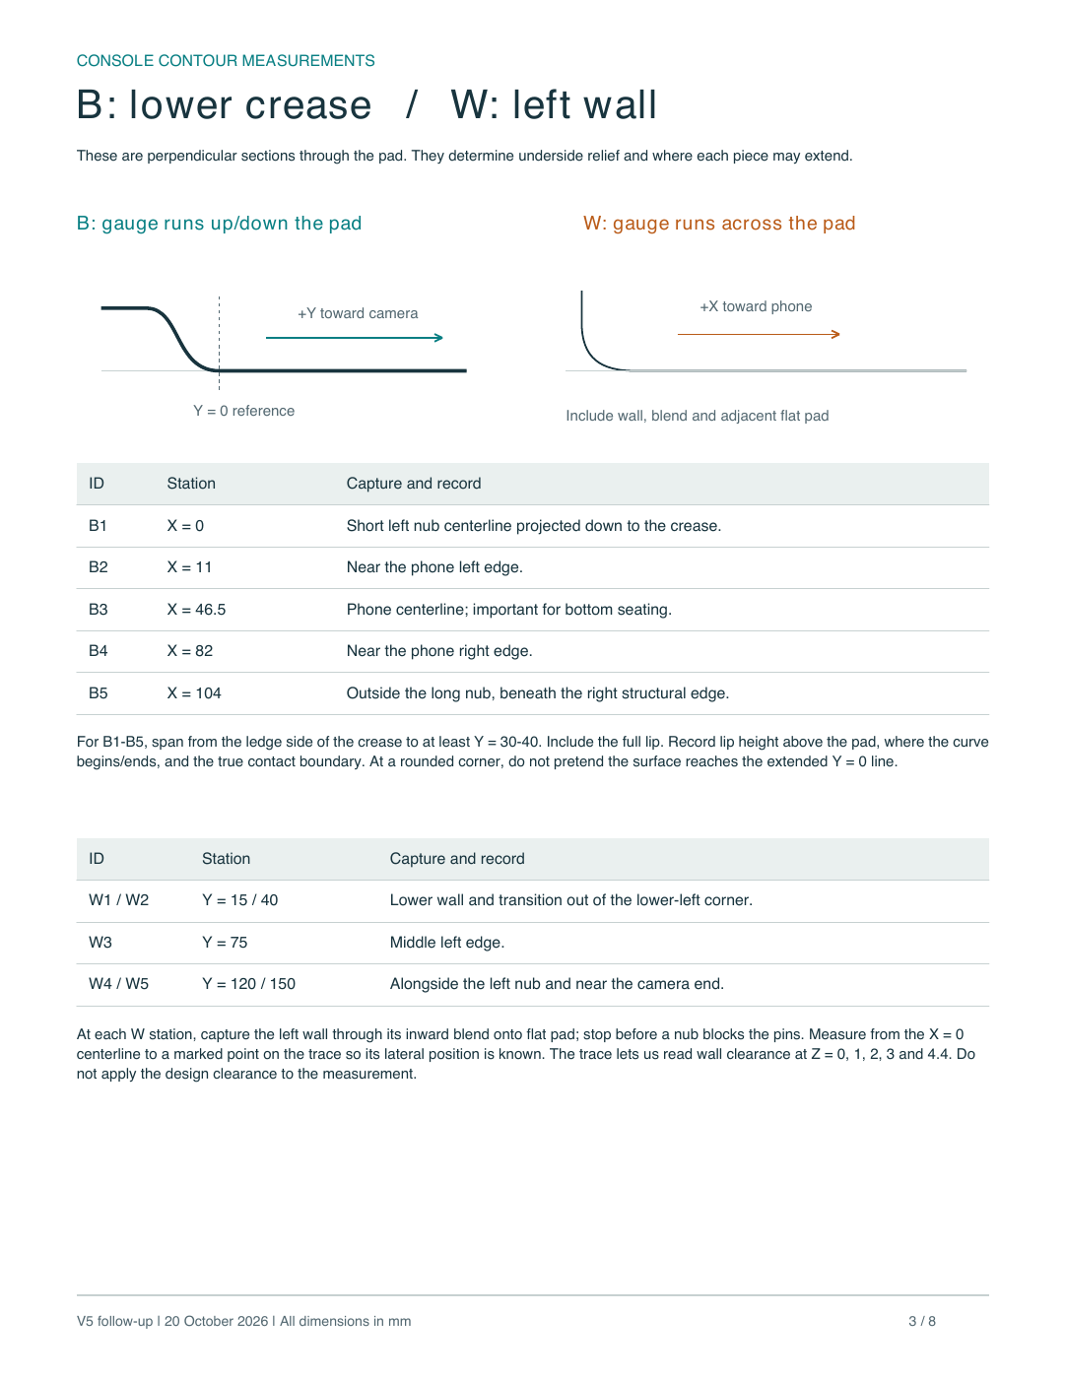
output/measurement-guide/page-3.png
