hbmartin/tesla-iphone-holder/output/measurement-guide/page-4.png

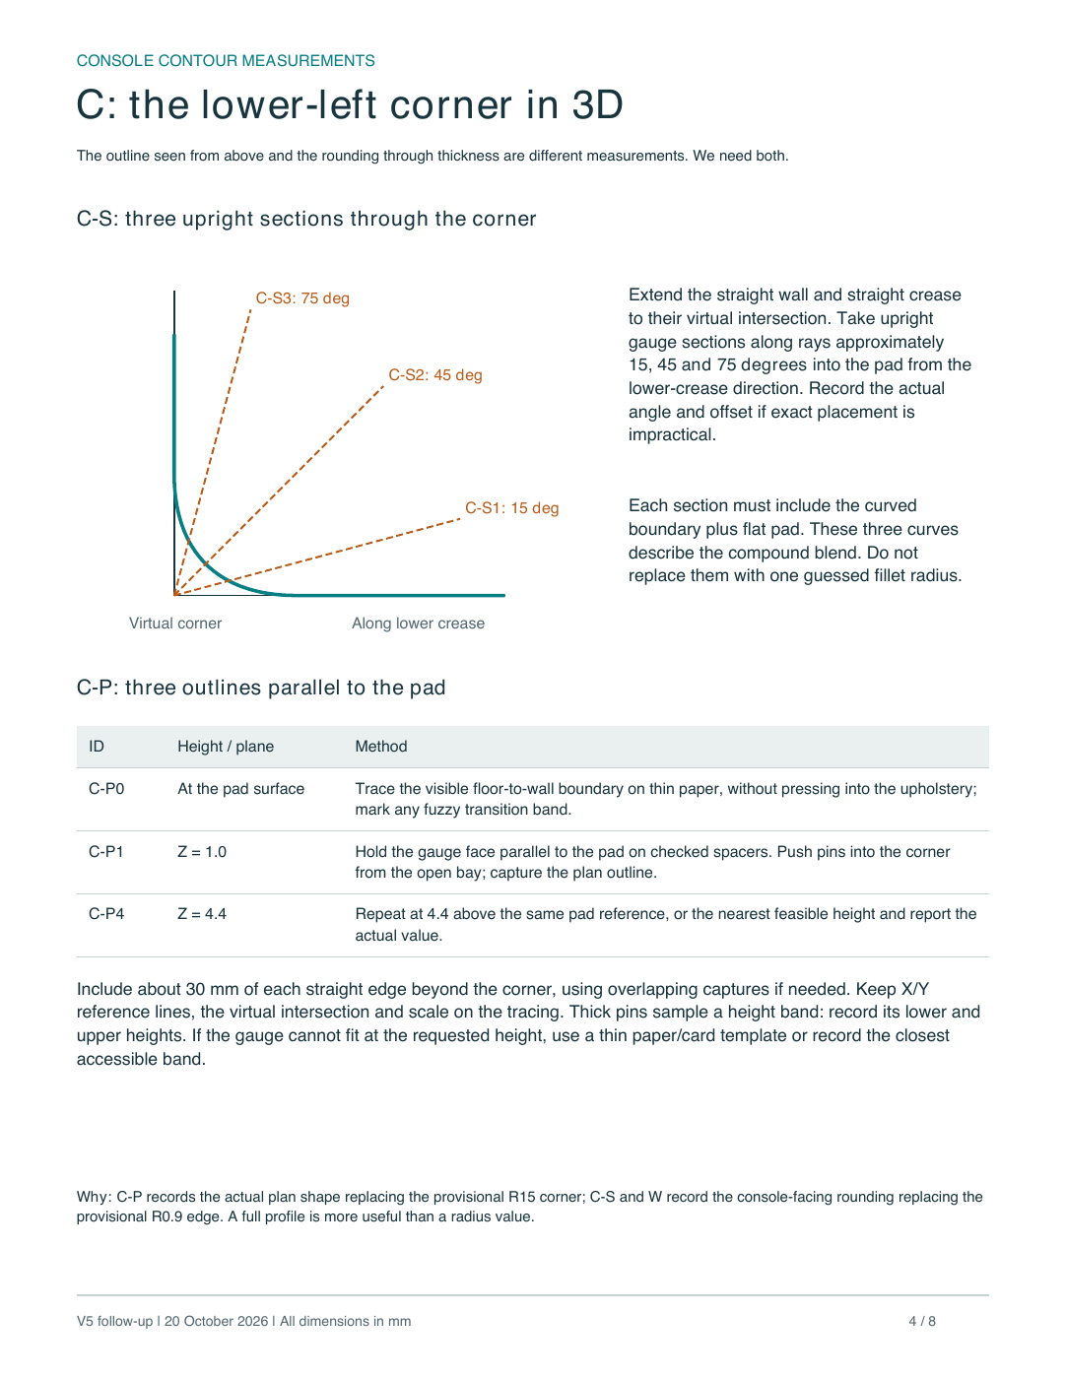
output/measurement-guide/page-4.png
