hbmartin/tesla-iphone-holder/output/measurement-guide/page-5.png

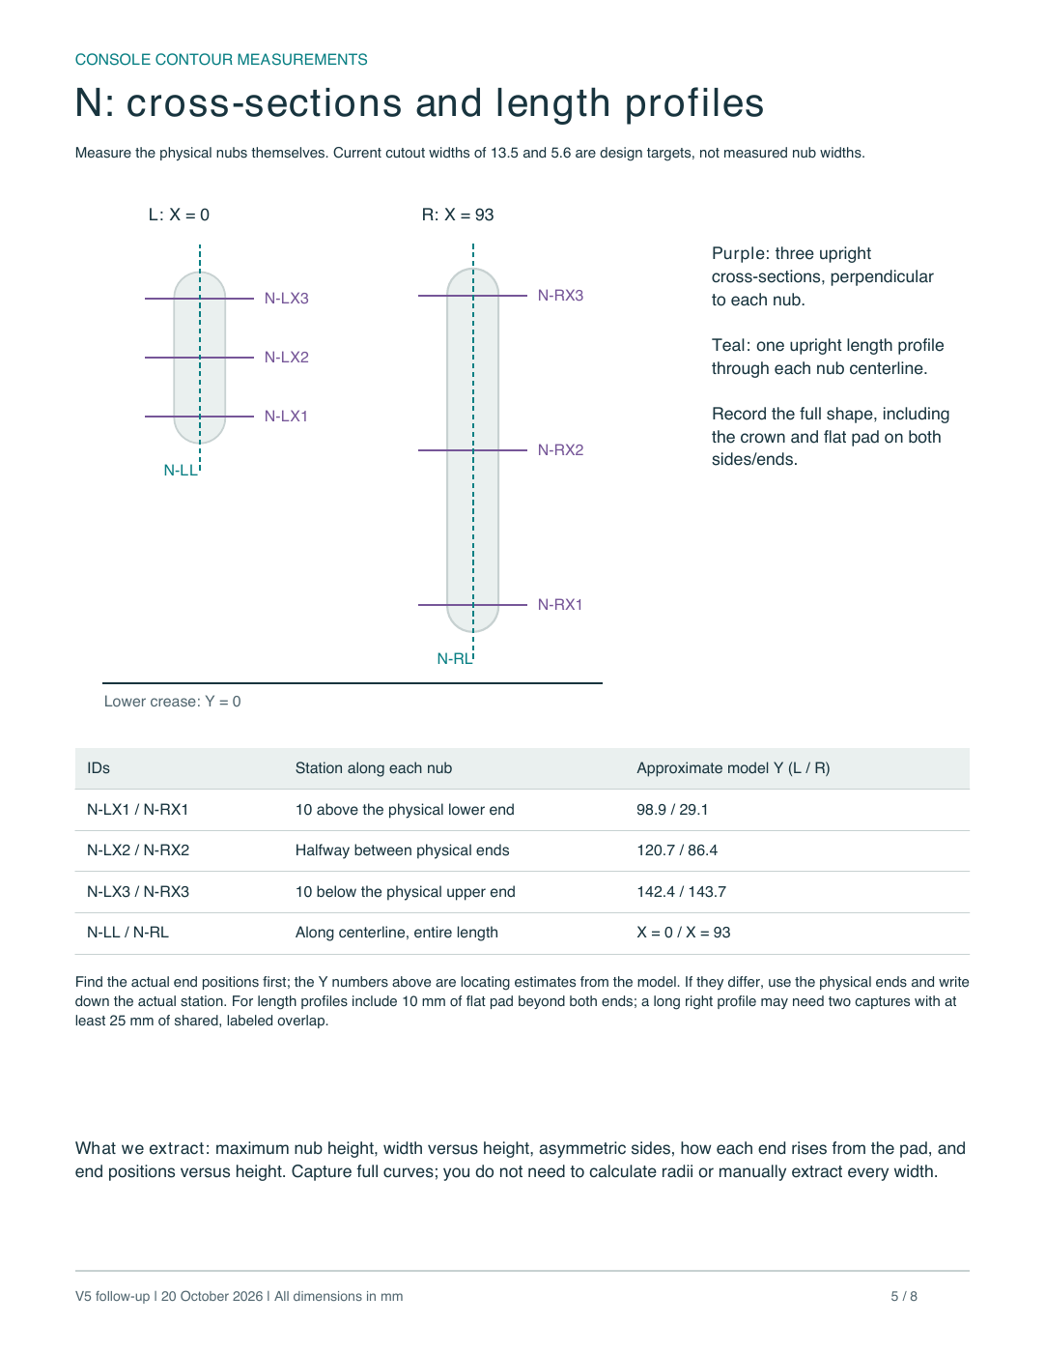
output/measurement-guide/page-5.png
