hbmartin/tesla-iphone-holder/output/measurement-guide/page-6.png

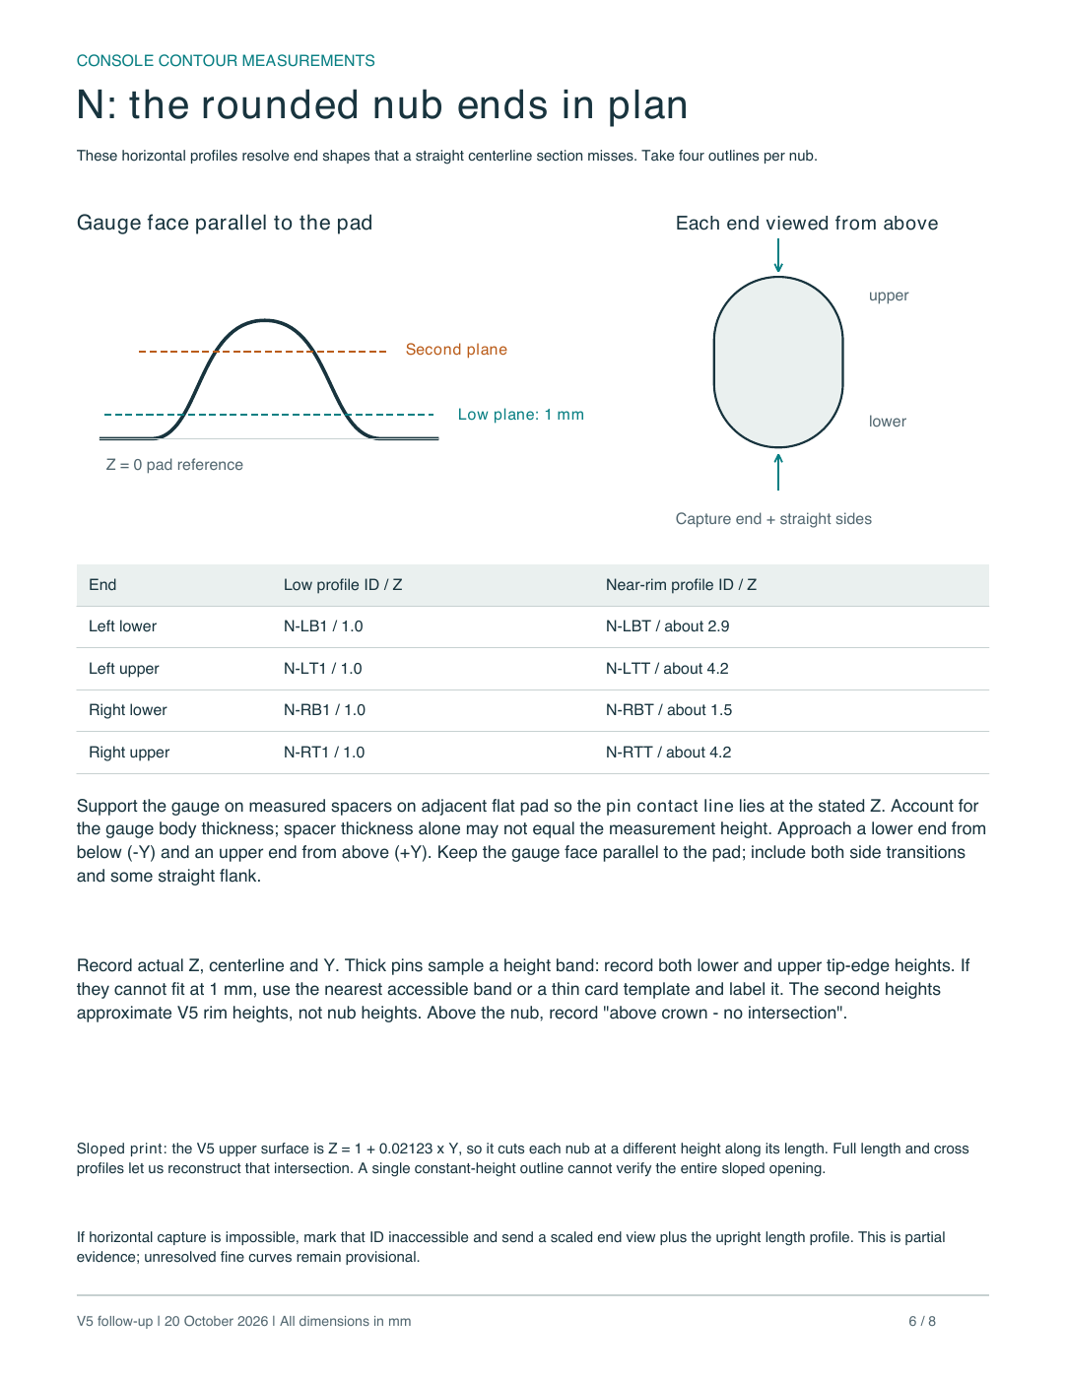
output/measurement-guide/page-6.png
