hbmartin/tesla-iphone-holder/output/measurement-guide/page-7.png

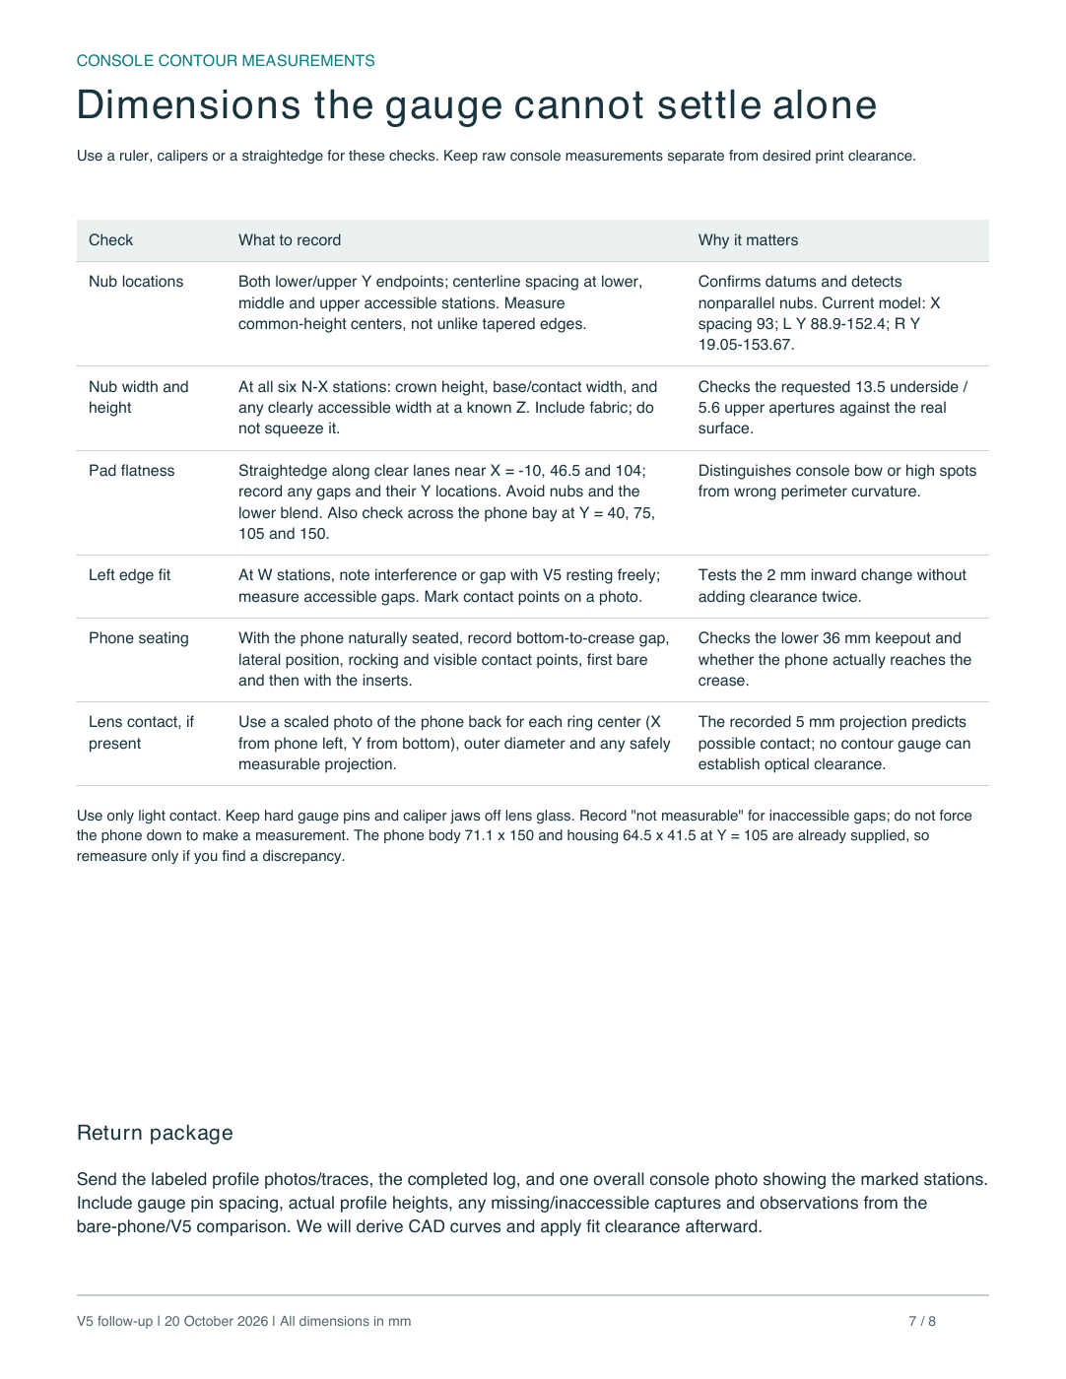
output/measurement-guide/page-7.png
