hbmartin/tesla-iphone-holder/output/measurement-guide/page-8.png

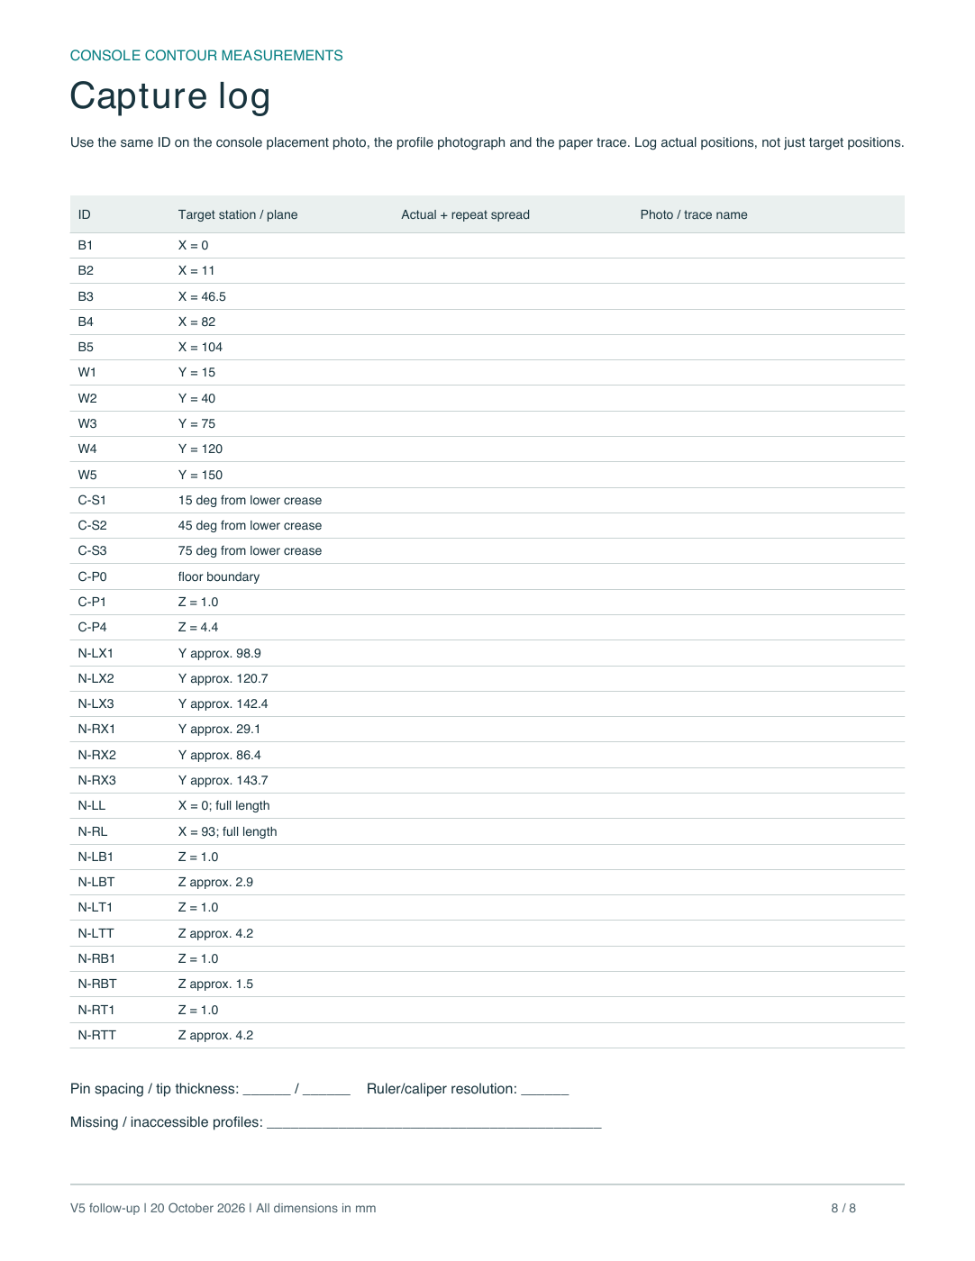
output/measurement-guide/page-8.png
