hbmartin/tesla-iphone-holder/output/previews/assembly_3d.png

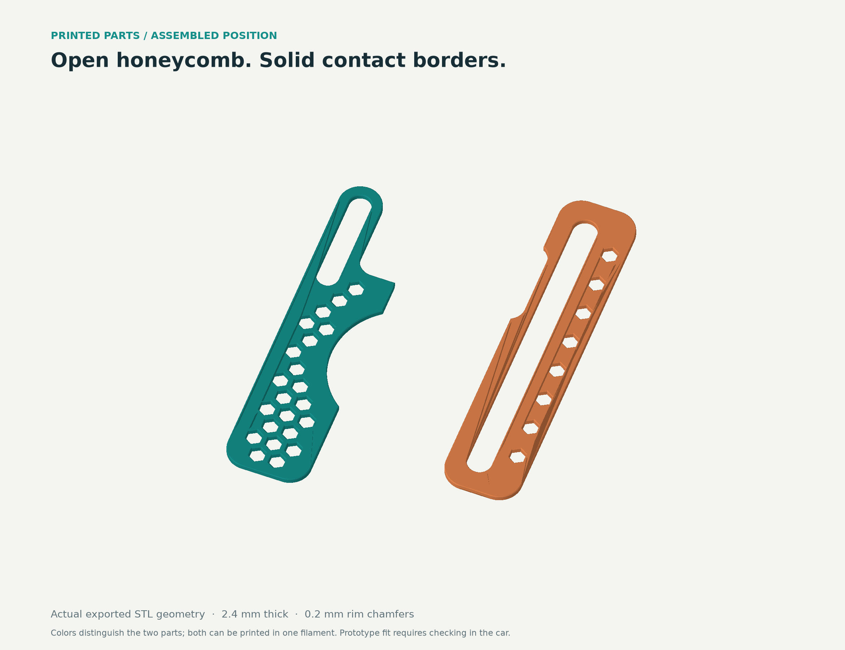
output/previews/assembly_3d.png
