hbmartin/tesla-iphone-holder/output/v10/previews/assembly_3d.png

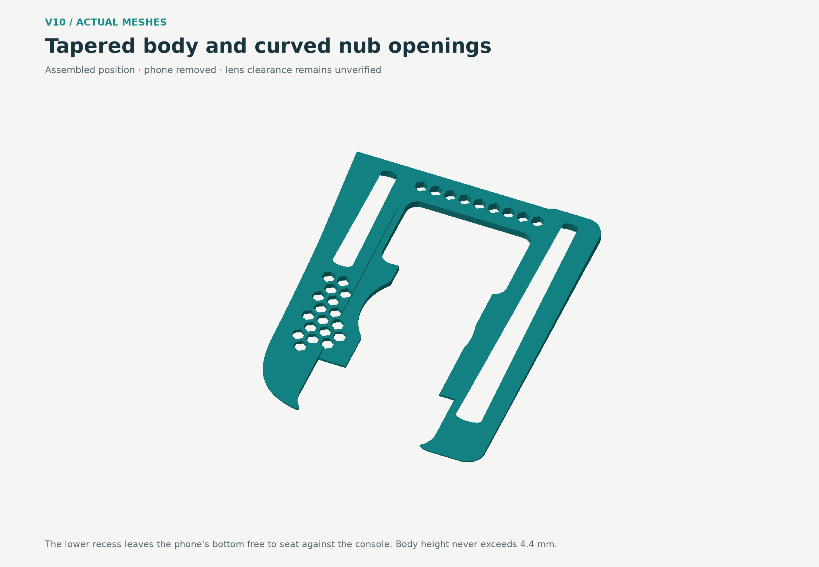
output/v10/previews/assembly_3d.png
