hbmartin/tesla-iphone-holder/output/v10/previews/assembly_top.png

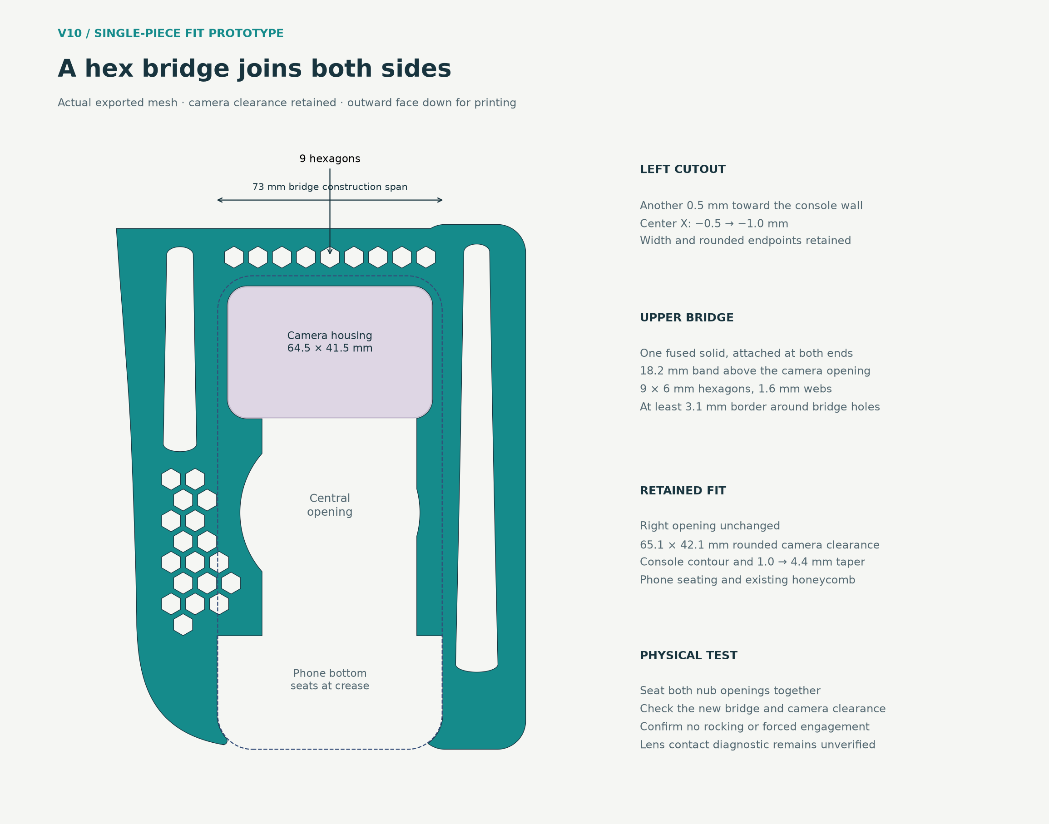
output/v10/previews/assembly_top.png
