hbmartin/tesla-iphone-holder/revisions/v3-draft/output/previews/assembly_3d.png

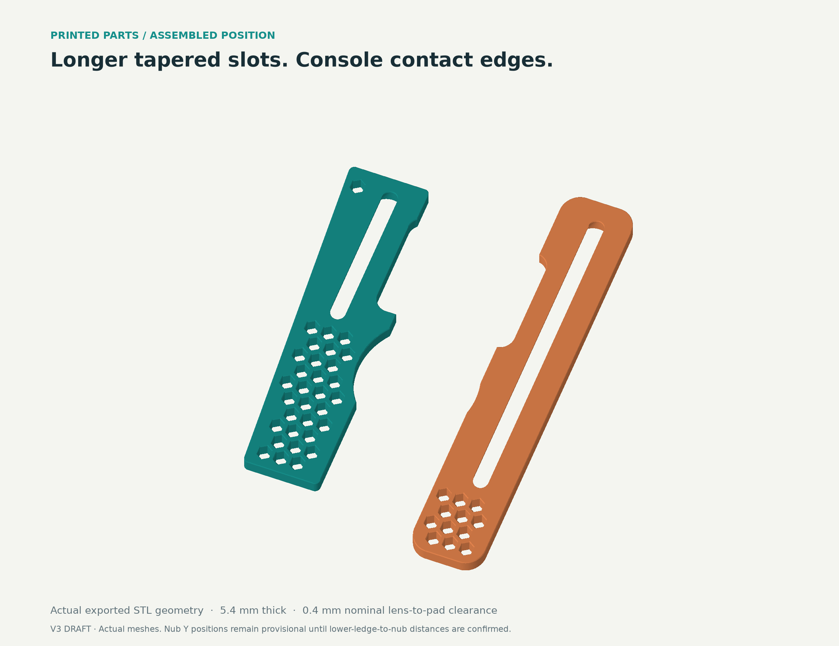
revisions/v3-draft/output/previews/assembly_3d.png
