hbmartin/tesla-iphone-holder/output/fit-measurements-v7/page-1.png

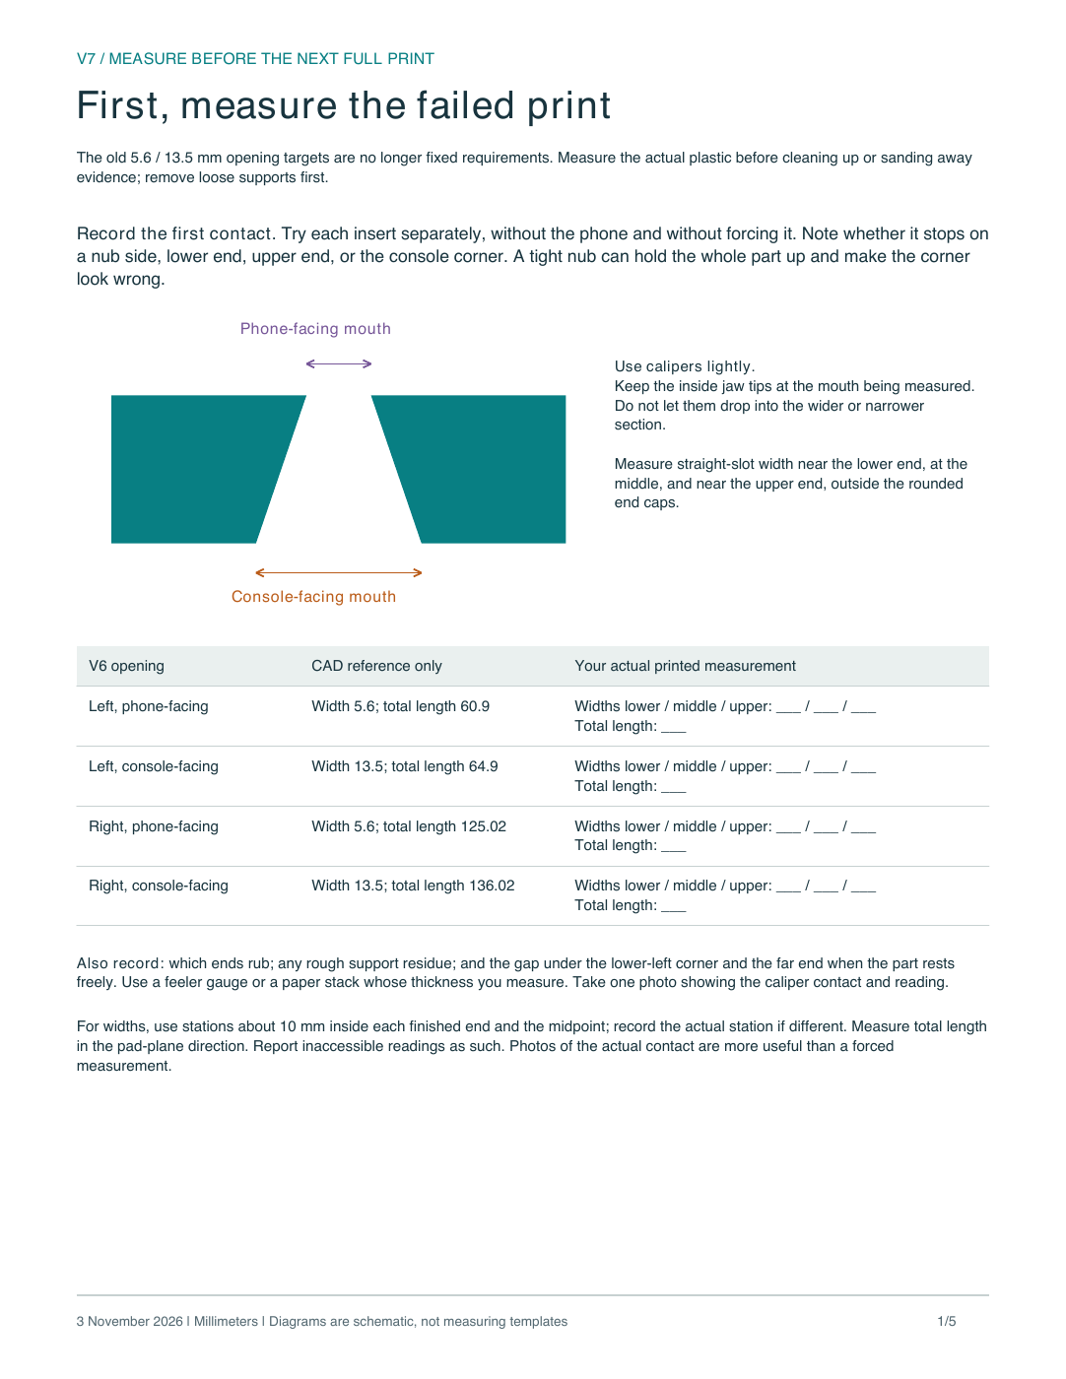
output/fit-measurements-v7/page-1.png
