hbmartin/tesla-iphone-holder/output/fit-measurements-v7/page-2.png

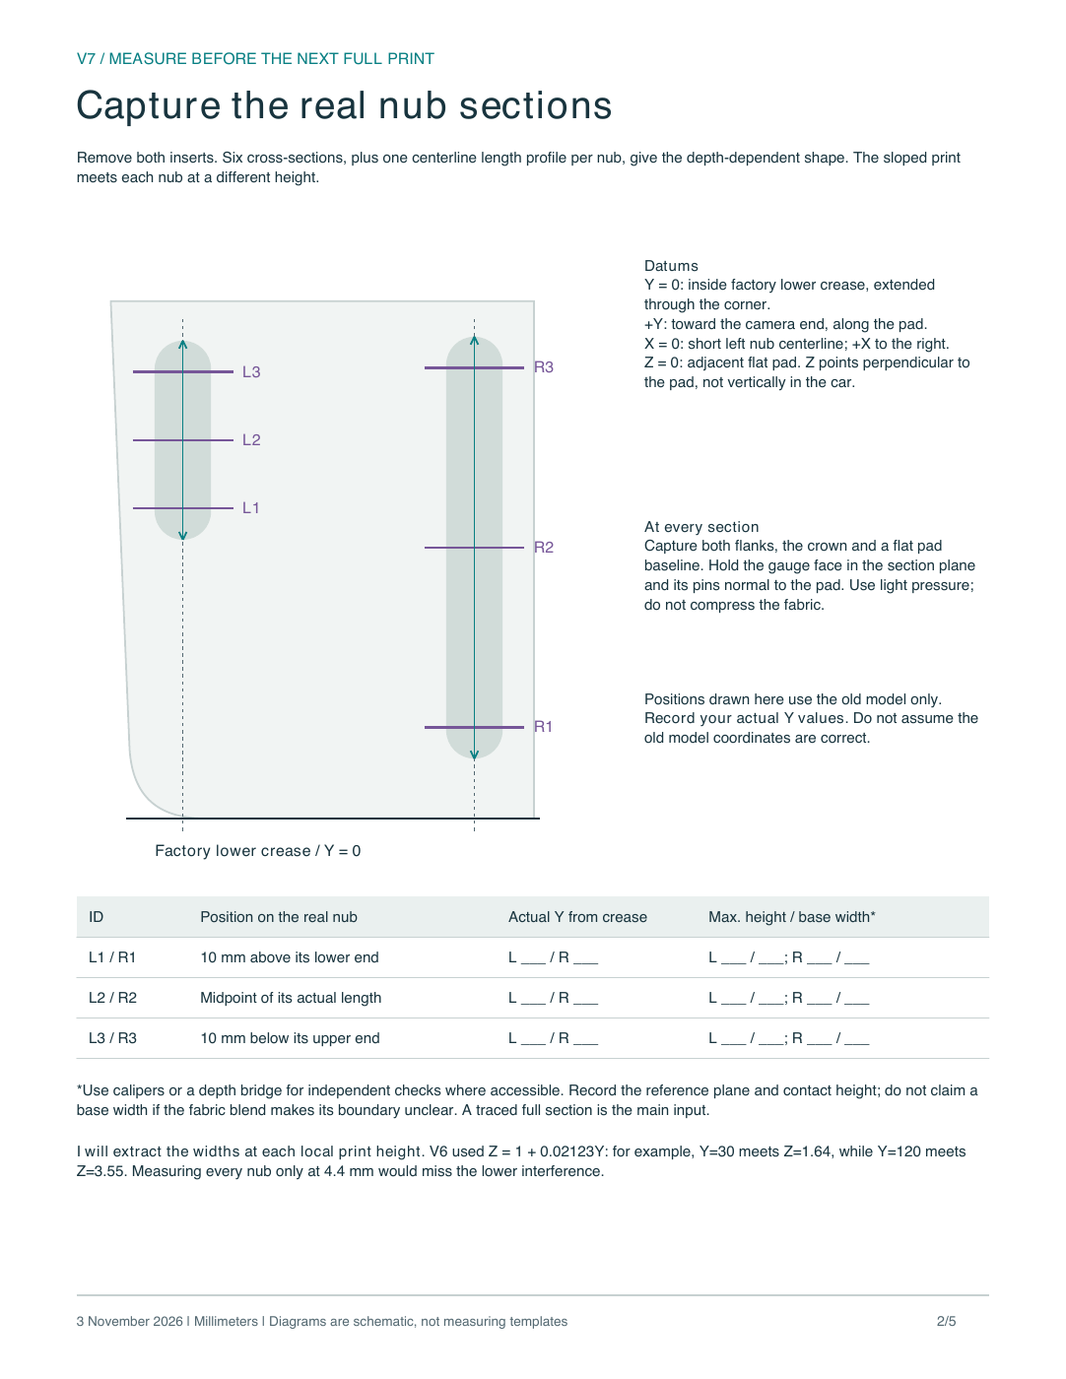
output/fit-measurements-v7/page-2.png
