hbmartin/tesla-iphone-holder/output/fit-measurements-v7/page-3.png

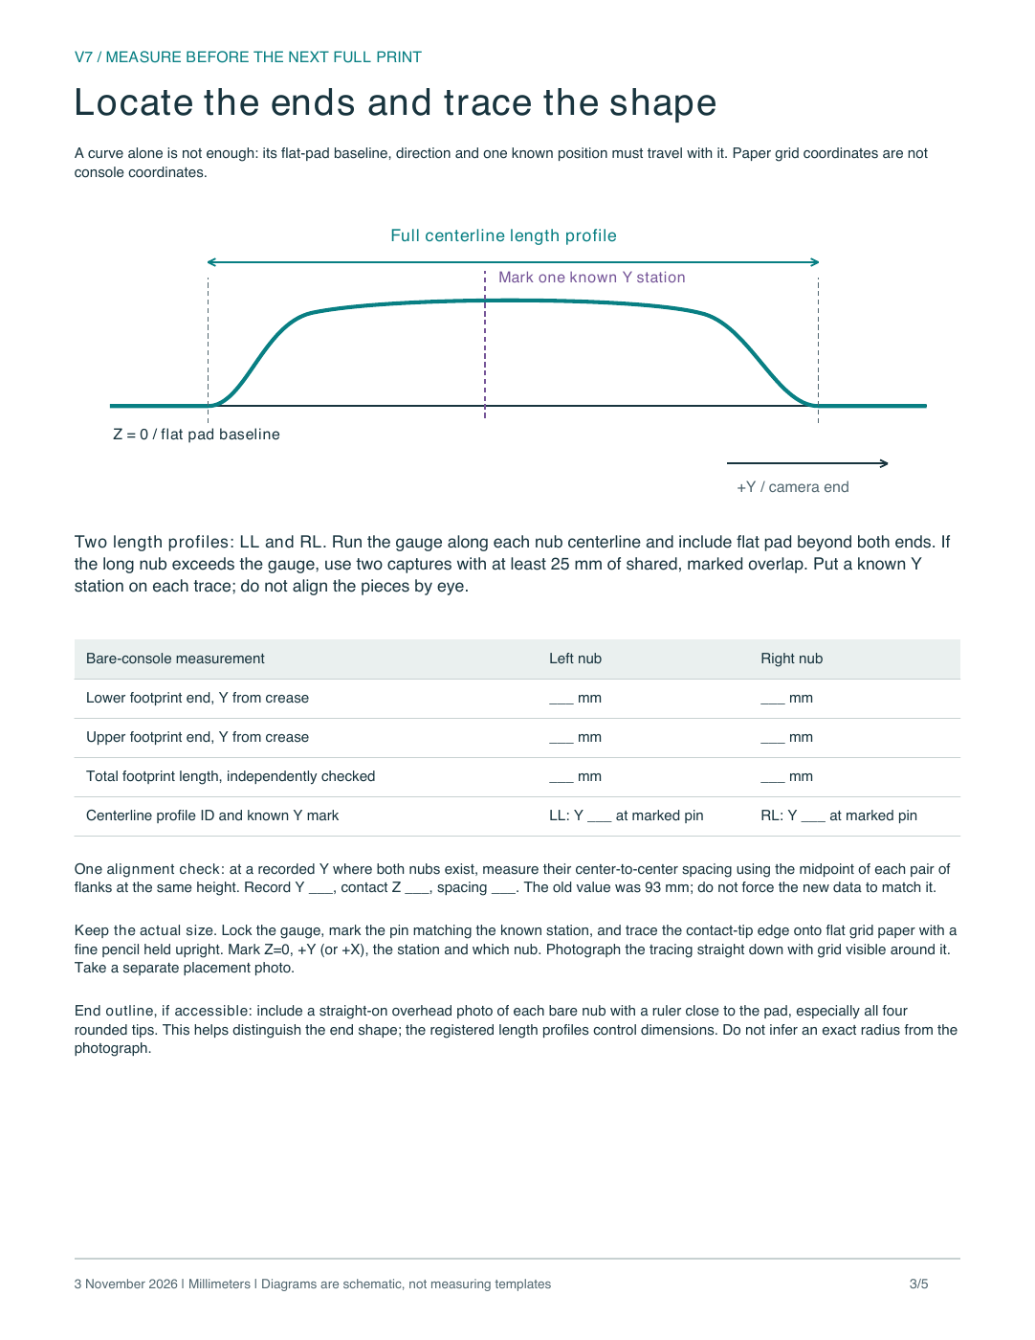
output/fit-measurements-v7/page-3.png
