hbmartin/tesla-iphone-holder/output/fit-measurements-v7/page-4.png

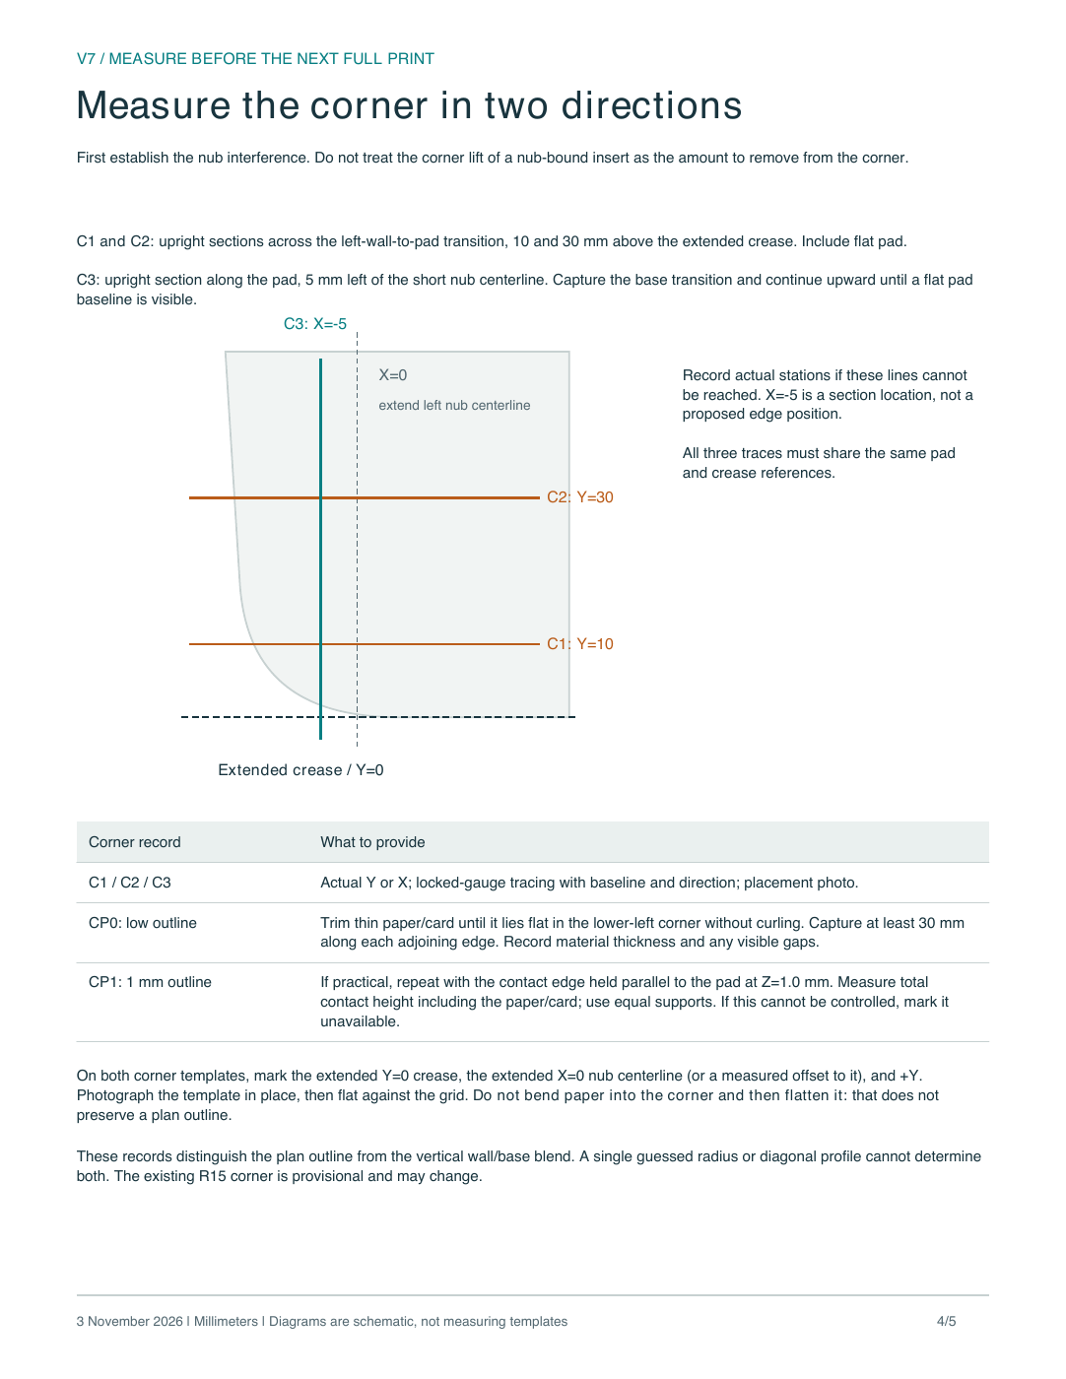
output/fit-measurements-v7/page-4.png
