hbmartin/tesla-iphone-holder/output/fit-measurements-v7/page-5.png

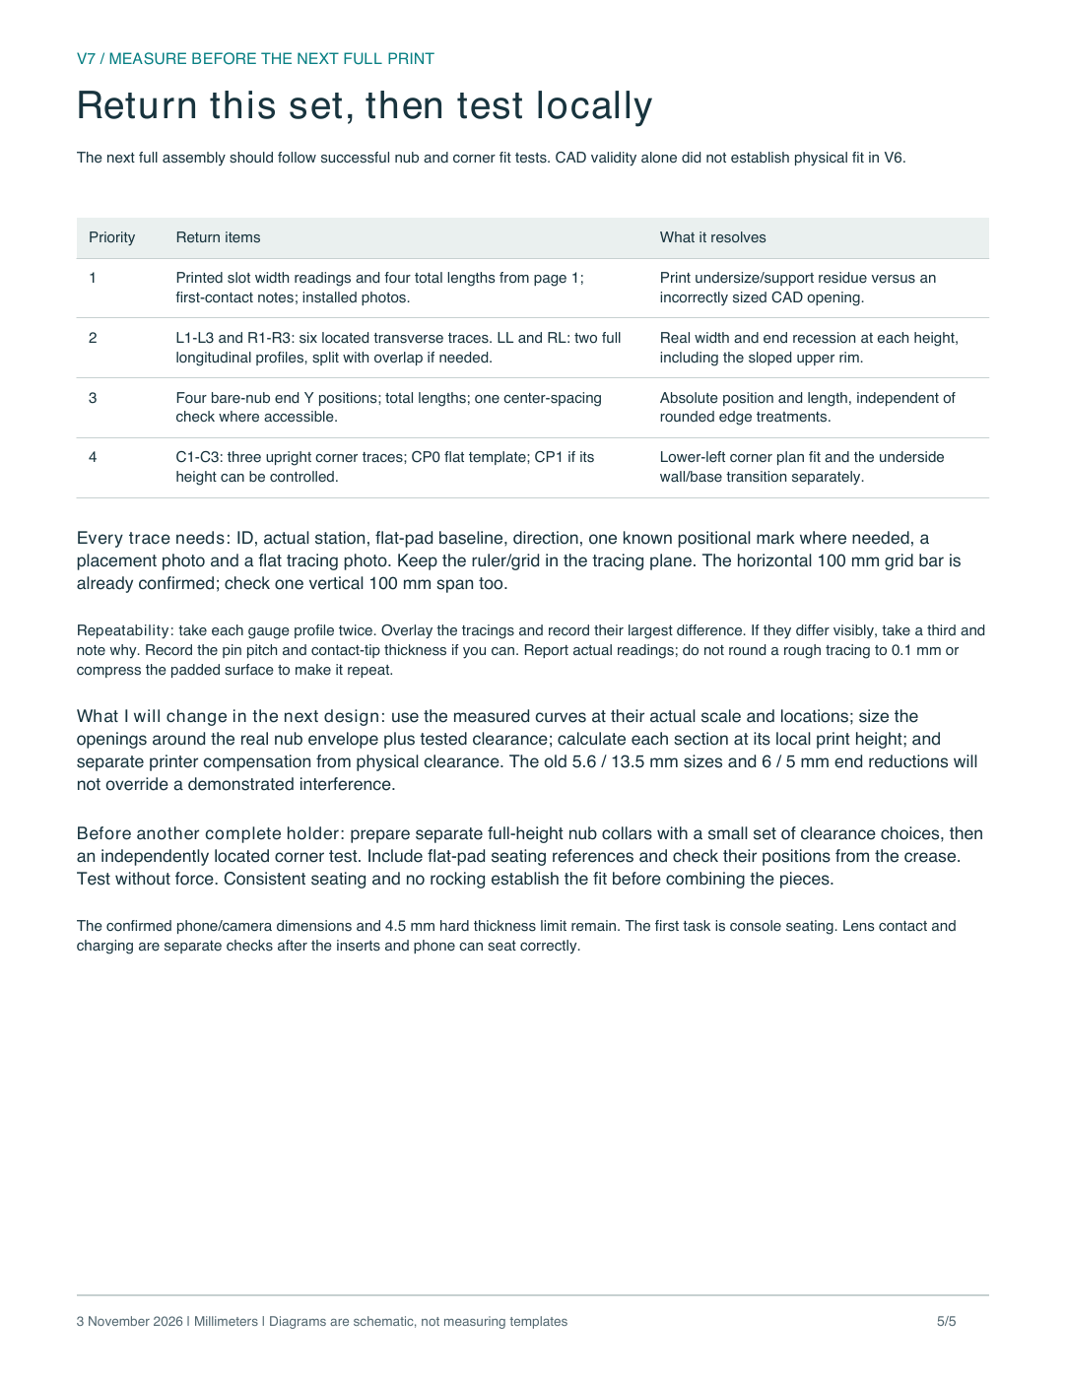
output/fit-measurements-v7/page-5.png
