hbmartin/tesla-iphone-holder/output/v7-fit-review/measurements_needed.png

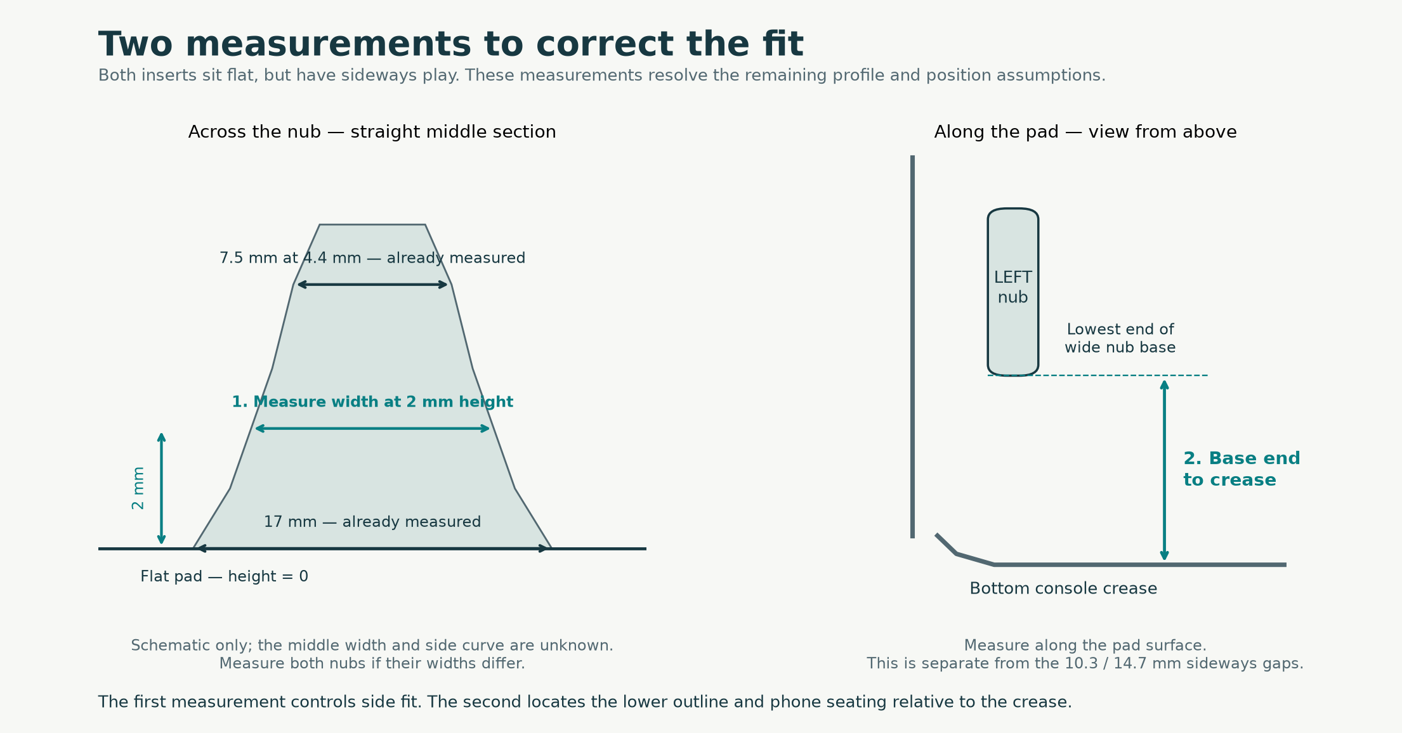
output/v7-fit-review/measurements_needed.png
