hbmartin/tesla-iphone-holder/revisions/v3-draft/output/reference/measurements_needed.png

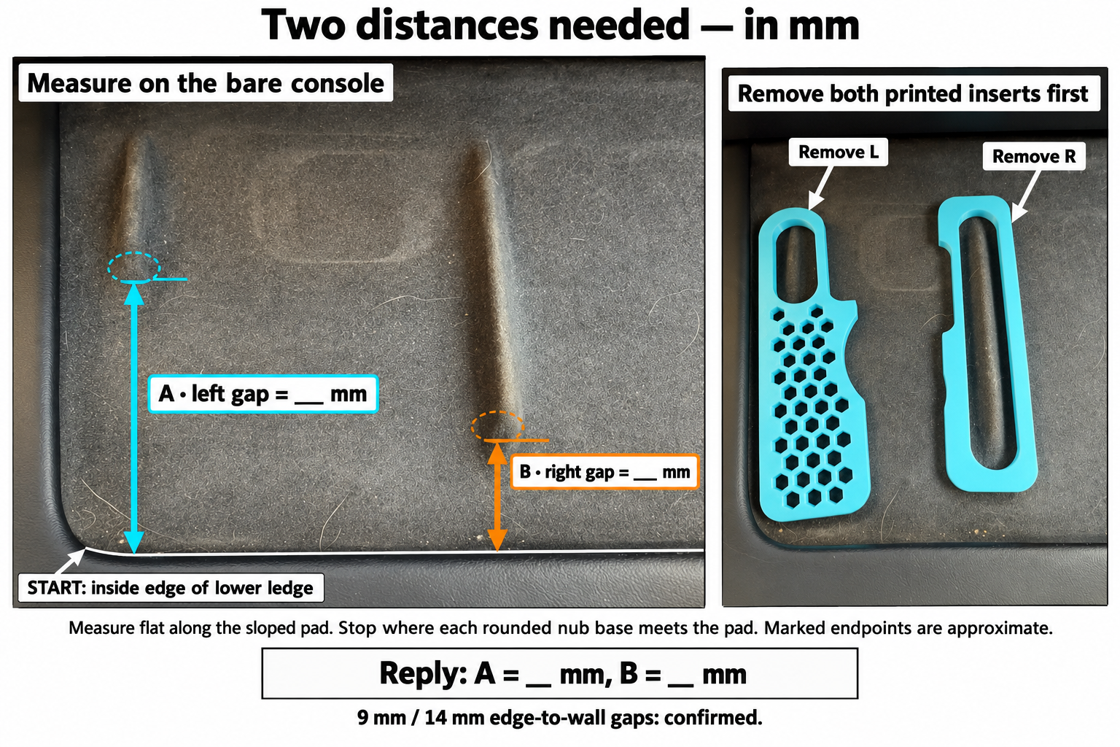
revisions/v3-draft/output/reference/measurements_needed.png
