hbmartin/tesla-iphone-holder/revisions/v3-draft/output/previews/fit_gauges.png

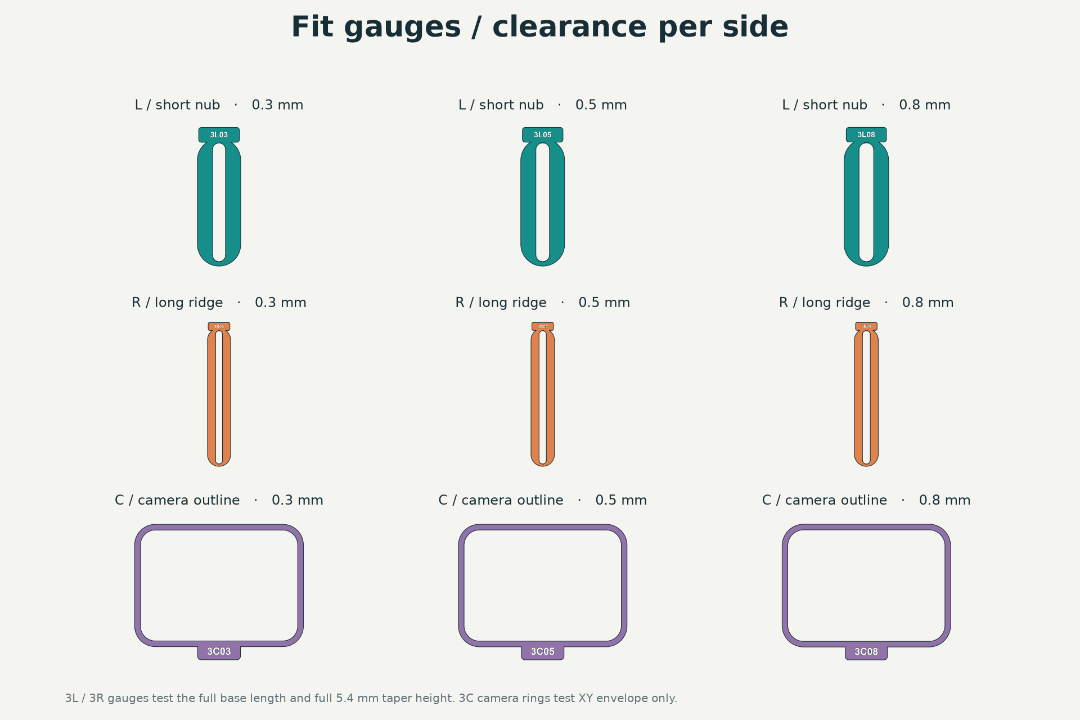
revisions/v3-draft/output/previews/fit_gauges.png
