hbmartin/tesla-iphone-holder/(commit log)

2026-10-20 closing in on final design
    [Fit_tests_A1_PLA.3mf, Fit_tests_A1_PLA_layout.3mf, Fit_tests_V2_A1_PLA.3mf, Fit_tests_V3_A1_PLA.3mf, Holder_A1_PLA_PROTOTYPE.3mf, Holder_A1_PLA_PROTOTYPE_layout.3mf, Holder_V2_A1_PLA_PROTOTYPE.3mf, Holder_V3_A1_PLA_PROTOTYPE.3mf]
2026-11-08 unified version
    [Fit_tests_V7_A1_PLA.3mf, Fit_tests_V7_A1_PLA.gcode.3mf, Fit_tests_V7_A1_PLA_SLICED.3mf, Fit_tests_V8_A1_PLA.3mf, Fit_tests_V8_A1_PLA.gcode.3mf, Fit_tests_V8_A1_PLA_SLICED.3mf, Holder_V10_A1_PLA_OUTWARD_FACE_DOWN.3mf, Holder_V10_A1_PLA_OUTWARD_FACE_DOWN.gcode.3mf]
